peterpanstechland/RoboPlanter/docs/deployment/docs-hardware-20261029.md

# 文档与接线更新 · 2026-10-29

本次只更新文档、公开网站和接线教学，不刷写设备或修改本地凭据。事实基线为此前固件、联调记录以及用户最后确认的手机实时土壤/温湿度查询。

## 更新范围

- 手册18页/语言：新增当前硬件连接、YOYO日常交互、补齐此前遗漏的日签发布页；同步根README和固件入口说明。
- 当前外设：SEN54独立5V且信号3.3V；SERVO1继电器GPIO42空载、SERVO2超声波GPIO8、SERVO3环境光GPIO1、SERVO4打印GPIO7，返回GPIO44；RGB GPIO40；Indicator土壤GPIO27与内置蜂鸣器GPIO19。M2及GPIO43不用。
- 交互接线图更新九个接口/预留位置、供电与信号路线、模块模型；预留口只确认留空。SVG总览和离线HTML同步。
- 更新Skill 0.4.0、配对码位置、共享番茄钟、场景打印开关/冷却、已验收与待测边界。
- 白名单下载包补充bonded_access/focus_session/sen54/water_tank依赖，保留私有文件隔离。

## 检查

- public-starter测试7项通过，包含本地固件头文件及核心测试脚本的依赖完整性、逐文件哈希、确定性、隐私排除和三张新增页面的双语言导出。
- Honor Skill包测试2项通过；下载版本0.4.0，不含旧单次读取密钥。
- 三个接线JavaScript文件语法检查通过。
- Docusaurus en/zh-Hans生产构建通过。既有webpack依赖警告和缓存写入提示不影响输出。
- 浏览器查看SEN54/打印机/预留口/Indicator；预留口确认留空，土壤显示RP2040 GPIO27。390px宽度检查无横向溢出；SVG总览目视文字完整。

## 实物边界

YOYO读取已通过；手机开关灯/共享计时/自动场景小票和长中文、重启重连仍待测。蜂鸣器程序已部署但未听音验收；水箱与泵负载未完成。配对提示大字修订仅编译未刷。

公开源文件与下载来自tools/sync_docs_site.py，网站更新限于RoboPlanter目录及项目索引的受控区块。发布提交与CI结果在对应GitHub PR和Actions记录，不把本地构建等同于线上部署。
