peterpanstechland/RoboPlanter/docs/handbook/product-story.md

# 你先下班，我负责发芽。

**YOYO工位绿植搭子（RoboPlanter）**，是一盆能对话、能看见真实植物状态，也能留下一张纸质日签的桌面伙伴。

工作日里，我们经常一边赶进度，一边忘了喝水、起身，甚至忘了窗边还有一株薄荷。这个作品从一个小念头开始：如果照顾植物的那一下，也能成为照顾自己的提醒，会怎样？

我们把真实绿植、像素养成、荣耀 YOYO 和热敏打印装进一个 Creeper 风格的方块外壳。熟悉的黑色像素表情负责让人愿意靠近，真实传感器负责让每一次回答有依据，屏幕和纸张把短暂的对话变成看得见、留得下的反馈。

绿植、像素屏、荣耀 Robot Phone 与日签出口的装配展示

*CAD 装配展示，非成品实拍。打印件为 Body8 / 9 / 16；手机图像取自[荣耀官方素材](/roboplanter/assets/assembly-hero-sources.json)。*

## 从到工位，到给自己放个小假

### 早上：给今天一个轻一点的开头

“早上好，上班打卡。”

小芽可以先接一句：“已到工位。今天争取长片叶子。”场景自动打印开启时，打卡表达会触发日签：顶部是植物小电脑 Logo，下面留出三行手写待办。写什么、完成多少，由你决定。

这里的打卡是一段工位仪式，不是公司的考勤记录。自动打印可以关闭；一句普通问候、一次状态查询，也不必都变成一张纸。

### 午后：看看植物，也看看自己

“现在土壤湿度百分之多少？”

YOYO 从主控取得校准后的土壤百分比，和 Indicator 使用相同的干湿参考点。温湿度、空气颗粒物、VOC、环境光和水箱距离则帮助你了解它周围的环境。没有有效读数时，界面会说明状态，再引导你检查连接或校准。

设备和屏幕同步在线时，30 颗灯珠亮绿色；在 Indicator 开启补光后变为白色，关闭补光后回到状态显示。触摸屏始终留在桌面上，放下手机也能查看和操作。

### 开完会：把一句吐槽，变成一个能带走的片刻

“今天开了很多会。” “心累，想摸会鱼。”

小芽先简短回应，再按你的偏好生成“会议幸存签”或休息日签。小票把植物状态、待办和一句工位幽默放在一起，最后随机抽取完整 78 张塔罗中的一张，并包含正位或逆位。

塔罗提供一个有趣的反思话题。屏幕打开预览时抽牌并固定，翻看七页后再确认打印，纸上保留同一张牌；自动切纸后，就得到一个可以贴在工位、夹进手账或送给同事的小物件。

这套场景脚本和设备端打印已有实现；屏幕到纸面的完整流程已实测，手机自动触发的全部场景仍在逐项联调。具体依据见[功能状态](roadmap-evidence.md)。

## 屏幕里养一株，桌面上长一株

Indicator 的首页是一只可互动的植物精灵。从一颗种子开始，选择薄荷、九层塔、蔷薇或多肉，通过游戏照料逐渐成长。植物状态、工位信息、照片和番茄钟组成日常页面，语言、亮度、主题和联网设置也可以直接在屏幕上修改。

像素植物提供即时反馈，真实植物留下需要等待的变化：新叶、分枝、花蕾。精灵的生命条和工位心情是游戏状态；真实生长阶段需要实际观察，不能由一次浇水或一轮番茄钟直接判定。游戏浇水只改变游戏，实体水泵有单独的操作与保护条件。

## 为什么是手机、屏幕和纸

**手机负责说出来。** 荣耀 Robot Phone 上的 YOYO 接住自然表达，Skill 把需要执行的意图交给 XIAO，并解释返回结果。

**屏幕负责看得见。** SenseCAP Indicator D1 让读数、表情、预览和设置常驻桌面，也显示哪段连接出了问题；普通断线可以保留手机绑定重连。

**纸负责留得下。** 日签把一次数字交互变成一个触手可及的纪念，而三行留白把最后的表达留给使用者。Printr 的日常打印仪式给了我们启发，植物角色、传感、屏幕预览和蓝牙打印链路由本项目实现。

**XIAO 负责让这些事情对得上。** 校准、设备动作、共享计时和结果由同一个主控协调。手机经加密 BLE 连接 XIAO，Indicator 经 Wi-Fi/HTTP 连接 XIAO，XIAO 再直接通过 BLE 连接 EM5826H 打印机。土壤采样来自 Indicator 内部 RP2040，并上传至主控。

## 从作品走向复现

外壳只需打印 **Body8、Body9、Body16，各一件**；Body20 是尺寸参考体。软硬件 BOM、接线、两块板的构建、校准、YOYO Skill 和接口文档都可以从项目手册继续查到。

我们希望这个搭子陪人慢一点：看见一株植物正在生长，也允许自己在还没做完所有事的时候休息。

[制作教程](hardware-quickstart.md) · [软硬件 BOM](hardware-catalog.md) · [日签设计](daily-ticket.md) · [三端工程 API](system-api.md) · [Printr 灵感来源](https://xninety9.github.io/Printr/)
