peterpanstechland/RoboPlanter/design/models/roboplanter-all-in-one/viewer/index.html

RoboPlanter / 一体机

# 把一株绿意，放在手边。

Tripo生成 · 外观概念模型

重置视角 自动转台

正在载入外观模型

请稍候

拖动旋转 · 滚轮 / 双指缩放

仅作外观参考，非工程 CAD 或制造尺寸依据。
