peterpanstechland/RoboPlanter/docs/deployment/honor-platform-status.md

# 荣耀平台接入记录

## 2026-11-03 独立入口重建

旧技能 `RoboPlanter工位盆栽伙伴`（ID `6ea58dd2d841465fbcf6689d3814d30e`）重新私有发布后，平台显示已上架，但用户手机仍显示已下架，连普通“你好”也无法进入。此次按用户要求新建独立条目，未修改设备蓝牙绑定或已经验收的打印链路。

新条目：**RoboPlanter工位小芽 1.0.0**，slug `roboplanter-workmate`，ID `96fbbd3c7947445f836919c40d33add0`，内部 skillVersion=1。Android、智能家居/环境、原创头像、五个原有官方工具和关闭 APIKey 的配置已保存。完成安全检测流程后提交私有发布，刷新列表确认 **已上架／私有发布**，页面记录时间为 **2026-11-03 15:50:06**。没有取得单独的检测评分报告，不把发布按钮可用表述为全面安全认证。

旧条目只提供“下架”，没有删除入口；提交后刷新确认 **已下架／私有发布**，页面记录时间为 **2026-11-03 15:51:18**。新条目使用独立标识，手机须安装“RoboPlanter工位小芽”，不再通过旧会话进入。

新包 SHA256：`1e7a2d39ce6efbdd689ff1ba535b1285cc44383df5000eaf11d10d2cefa5d857`，9,642 字节、三文件。旧平台 0.4.1 三文件已备份于本机 `build/honor/replaced-skill-20261103/`，未包含到新包。新源码与上传包一致，打包与两项凭据拦截测试通过。

用户安装新入口后，于2026-11-03确认“新入口能正常回复”，普通问候已通过，旧入口的加载故障在新条目中未再出现。新入口的实时读取及打印仍待验证。已经验证的是 XIAO 直接 BLE 打印，以及 Indicator 经 HTTP 请求 XIAO 后 BLE 打印，均比例正常并自动切纸；不能据此宣称新技能全部硬件功能已恢复。新技能保留现有语音浇水限制，不把硬件泵就绪误写成语音启动已开放。

随后读取测试中，用户反馈手机要求重新配对，而 Indicator 配对码按钮不可点击。主控实际记录第二次连接在 `authenticating` 后进入 `pairing_timeout`，失败码99；同时仍保存 `paired=true`。代码核对发现旧界面在已有绑定时关闭配对按钮，主控也拒绝再次打开登记窗口，缺少显式恢复入口。因此新增 Indicator 确认页与本地 `repair_yoyo` 操作，完成安全清除后才开放新码；不能把这次蓝牙认证问题再归因于已恢复的 Skill 加载入口。

2026-11-03 16:12（北京时间），配对恢复修订固件完成真机认证，主控记录 `auth_mode=13`、`paired=true`、`connected=true`、无认证错误，手机绑定已保存。期间曾遇到两分钟窗口过期，重新开启后进入输入码与认证成功状态；蓝牙广播本身正常。新入口读取与语音打印仍需独立验证，见[配对恢复记录](yoyo-companion-v2.md#2026-11-03-配对恢复修复)。

### 1.0.1 校准后的土壤读数

用户确认手机连接恢复后，要求YOYO使用已经校准的土壤湿度。现有主控的`soil`查询已返回`S:raw:percent:valid:calibrated`；问题在于1.0.0默认的`desk`摘要只提供原始ADC。因此1.0.1使用现有`soil`查询的percent，完整工位状态再单独查询`env`，无需重刷主控或重新配对。默认不播报原始值，不在模型内重新计算校准；无效、过期、未校准与有效0%明确区分。

三个技能文件已保存到原`roboplanter-workmate`条目，刷新后逐文件回读与本地一致。平台安全检测流程结束后发布按钮可用；未取得独立检测评分报告。选择“私有化发布”，沿用用户已经同意的隐私、数据和版权声明，提交后列表显示 **审核中／私有发布**；尚未确认已上架或手机获得更新。独立版本包`roboplanter-workmate-1.0.1.zip`为10,629字节，SHA256 `2f2225c3cd5d973bbeb1ce82abe6aab0c8efe58015cae0f595456e3dbe3d4538`。打包及两项既有凭据检查通过。手机实际百分比播报仍待验收。

16:18（北京时间）旁路观察到请求`e5f6g7h8`从accepted到completed，主控经BLE发送73,832字节，用时8,691ms，无传输错误，手机加密连接保持。助手未另发打印；尚待用户确认是否为其主动语音请求，以及纸面内容、比例和切纸，故暂不标为YOYO打印物理验收通过。本机审核截图`build/diagnostics-20261103/honor-workmate-101-review.png`与诊断日志均保留在忽略目录。

## 历史记录：2026-10-28 及之前

当前草稿（2026-10-28）：**0.3.2无凭据对话与联通诊断版**。用户指出0.3.1安全检测仍报“硬编码的认证令牌与设备凭证”后，已用公开根文件替换私有正文，移除临时读取值与单次读取入口，保留自然对话及固定无效凭据诊断。平台版本、metadata和引导语已同步；逐文件回读根文件与两份参考说明，未发现16位十六进制单次读取命令。原私有值不得复用。

13:27:39再次主动撤销设备临时会话，设备返回`disabled:true`。重新发起安全检测后未再弹出此前高危结果，界面恢复“真机测试／发布”可用；未获得独立评分或完整检测报告，因此不把按钮状态描述为全面安全认证。尚未发布0.3.2或更新手机安装版。打包器新增定向阻断临时读取凭据的检查，根文件及两份参考文件注入合成凭据的回归通过；公开源码打包检查通过。

最新现场结果（2026-10-28）：现有私有0.2.2 Skill单次土壤读取再次通过，用户反馈原始值 **2105**，临时会话已撤销。温湿度与环境光现场响应通过，Indicator恢复联网及土壤上传。下列日期段落保留各次历史状态，不代表重新审核或发布。

同日对话更新：平台已保存私有 **0.3.1草稿**（公开无凭据包0.3.0），增加同会话承接、短句口语、少追问、闲聊不访问硬件、换话题不自动退出。重新加载后回读确认正文、版本及对话段落保留，唯一BLE请求与0.2.2完全一致，未重新开启临时读取窗口。未提交本版安全检测或真机测试发布；手机已验收版仍是0.2.2，新对话与实际语音延迟尚待手机验收。

2026-10-24，开发者账号 Peter。控制台入口：[YOYO 智能体平台](https://developer.honor.com/cn/manageCenter/app/E00225?~id=225)。

| 项目 | 当前结果 |
| --- | --- |
| LLM 智能体 | `RoboPlanter盆栽伙伴` 已创建并保存草稿；指令、开场白、引导示例和原创头像已配置。 |
| 智能体 ID | `661af41a3ab74a17b70b0357052e0773`，版本 1。 |
| MCP 插件 | `RoboPlanter盆栽工具` 已提交团队内部发布，平台显示“审核中”；未勾选发布到插件市场。 |
| 插件 ID | `182dbe5d082142d8b193837c47d768a2`，版本 1。 |
| 工具导入 | 专用 Bearer 鉴权成功，平台显示“调试通过”，六个工具全部导入。 |
| 平台调用 | `get_planter_state` 与 `get_action_result` 均实际调试通过，分别响应 `unavailable` 与 `unknown`，原因为 `gateway_unavailable`；均为只读。 |
| 独立 Skill | `RoboPlanter工位盆栽伙伴` 已导入并保存0.2.0草稿；Android、智能家居/环境、原创头像与两条引导语已配置。声明官方 `ble_send_command,skill_exit`，当前禁止硬件调用，只允许对话与退出。 |
| Skill ID | `6ea58dd2d841465fbcf6689d3814d30e`，slug `roboplanter-companion`，平台内部skillVersion=1。 |
| Skill检测与发布 | 已运行安全检测并刷新进度，界面已开放“真机测试/发布”按钮；未记录检测评分，不把按钮可用解释为硬件测试通过。返回“我的技能”已确认条目状态为“草稿”。未提交Skill发布或比赛作品。 |
| A2A | 未实现、未注册；独立 Skill + 官方BLE工具主线不需要A2A服务。 |
| 智能体绑定 | 草稿插件未出现在“我的插件”绑定列表；按官方流程，等待插件审核通过后绑定。智能体自身仍是草稿。 |
| 发布与真机 | 插件团队内部发布审核中，未上架市场；未通过 YOYO 手机端与真实花盆端到端验证。 |

服务地址为 `https://emqx.robomon.cn/roboplanter/mcp`。MCP 专用 token 只应通过平台鉴权配置传递，不放入插件描述、提示词、工具参数或技能包；EMQX 管理员密码、MQTT 密码与 XIAO 令牌不提交荣耀。

本轮根据官方活动页“两赛道均提交Skill服务”的要求，将独立Skill改为参赛主线：YOYO → 官方BLE工具 → XIAO；Indicator保持本地Wi-Fi HTTP。已有云服务和插件保留为辅助，不再等待插件审核来推进Skill。Skill的`hardware_ready:false`是提示词行为限制，不是已验证的平台强制权限开关；固件执行器仍默认禁用。没有向平台上传设备令牌，没有把自建MCP名称当成Skill工具。

Skill文件包含根目录`SKILL.md`和两份`references`，平台读取到两个工具、0.2.0版本及`hardware_ready:false`；Android为唯一选定运行环境。[技能配置截图](honor-skill-draft.png)。头像及两条引导语已保存；未添加其他测试账号，未触发手机硬件测试。当前欠缺设备鉴权安全注入、手机MTU/长写与NOTIFY回包、实际烧录及外设联调。

云端已通过公网鉴权、初始化与六工具发现，荣耀控制台也已完成状态工具调用。当前无真实网关，状态返回 unavailable，四个动作工具全部拒绝且 `sent=false`。平台调用成功不等同于设备已连接。

界面截图：[智能体草稿](honor-agent-draft.png)、[已导入六个工具](honor-mcp-six-tools.png)、[插件审核中](honor-plugin-in-review.png)。完整服务器与 MQTT 验证见 [基础设施记录](../../integrations/cloud/INFRA-DEPLOYMENT.md)。

本地 `.env.cloud` 一度仅 Peter 与 SYSTEM 可读。经用户明确授权，临时给 `PeterWIN\CodexSandboxOffline` 添加只读权限，用于将 MCP token 填入荣耀鉴权框；读取完成即撤销。凭据未写入本记录或截图。插件请求参数的默认 token 仍留空，调试时通过专用鉴权字段输入。

团队内部发布与发布声明分别经用户明确确认，提交前保持“允许发布到插件市场”未勾选。页面最后确认结果为“审核中”，不是“审核通过”。官方说明：[智能体配置插件](https://developer.honor.com/cn/doc/guides/101645)、[插件介绍](https://developer.honor.com/en/doc/guides/101637)。

## 2026-10-26 本地与云端联调进展

- 两板均刷入本轮联调固件，Indicator 的 RP2040 经内部 UART、ESP32 与同局域网 HTTP 将真实土壤原始值传给 XIAO。用户确认屏幕 ADC 显示与灯带开关正常；过期与恢复测试通过。
- 通过既有跳板从本项目云端专用配置恢复当前电脑的私有凭据，启动原有只读 MQTT 网关。公网 MCP 实际查询返回 ADC 2516、有效、未校准、百分比为空；没有修改 Broker ACL 或开放云写。
- 用户手机的原0.2.0 Skill 实际回复“联调中／未接入”。只读控制台核对确认 `hardware_ready:false`，APIKey 开关关闭；官方文档未说明如何把该 Key 安全注入 BLE 参数。
- 因此准备0.2.1固定诊断：仅明确请求“测试蓝牙联通”时向实际广播 RoboPlanter-A994 发送 `S|probe|soil`，预期 `E:AUTH`。电脑已用完全相同请求实测通过。该响应只证明传输与鉴权拒绝，不能当作正式读数成功。
- 控制台内部版本2随后更新为私有0.2.2单次土壤读取包，见下文；公开源码继续保留无凭据的0.2.1。手机更新与实际回包尚待验收。未向平台提交正式设备令牌。
- 现有 LLM 智能体只读查看为“审核中”，表单锁定；未撤销审核或修改其配置。该智能体与独立 Skill 是两条不同入口。

### 私有0.2.2单次读取验收

用户明确授权将一个独立的临时只读值提交现有 RoboPlanter 私有测试 Skill，以完成手机真实读取。它不是正式设备令牌，不含 Wi-Fi 或 MQTT 密码；只允许一次土壤查询，开启后最多十分钟有效，重启、撤销或首次正确请求立即使之失效，不能控制执行器。

设备端已实测普通查询／执行器／HTTP 权限隔离、单次读取、重复拒绝、到期拒绝和撤销拒绝。电脑 BLE 第一次得到 `S:2522:x:1:0`，只代表有效、未校准的 ADC 原始值；这不是手机验收结果。

平台根文件正文已经回读核对一致；平台自动把 metadata 从行内 JSON 转为等价 YAML。基本信息显示0.2.2和“读取实时土壤”引导语，APIKey 开关保持关闭。安全检测实际报告“硬编码敏感令牌”高危项，不能表述为无风险通过。该检测暴露了正式产品不能依赖提示词保存凭据的问题；本次仅在用户已明确同意临时值进入 Skill 的范围内，使用平台仍开放的“真机测试 → 发布真机测试 → 确定”流程。未点击市场发布，未新增测试账号，也未改正式鉴权机制。

发布流程已返回，列表仍显示“草稿／私有发布”；列表的这一标签不能证明手机已安装新版本。单次会话于2026-10-26 06:54:15（北京时间）开启，最迟07:04:15失效。随后用户在 Robot Phone 测试并明确反馈“读出来2529了”。据现场反馈，手机已显示真实土壤原始值2529；本次没有另行保存手机工具的原始 NOTIFY 日志，不能据此声称已验证其他查询、长写或手机执行器控制。

06:55:43，管理端主动撤销本次会话，设备返回 `disabled:true`。三设备单次读取路径为 **Indicator RP2040 ADC → 内部 UART → Indicator ESP32 → 同局域网 HTTP → XIAO → BLE → Robot Phone YOYO 私有 Skill**。只读 MQTT 云查询是另行验证的辅助路径，不能把手机的这次 BLE 成功描述为原生 MQTT 调用。2529仍是未校准的原始 ADC，不能换算为含水率或作为自动浇水依据。当前0.2.2只用于这一次验收，临时权限已结束；正式持续使用仍需完成安全凭据下发。

## 2026-10-28 传感器与手机复验

登录恢复后回读现有私有0.2.2 Skill，设备仍为RoboPlanter-A994，能力仍限一次土壤读取；没有修改平台正文或重新发布。11:41:18开启的会话因用户离开未使用，11:51:18到期，12:00:26又主动撤销确认。

用户随后明确表示准备好了并授权新会话，12:19:48开启，原定最迟12:29:48失效。用户在手机请求“读取实时土壤”后反馈 **2105**；这是用户现场反馈的手机读数，没有另行捕获原始NOTIFY。12:25:20主动撤销，设备确认`disabled:true`。未授权也未通过本次会话控制任何执行器。

土壤仍未校准；温湿度和环境光已在Indicator完成现场响应确认，但本次Skill没有获得读取这些字段的临时权限。Wi-Fi配置持久化与重连、固件哈希和传感器采样结果见[现场验收记录](../handbook/acceptance.md#同日最终现场验收)。持续使用仍需完成正式安全凭据下发，不能把单次诊断权限当作常驻授权。

## 2026-11-04 校准百分比固件修订

用户报告手机仍播报原始ADC。现场HTTP确认原标定有效；原默认desk只含raw、soil第一项含raw，仍易被旧技能或错误的位置解析使用。修订默认soil为Soil:百分比% calibrated，desk为带S/T/H单位的校准摘要；原始ADC使用soil_raw，原结构保留在soil_v2/desk_v2诊断入口。XIAO已刷入并验证，用户确认手机现有入口返回百分比且与Indicator接近。

本地Skill1.0.3与BLE契约、验收清单已更新并打包。本轮没有操作荣耀平台，没有重新发布条目，不把本地版本当成手机当前安装版本。
