peterpanstechland/RoboPlanter/docs/handbook/acceptance.md

# 安装与功能检查

按“软件检查 → 只读采集 → 单项外设 → 手机接入”的顺序检查安装结果。操作前阅读 [硬件入门](hardware-quickstart.md)，异常处理见 [故障排查](troubleshooting.md)。

## 当前台架验收摘要 · 2026-10-29

- 已通过：SEN54温湿度/PM2.5/VOC、环境光遮挡、超声波距离变化；继电器空载300ms后释放。
- 已通过：Indicator土壤上传、手机SC+MITM首次绑定、YOYO“读取工位状态”返回土壤/温度/湿度。
- 已通过：Indicator七页日签与实印一致、128行正确比例、中文和自动切纸；设备侧会议场景小票。
- 已通过：主控共享计时开始/暂停/继续/结束。待测：手机计时、开关灯、自动场景打印、重启重连、长中文、系统提醒和蜂鸣器听音。
- 用户已确认：独立12V/150mA泵、水箱、进出水与实际35/61/80mm水位标定完成。本机泵已启用，一次500ms命令完成并停泵，用户确认有出水、随后停止；水位下降保护、流量和启动电流仍待实测。土壤参考已保存并通过重启检查，实际基质条件仍需确认。

## 2026-10-29 自动灯光设置与启用水泵

- 新入口“设置 → 灯光设置”：实时ADC、自动模式开关、开/关两个阈值、加减100、采当前值和显式保存。主控每秒采样，至少三份连续数据及两秒稳定期后切换，中间区间保持原状态；数据无效/过期时自动模式关灯。
- 灯光设置独立NVS保存，修订号冲突不覆盖；泵运行时拒绝保存，保存期间不接受新浇水，停泵通道保留。Indicator或YOYO手动灯光命令暂停自动控制，保存或重启恢复已保存的自动模式。
- 主机测试通过：自动灯光状态机、数据过期、持久化损坏/失败、严格类型与运行互锁；客户端新增30项自动灯光检查，设置UI共76项；原有核心、网络、打印、字体与公开源码测试通过，两板构建通过。
- 实机：低光约107时自动开灯；主控重启后配置恢复且再次开灯；手动关灯后保持暂停，未被自动重新打开。校准与手机绑定保留，重启时泵关闭。测试结束恢复自动模式关闭、初始阈值1200/1800，用户可自行开启和调整。
- 泵功能此前由私有编译配置关闭；收到用户实物就绪确认后启用，没有改公开默认值。测试时有效水面距离37mm，位于满水35mm与停泵61mm之间；只发送一次500ms浇水，结果completed并回读on:false，不据此声称流量或实体缺水保护已验收。
- 只更新两块ESP32应用分区，保留NVS及RP2040。XIAO app SHA256：`54d18783252dc4b65cb8812deecdb4b3b4b8c82773a9be030525881d6bcfdd81`；Indicator：`60b2e2a088a52651ae3bea8b7150be8adc840b61bfd78c62ee0a2e20f8a35884`。Indicator显示、触摸与存储初始化通过；用户确认实际短出水后停止，并确认灯光设置页面、触摸和保存正常。后续只读核对时，主控自动模式仍为关闭、阈值1200/1800；未替用户改写。

## 同日较早阶段：屏幕校准工具

- 新增“设置 → 花盆连接 → 传感器校准”，支持土壤干/湿、水箱满水/缺水停泵/空箱，五份稳定新样本、显式保存和分组清除；中英文均有原生字号布局。
- 主控使用带版本/修订号/校验值的单条NVS记录；土壤换算、场景小票、BLE土壤查询、HTTP和水位保护共用运行时值。泵运行时拒绝修改，写入过程不持有泵定时锁，校准不会启用执行器。
- 软件验证：校准范围、方向、冲突、持久化失败/损坏、清除后重启、运行中互锁、采集稳定性和严格JSON解析；客户端34项校准场景检查，设置UI64项检查；原有控制、打印、联网与字体回归通过。
- 实机拒绝了相等的干湿点、倒置的水箱距离和过期修订号，参考值未被更改。已有土壤参考干2536/湿1597、修订1在主控重启后保持，手机绑定也保留。该结果验证保存链路，不替代对所用基质的确认。
- 水箱参考仍为未标定。泵 `enabled:false/on:false`，没有发送泵、灯或打印动作。只更新两块ESP32的应用分区，保留NVS，RP2040未刷写。Indicator更新时发生一次USB串口中断，完整重刷与校验后，日志确认显示/触摸初始化、80%背光、Wi-Fi自动重连与土壤HTTP上传。用户随后确认“屏幕已亮，触摸正常”。
- 该阶段提示改进版尚未刷入，后续自动灯光固件已包含它。下方检查表是复现步骤，不代表每项都已通过；末尾旧DHT20/单次土壤记录是历史。

[接线总表](../wiring.md) · [详细状态](roadmap-evidence.md)

## 1. 记录配置与结果

复制以下记录头到自己的本地报告。报告可以放在本地 `build/acceptance/`；原始日志和视频可能含个人或设备信息，不要自动纳入公开仓库。

```text
测试时间与时区：
测试人或本地代号：
仓库版本/commit：
本地修改说明：
XIAO/载板型号与硬件版本：
XIAO 固件版本与配置（不含秘密值）：
Indicator 固件版本：
手机型号 / MagicOS / YOYO 版本：
Skill 技术名 / 展示名 / 版本：
入口：离线单测 / 本地 HTTP / Indicator / Skill / BLE
device_id / 硬件型号：
外设启用状态与本地最大泵时长：
相关日志与图片：
检查结果：通过 / 失败 / 未执行 / 不适用
```

每一条再记录：**输入 → 前置状态 → 请求 ID → 实际通信结果 → 实物观察 → 结论**。分享记录前去掉密码、令牌和个人账号信息。

## 2. 软件检查

先验证本机，不接设备。基础命令见 [硬件上手](hardware-quickstart.md) 与各测试目录。新设备接入基础层使用：

```bash
python3 -m unittest discover -s tests -p test_device_kit.py -v
python3 -m unittest discover -s tests -p test_mcp_result_validation.py -v
python3 integrations/device-kit/device_kit.py validate integrations/device-kit/profiles/*.json
python3 integrations/device-kit/device_kit.py mock-check \
  --profile integrations/device-kit/profiles/xiao-roboplanter-v1.json \
  --fixture integrations/device-kit/fixtures/xiao-state.json
```

成功时最后一条仍应报告 `offline_fixture_only`、`hardware_verified=false`、`yoyo_bound=false`、`execution_enabled=false`。土壤未标定或数值未知时 `usable=false`，不是测试失败，也不是“植物缺水”。

现有 MCP 模拟测试另外需要其文档指定的 Python 和固定依赖：

```bash
python -m unittest discover -s tests -p test_mcp_bridge.py -v
```

这些测试使用 mock 或本机回环服务，不是设备联调。出现 Python 或 MCP 版本不符时，记录“环境阻塞”，不能把未能导入的测试记为通过。不要为了跑测试把服务启动到公网，也不使用真实设备凭据替换 mock。

检查 C++ 控制核心时，按 [核心测试说明](../../tests/core/README.md) 执行；其中的定时、队列、ID 去重与取消行为验证软件逻辑。它们不能验证接线、电流、实际液体流量或驱动板默认电平。

## 3. 只读采集检查

按 [硬件上手](hardware-quickstart.md) 完成型号、供电、备份、刷写和空载启动。最初所有可选传感器和执行器保持禁用，泵、打印机及原载板负载物理断开。通过后一次只加入一种外设。

| 编号 | 操作 | 应记录和通过的条件 |
| --- | --- | --- |
| B01 | 查看空载启动与只读状态 | 目标型号和固件正确；未启用的值为未知；泵没有启动 |
| B02 | 验证同一设备身份 | Indicator、本机 HTTP 与串口观察对应同一 XIAO；不能只凭设备名字相似 |
| B03 | 接入单个传感器 | 字段、单位、供电与原始范围合理；有通信检测的数字传感器拔除后应无效。模拟 ADC 断线可能仍在范围内，不能仅凭 `valid` 判定探头存在，须另做断线/饱和与现场比对 |
| B04 | 土壤未标定 | 保留原始 ADC 和未标定标志；不生成土壤百分比、不推断自动浇水 |
| B05 | 完成土壤标定 | 干/湿端实测记录、方向与范围正确；百分比仍只是此探头/介质的相对值 |
| B06 | 断开 XIAO 网络 | 显示失联或不可用；屏幕游戏仍可运行但不能伪装新传感器数据 |
| B07 | 恢复网络 | 重新读取当前状态；没有自动重放此前提出的动作 |

采样年龄和有效性分别检查。HTTP bridge 的新鲜度门限不能覆盖设备自己的失效判断；BLE 设备返回 `E:STALE` 时保留过期状态。SEN54空气湿度、VOC指数、PM浓度和环境光原始值各自保留单位，不能换算为土壤含水量、CO₂或PAR。

## 4. Skill 对话与联通检查

先按[当前Skill接入](ble-integration.md)完成0.4.0安装和系统蓝牙绑定，六位码在Indicator显示。私有单次读取和0.2诊断包不再是当前验收路径。

| 操作 | 预期结果 |
| --- | --- |
| “读取工位状态” | 返回真实土壤/温湿度；未知值保持未知，土壤原始值不当百分比（已通过） |
| “打开灯”“关灯” | 只执行所请求动作，匹配业务结果并观察实物（手机待测） |
| “开始25分钟番茄钟”“暂停”“继续”“结束” | Indicator与主控一致；手机断连不清零，主控重启清零（手机待测） |
| “今天开了很多会” | 自动打印开启时至多一张会议日签；同场景五分钟限流（手机待测） |
| “以后别自动打印”后再次说场景话术 | 开关持久关闭，只聊天；明确手动打印仍可请求 |
| 查询、解释、否定“别打印这次” | 不附送小票，不重复先前场景 |
| 浇水 | 当前水箱/水泵未就绪，明确没有执行 |
| “退出盆栽伙伴” | 调用skill_exit，不自动停止已经运行的计时 |
| 重启并重连 | 绑定仍在，无重复配对或重放旧动作（待测） |

检查工具轨迹、设备身份和业务回包。BLE绑定鉴权与HTTP令牌是不同路径；不要在Skill正文里写HTTP令牌或配对码。

## 5. 外设与异常处理检查

完成当前设备的加密绑定和只读业务回包后，再逐项进入这一阶段。真实水泵最后测试，先用电平观察或合适的测试负载；详见 [BLE 联调](ble-integration.md) 和 [排障](troubleshooting.md)。

### 只读与错误传播

| 编号 | 测试条件 | 预期行为 |
| --- | --- | --- |
| D01 | 全部执行器禁用，查询土壤/环境 | 完整请求到达正确设备；对应通知被手机收到；未知和未标定值保持原样 |
| D02 | 未绑定或未加密BLE；错误HTTP令牌 | 各自明确拒绝；没有动作；不输出秘密值 |
| D03 | 选错设备或找不到设备 | 不转而控制另一台；工具错误和设备身份清楚 |
| D04 | 数据过期或 `valid=false` | 不报告为“当前正常”；不由此自动浇水 |
| D05 | 无 NOTIFY、畸形/截断回包、ID 不匹配 | 结果未知或明确错误；不把 GATT 写确认当动作完成 |
| D06 | 断连后出现旧连接回包 | 不将旧数据或旧请求结果套到新连接/新动作 |

[官方 BLE 参数](https://developer.honor.com/cn/doc/guides/101781) 区分 `ack_type=ack` 的写确认与 `expect_response=true` 的业务响应等待；成功码说明和 Schema 的 `0/200` 差异仍需实机记录。当前v2状态短命令不含令牌；带中文的场景命令仍需实测MTU/长写和完整通知，不能由短查询成功推断长命令通过。

### 单项动作、断网和重复请求

每个新动作生成新 ID；查询保留原 ID。HTTP ID 长度与 BLE 短 ID 约束不同，按 [设备协议](../device-protocol.md) 和 [BLE 契约](../../integrations/yoyo/skill-draft/references/ble-contract.md) 分别执行。测试中有意重发只用于受控台架验证去重，不能成为正常客户端超时重试策略。

| 编号 | 测试条件 | 通过条件 |
| --- | --- | --- |
| D07 | 明确开灯，再明确关灯 | 只有灯动作；匹配请求结果；实物亮灭分别确认 |
| D07a | 逐项选择 solid/breath/chase/rainbow，再在动态效果中关灯 | HTTP effect 匹配；单灯 chase 按约定呼吸；关灯无需等完整周期，实测延迟记录 |
| D07b | 同 ID 重试默认/solid，随后换模式；关灯带 effect | 默认/solid 不重启；换模式冲突；off+effect 拒绝；复位后默认关灯 |
| D08 | 中英文小票各一次；已确认带刀的设备启用切纸 | 受理与 UART 发送完成分开记录；实物字形、单张出纸和切断人工确认；超时不补打，发送失败后恢复锁定 |
| D09 | 同 ID、同参数的重复包 | 设备只执行一次；重复响应可指向原结果 |
| D10 | 同 ID、不同参数 | 冲突明确拒绝，不执行替换后的动作 |
| D11 | POST/写操作送出后断网或响应丢失 | 客户端报告 unknown；只按原 ID 查结果，不换 ID 再发 |
| D12 | 结果查询未命中、设备刚重启 | 保留“不确定”；不把记录缺失当成“肯定没执行” |
| D13 | 缓存达到上限 | 新普通动作拒绝；已知记录保留；停止策略按本地实现验证 |
| D14 | 请求超过允许时长 | 拒绝或明确说明限制；不拆成多次脉冲绕过 |

### 水泵、停止与中途退出

| 编号 | 测试条件 | 通过条件 |
| --- | --- | --- |
| D15 | 外设禁用时请求浇水 | 不起泵，明确拒绝 |
| D16 | 允许的短脉冲 | 实际起止、电平/负载、设定时长、请求 ID 对应；停止由 XIAO 本地完成 |
| D17 | 起泵后手机断连、网络断开 | 即使没有下一条网络消息也在本地时限内停止 |
| D18 | 起泵后用户退出 Skill/关闭应用 | 不取消设备自己的截止时间；重新进入不重放动作，按原 ID 查询或现场检查 |
| D19 | 传感器无效/过期时明确要求停泵 | 停止不等待传感器分析；记录真实动作结果与实物停机 |
| D20 | 停泵命令响应丢失 | 不能口头保证已停；保留未知、使用现场停止，不反复发新 ID 赌网络 |
| D21 | 重启、掉电再上电 | 泵默认关闭，不恢复旧动作；重新读取设备状态 |
| D22 | Indicator 与手机同时操作 | 结果关联到各自 ID；没有另一入口覆盖后误报当前动作的情况 |

首次台架可按硬件教程将本地最大泵时长降至 1000 ms、用 500 ms 请求测试；Indicator 默认请求时长也必须同步降到不超过当前上限。软件 `completed` 仍不等于测得水量；没有流量标定时不报告毫升。

网络停止不是物理急停。测试者必须在现场能切断泵支路，不能为了复现网络异常取消硬件保护。某一项失败就保存日志并回到相应层排查，不用更换 ID 或重启反复尝试来掩盖未知结果。

## 6. 界面与扩展检查

### 虚拟照料和真实控制

由不熟悉项目的人分别执行“给屏幕小植物浇水”和“给真实花盆浇水”。观察对方能否在点击前说出哪一个会启动真实泵。若分不清，即使技术通信正常也应判体验失败，优先修改入口、文案和反馈。浏览器演示、本地养成奖励和真实设备动作分别标注；屏幕计时完成不证明手机能后台提醒。

### 用户自带硬件

[设备平台](device-platform.md) 的当前验收是三套 profile 可被离线验证、未知数据保持未知、登记后不能偷偷换 profile、`hardware_id` 与设备数据匹配，以及没有网络调用和执行入口。

通用 BLE 模板通过不等于任意蓝牙设备可用；灌溉 planned profile 通过不等于现场控制器可部署。新适配器要重做实际报文、身份、断线、联锁与单设备验收。多用户、多设备选择、绑定/解绑和远程调度需要单独测试，当前没有完成这些能力。

### 云端辅助查询

使用云端查询时，先检查服务、本地网关和设备连接。健康检查仅表示进程存活；真实网关缺席时状态应为 `unavailable`，结果可能为 `unknown`，四个动作工具包括停止均应拒绝且 `sent=false`。云查询与手机 BLE 分别检查。

## 7. 反馈问题

记录最小复现步骤、固件与手机版本、首条异常日志及相关请求ID，再按 [排障手册](troubleshooting.md#如何提交一份可复现的问题记录) 整理问题。设备令牌和完整 Flash 备份留在本地。

## 历史记录：2026-10-28 DHT20 与土壤上传检查

该阶段的DHT20/Air已由SEN54替代，单次凭据方案也已由0.4.0加密BLE绑定替代；不要照此恢复旧接线或旧权限。

- 用户确认温湿度模块为 Grove Temperature & Humidity Sensor v2.0，按 Seeed 官方资料及 Aosong DHT20 规格实现 I²C 0x38、CRC、状态检查、有限转换等待和 30ms 总线超时。每2秒测量；失败样本不会沿用前次温湿度。未实现异常工厂校准寄存器的恢复写入，异常会保持无效。
- XIAO 已核对芯片身份、校验上一版 app，并只更新 app 分区；NVS、Wi-Fi、设备令牌及现有灯带/打印配置保留。新 app SHA256：`94fbda9c41106dab3f94b0d9b5c391ff0dc7735229d911f10e25033eb9a08ab0`。
- 鉴权 HTTP 连续12次查询均收到有效温湿度，25.11–25.15°C、47.49–49.84% RH。它证明本机驱动已经与模块通信；尚不等于精度标定、现场刺激/拔线恢复或 YOYO 手机验收。
- Indicator 的 HTTP 周期由“请求完成后再等1秒”改为“按本轮开始时间计1秒”。原12次土壤查询有7次有效；调整后两轮各12次全部有效，第二轮数据年龄1520–2454ms。保留原3000ms失效阈值与传输年龄预算，没有通过延长有效期掩盖延迟。这是短时现场观察，不代表长期压力测试。
- Indicator app SHA256：`893bc7d46baa8eb7982249a90fe8081cc611e4ada7acead8c10fa4df16e2985b`。显示/触摸/打印布局未修改；本轮没有为了采集测试额外出纸或驱动水泵。
- 本轮验证：134项DHT20协议检查、490项控制器检查、78张塔罗双方向/双语言及预览一致性检查、既有屏幕网络/设置回归、公用源码打包5项检查通过；两板构建通过。真实断线恢复、模拟输入响应和手机操作仍须现场完成。
- Air Quality v1.3、UV v1.1 的3.3V分线尚待确认，采集保持关闭；超声波/水泵未接入。本轮荣耀控制台跳转到登录页，尚未更新或发布 Skill，也未重新激活已撤销的单次土壤权限。

### 同日后续：环境光替换与断电重连

- 用户确认温湿度随手靠近有变化，确认SERVO2/D9为空气输入、SERVO3/D0为模拟光输入。随后明确将UV换成Grove Light Sensor v1.2。旧UV读数不作为光敏模块的UV测量证据。
- 新增独立 `ambient_light.enabled/raw/valid`，保留旧 `uv` 字段但本机关闭UV；Indicator显示“环境光 / Ambient”，使用原始0–4095值，不标lux。正式鉴权BLE支持`ambient`查询，现有临时Skill仍只有一次土壤读取权限。
- XIAO环境光版已刷入并校验，SHA256：`67aa9d564ac4bcc57965ab93e90c338b3bb563c807669560f141ff019085d364`。一次20样本观察中环境光2351–2364、空气120–123、温湿度均有效；尚未完成有标签的遮挡/照亮对比，不把ADC有效标志当作模拟模块接线或精度验证。
- 这轮同时发现Indicator断连使土壤全部过期；系统没有沿用旧土壤数值。恢复联网后已观察到HTTP 200上传。NVS实测首次保存成功，下一次硬件复位读到`saved=1`，但认证失败使旧逻辑停止重试。修订为首次连接成功保存、已知网络认证失败30秒重试、手动新密码失败不重试且不覆盖旧配置。日志只记录状态类别、保存标志，不记录密码或设备令牌。
- 本轮检查：128项设置检查（含成功保存、重启读取、已知网络认证失败重试、手动错密码保留旧值）；18项环境光解析检查；50项停止/切网和162项打印回归；584张实际固件主机渲染帧含中英文环境光页；6项字体检查。截图用于布局验收，不代表真实硬件读数。
- 荣耀登录恢复后只读核对现有私有0.2.2 Skill。自动审批最初拒绝新会话，用户随后明确允许本次10分钟单次读取。设备于11:41:18开启，11:51:18到期；用户离开电脑未测试，12:00:26又主动撤销确认。未产生手机成功验收，不自动延长权限；平台正文未改、未重新发布。

### 同日最终现场验收

- Indicator最终app SHA256：`e62c6892b80c50c06c56cb9a1b3bfa7769bba9ee847d0545d21911d37d2068e7`。只更新app分区，保留NVS及RP2040固件。复位启动日志显示`saved=1 storage=1`，随后自行连接已配对网络并连续约65秒收到土壤上传HTTP 200；证明已保存配置可在重启后自动读取、连接。本轮没有另做人工拔电后的冷启动验收。
- 最终连续12次查询中土壤、空气、环境光和温湿度全部有效：土壤2100–2120、空气113–117、环境光2349–2364；最后温度约22.80°C、湿度48.63% RH。UV保持关闭。用户另行确认“显示正常，数值随明暗变化”，环境光显示与遮挡响应通过；这些ADC值不代表照度或空气质量标定。
- 用户准备好手机并明确授权后，于12:19:48开启新的最多10分钟、只读一次土壤会话。用户对YOYO“读取实时土壤”的现场反馈为 **2105**；据此确认现有私有0.2.2 Skill已返回土壤原始值。没有另行捕获手机工具原始NOTIFY日志，不据此扩大到其他查询或执行器验收。
- 12:25:20主动撤销临时会话，设备确认`disabled:true`。土壤尚未校准，不报告湿度百分比。平台正文及发布状态未修改；持续使用的安全凭据下发仍待完成。
