peterpanstechland/RoboPlanter/design/concepts/2026-10-25-all-in-one/01-product-board.png

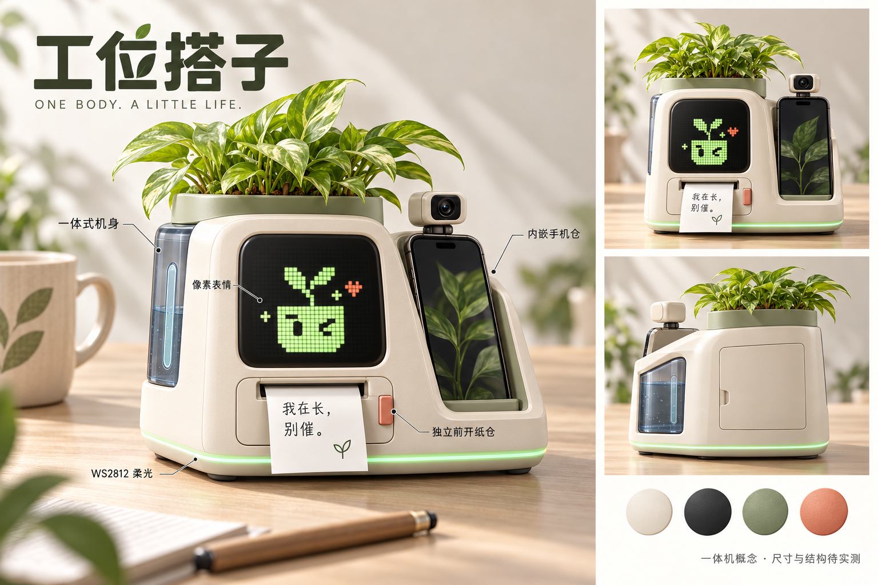
design/concepts/2026-10-25-all-in-one/01-product-board.png
