peterpanstechland/RoboPlanter/design/concepts/2026-10-25-all-in-one/02-service-layout.png

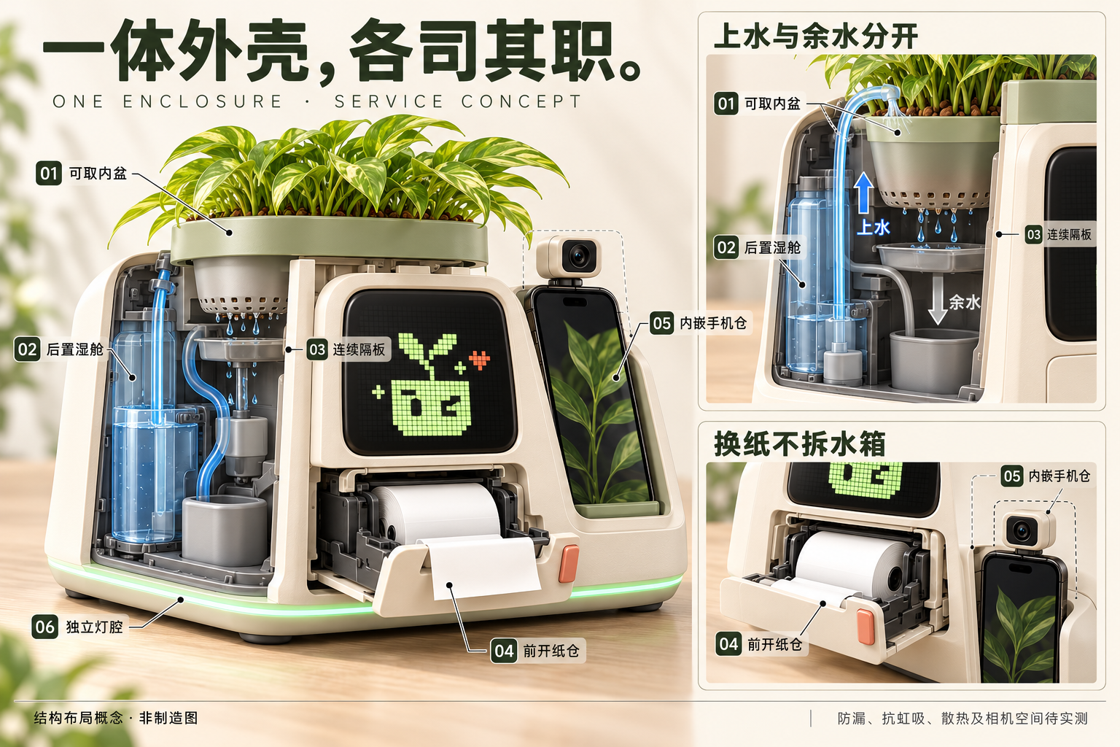
design/concepts/2026-10-25-all-in-one/02-service-layout.png
