peterpanstechland/RoboPlanter/design/concepts/2026-10-25-companion-v2/01-product-board.png

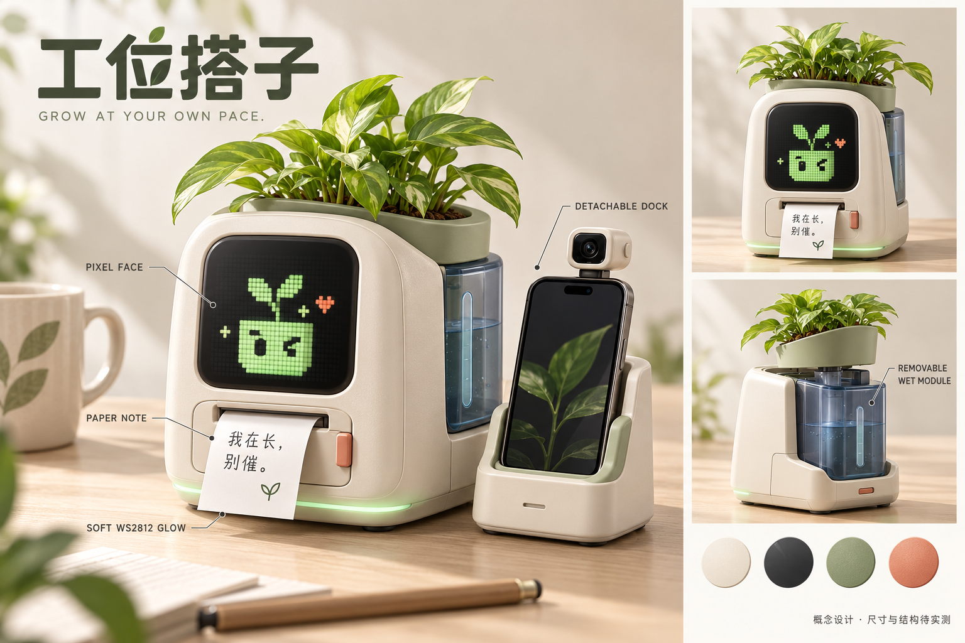
design/concepts/2026-10-25-companion-v2/01-product-board.png
