peterpanstechland/RoboPlanter/design/models/roboplanter-all-in-one/reference.png

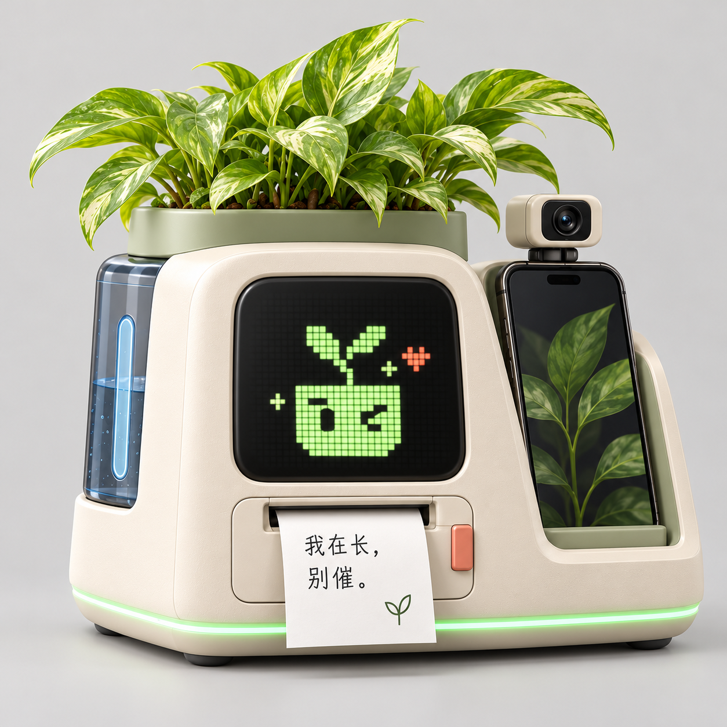
design/models/roboplanter-all-in-one/reference.png
