peterpanstechland/RoboPlanter/design/models/roboplanter-all-in-one/viewer-preview.jpg

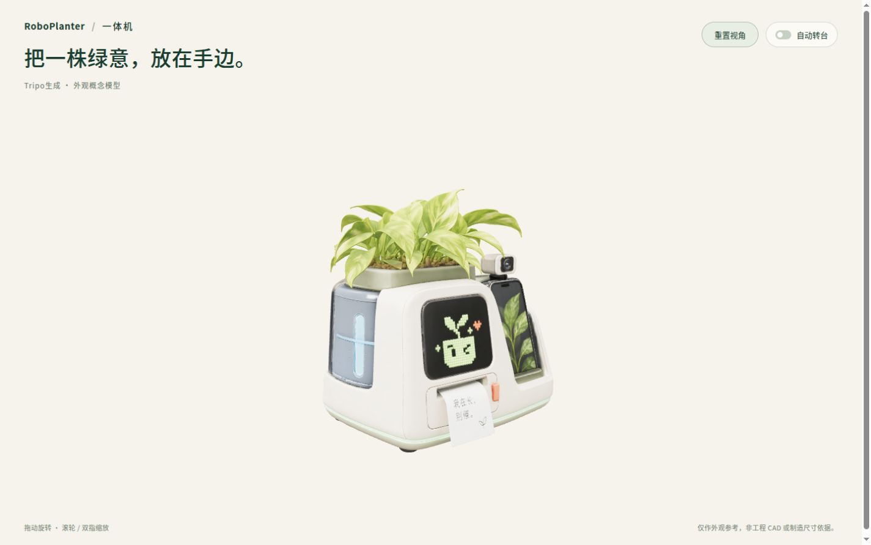
design/models/roboplanter-all-in-one/viewer-preview.jpg
