peterpanstechland/RoboPlanter/docs/deployment/honor-agent-draft.png

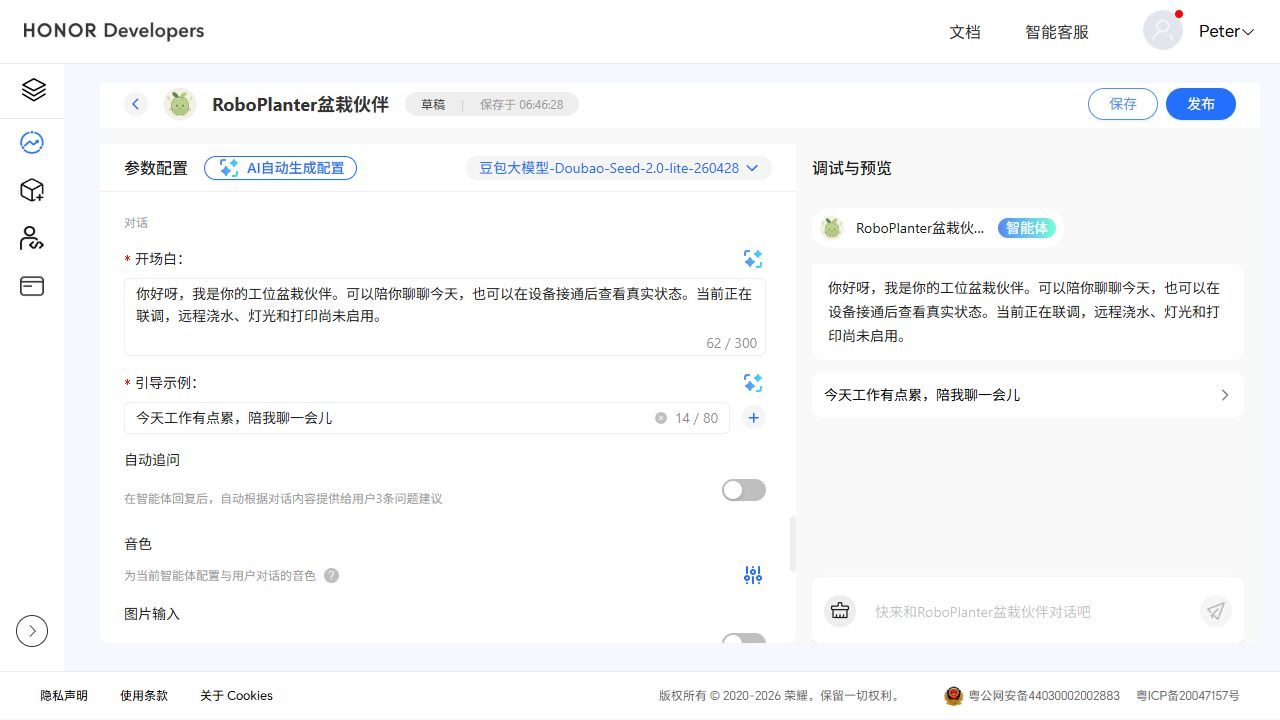
docs/deployment/honor-agent-draft.png
