peterpanstechland/RoboPlanter/docs/deployment/honor-mcp-auth-ready.png

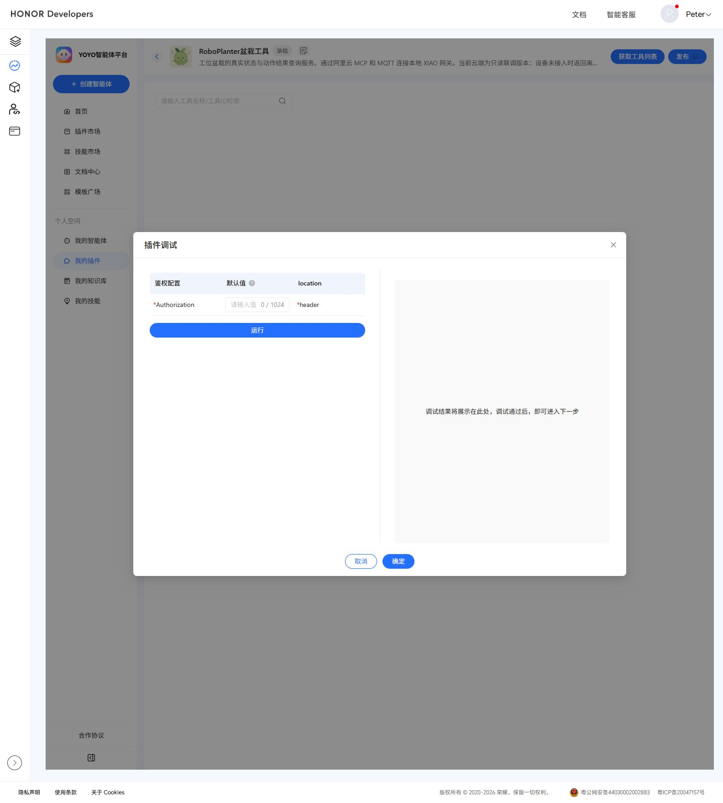
docs/deployment/honor-mcp-auth-ready.png
