peterpanstechland/RoboPlanter/docs/deployment/honor-mcp-six-tools.png

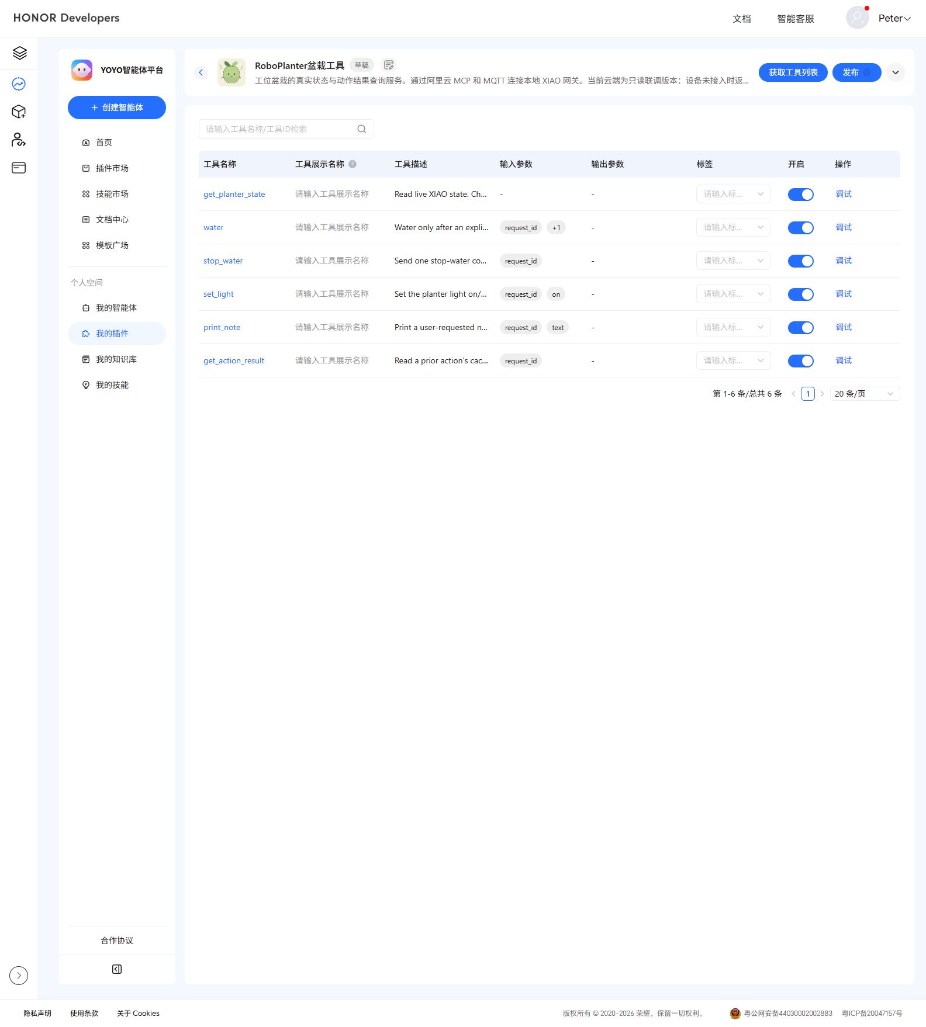
docs/deployment/honor-mcp-six-tools.png
