peterpanstechland/RoboPlanter/docs/deployment/honor-plugin-in-review.png

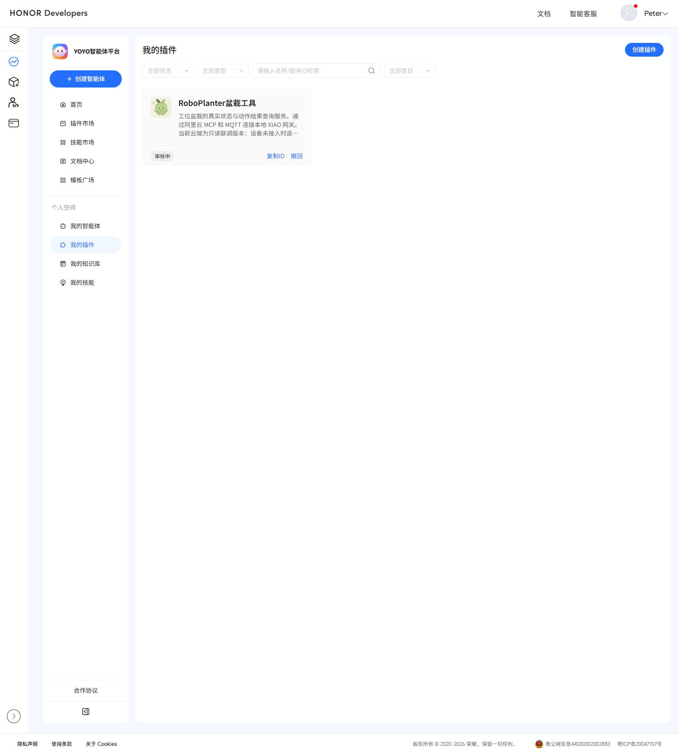
docs/deployment/honor-plugin-in-review.png
