peterpanstechland/RoboPlanter/docs/deployment/honor-private-publish-confirmation.png

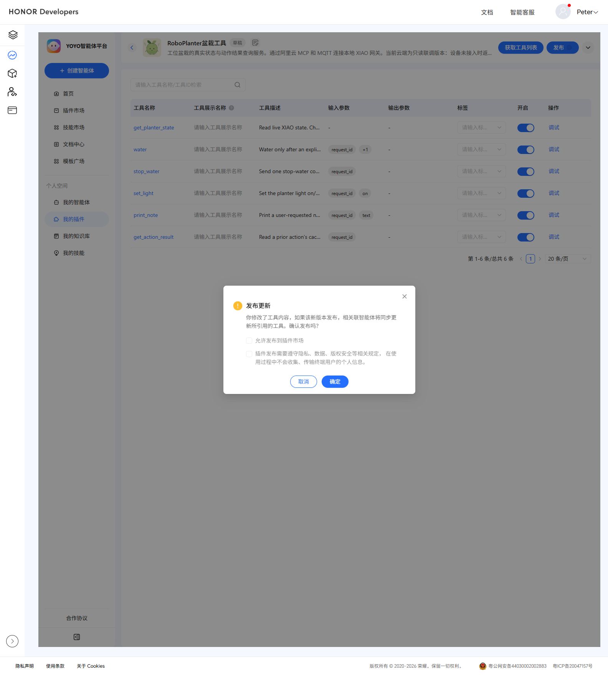
docs/deployment/honor-private-publish-confirmation.png
