peterpanstechland/RoboPlanter/docs/deployment/honor-skill-draft.png

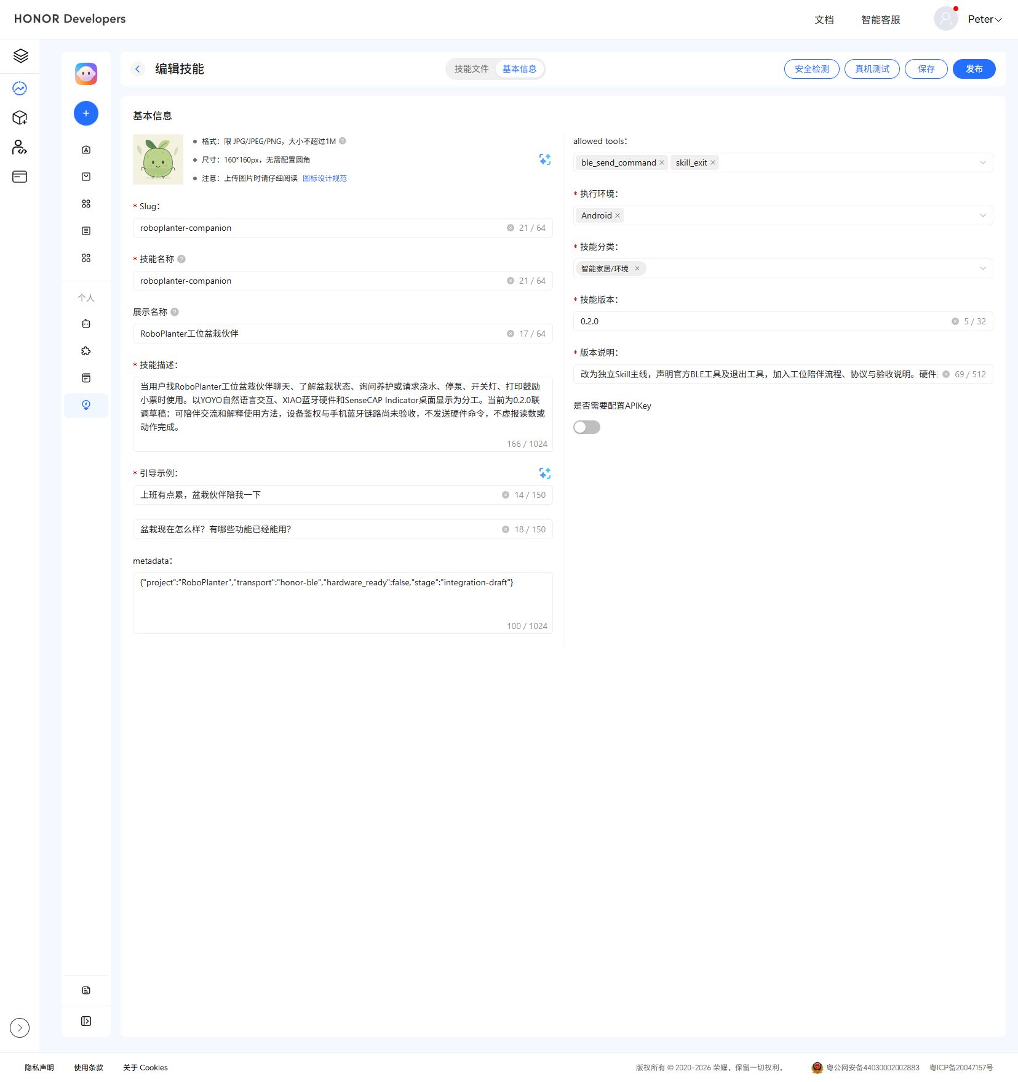
docs/deployment/honor-skill-draft.png
