peterpanstechland/RoboPlanter/docs/previews/indicator-garden-overview.png

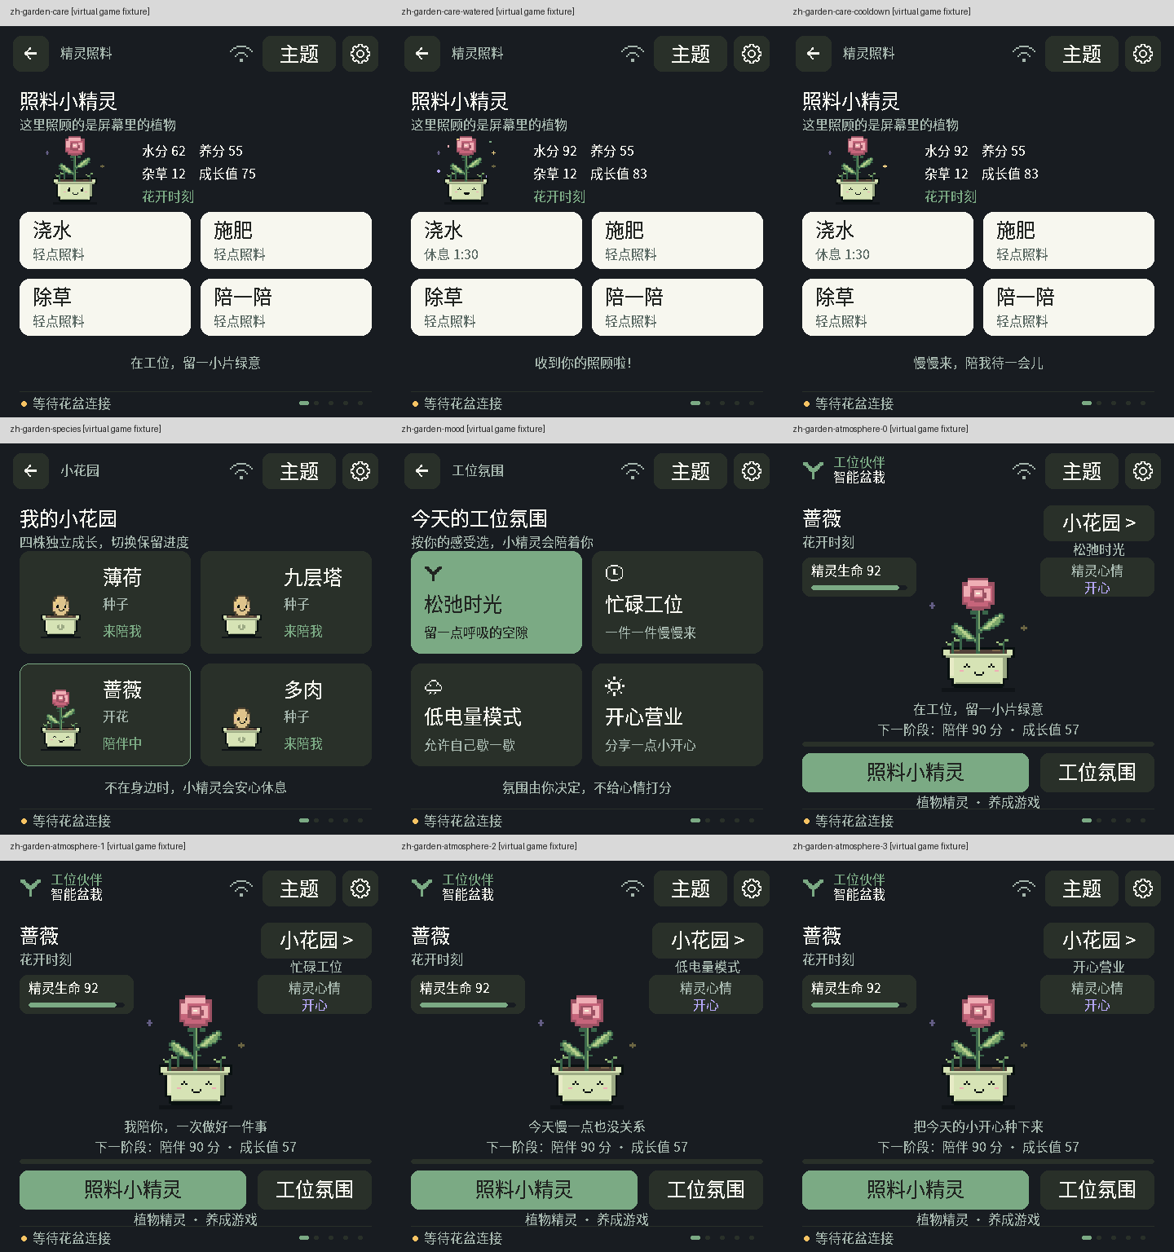
docs/previews/indicator-garden-overview.png
