peterpanstechland/RoboPlanter/docs/previews/indicator-settings-main.png

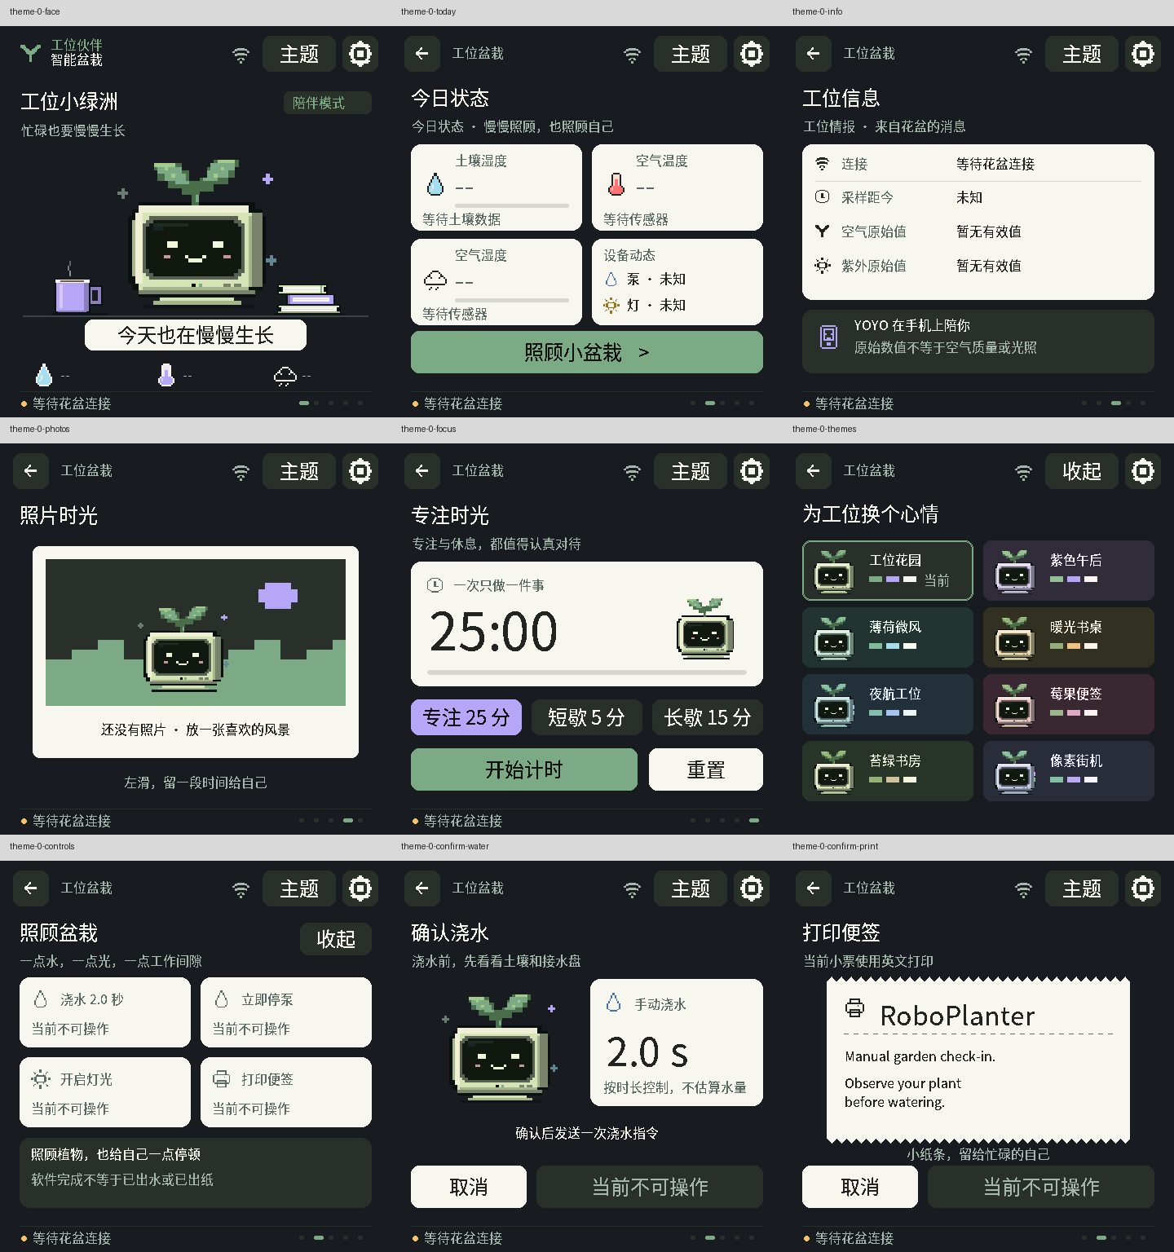
docs/previews/indicator-settings-main.png
