peterpanstechland/RoboPlanter/docs/previews/indicator-settings-menu.png

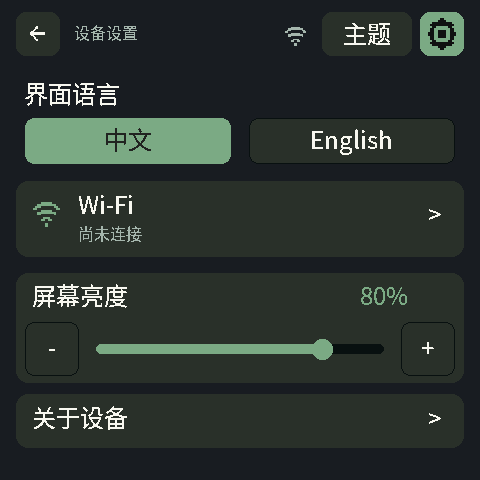
docs/previews/indicator-settings-menu.png
