peterpanstechland/RoboPlanter/docs/previews/indicator-settings.gif

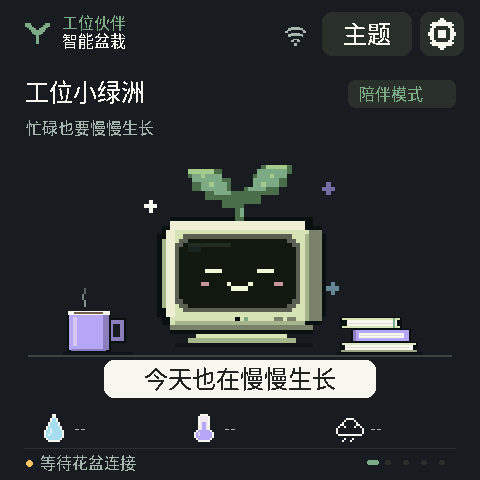
docs/previews/indicator-settings.gif
