peterpanstechland/RoboPlanter/docs/previews/indicator-worker-overview.png

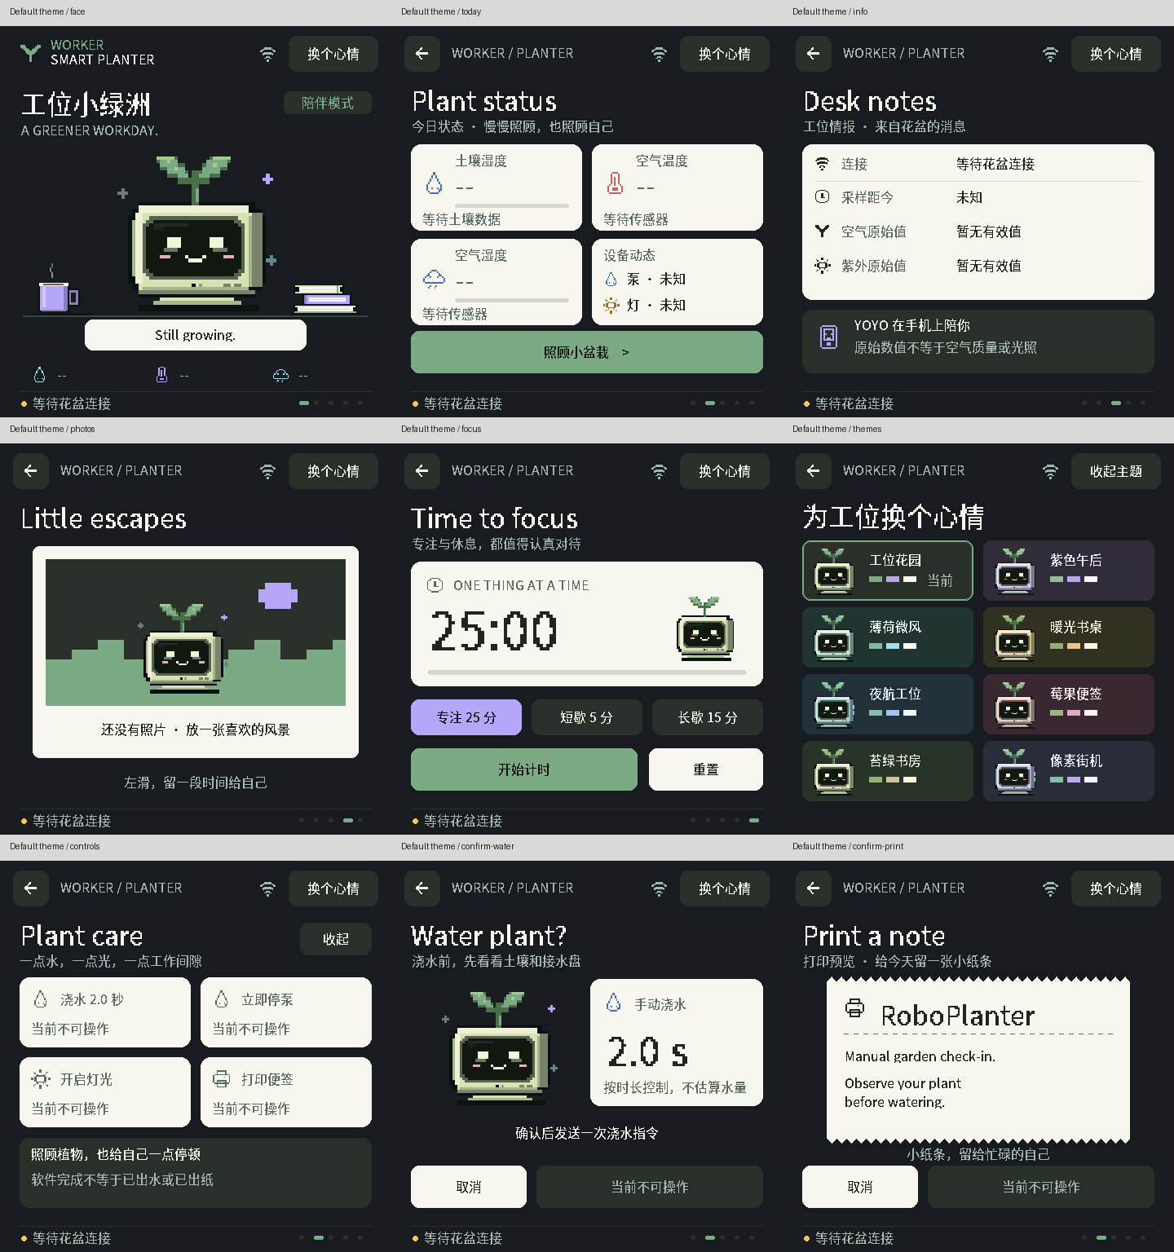
docs/previews/indicator-worker-overview.png
