peterpanstechland/RoboPlanter/docs/previews/indicator-worker.gif

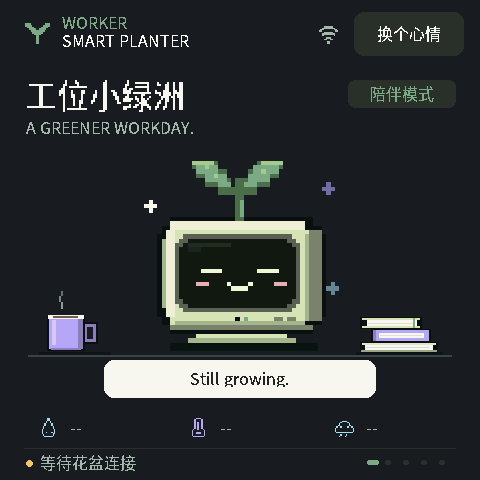
docs/previews/indicator-worker.gif
