peterpanstechland/RoboPlanter/integrations/yoyo/assets/roboplanter-160.png

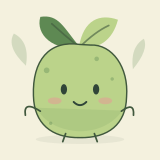
integrations/yoyo/assets/roboplanter-160.png
