peterpanstechland/RoboPlanter/design/print/Body16.3mf

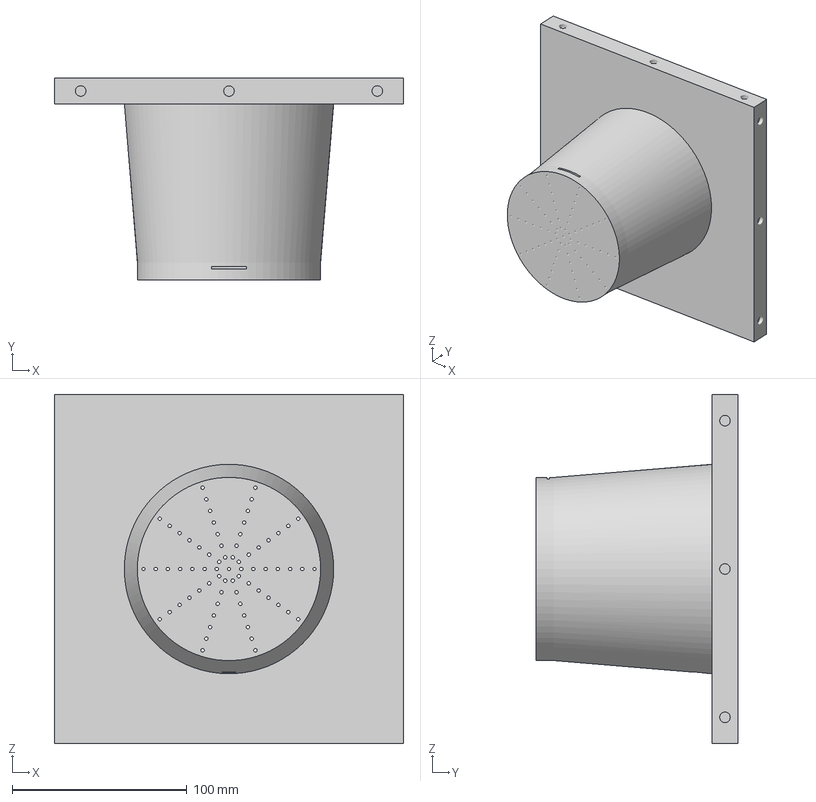
[picture p27: CAD file, 2026-11-13]
design/print/Body16.3mf
200.0 x 115.8 x 200.0 mm
