peterpanstechland/RoboPlanter/design/print/Body9.3mf

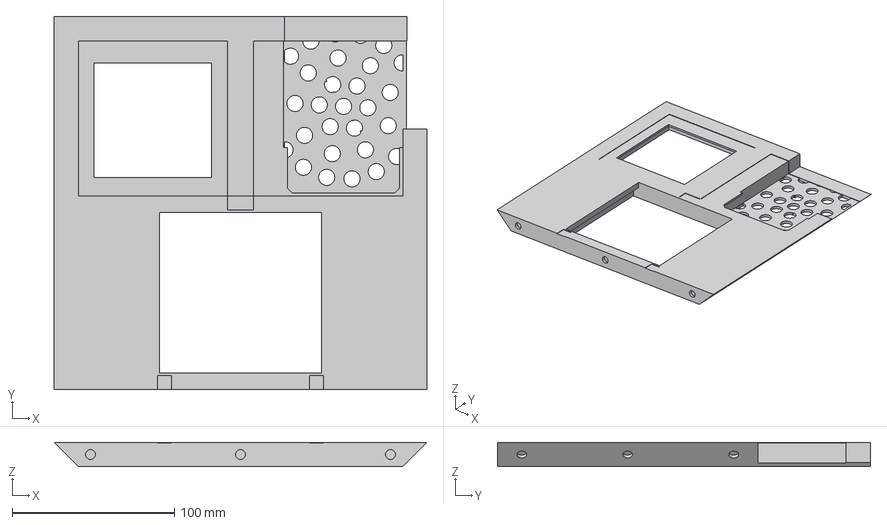
[picture p28: CAD file, 2026-11-13]
design/print/Body9.3mf
230.0 x 230.0 x 15.0 mm
