peterpanstechland/RoboPlanter/design/print/Body8.3mf

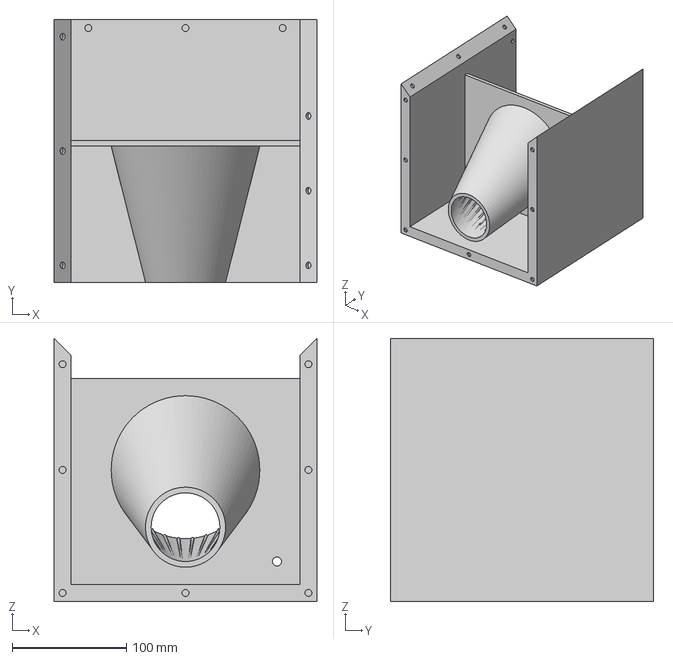
[picture p29: CAD file, 2026-11-13]
design/print/Body8.3mf
230.0 x 230.0 x 230.0 mm
