peterpanstechland/RoboPlanter/docs/deployment/printer-raster-20261028.md

# 2026-10-28 中文小票与切刀联调

实现提交：`378b037`。协议依据用户提供的 [escpos-sample](https://github.com/peterpanstechland/escpos-sample/tree/60f85d4e8cbcce8956528c7a2d1d0344aa2adf55)。使用说明见 [UART 打印教程](../handbook/uart-printer.md)。本记录不包含设备令牌或 Wi-Fi 凭据。

## 软件检查

- XIAO 默认禁用外设、现场私有配置（D8 UART、115200 波特、切刀开启、10 颗灯带）均构建成功。现场版本 RAM 80,828 bytes，Flash 使用 1,966,917 bytes。
- 核心控制/光栅编码测试 493 项；字体覆盖、像素一致性和可复现生成测试 3 项通过。7,540 字符字库，384 点宽，32 行分带，最多 160 UTF-8 字节、8 行正文。
- 本地 MCP 27 项测试及 6 项灯效保护回归通过；配对工具 6 项、公开源码包 5 项测试通过。
- Indicator 设置 118 项、启动失败 84 项、STOP 隔离 50 项、打印/网络 144 项、设置界面 43 项检查通过。主程序离线渲染、帧交接和字体检查通过，中英小票和连接诊断页已检查无溢出。
- UART 写入或排空失败锁定后续打印；`completed`、`bytes_sent` 仅表示软件发送完成。缺纸、过热、机械完成状态尚未实现，不能从软件回包推断切纸成功。

## XIAO 实机

- 核对 ESP32-S3 Plus 身份和 16MB 分区后，完整备份 16MB。备份 SHA-256：`343cfccf8e512f70f3898edbb60ca9e05362871b11384c712575229e63f53650`。
- 确认 app0 已使用、app1 为空，仅向 `0x10000` 写入应用，不写 bootloader、分区表、NVS 或其他分区。写入后 esptool 哈希校验成功。
- 应用文件 1,967,280 bytes，SHA-256：`28bcbdd106827aa1683a0e3fd5c71666bd737c74868abaa4e3efb22fb3f68517`。私有固件和备份保留在 Git 忽略的 `build/device-backups/xiao-20261028-printer/`。
- 启动后原 Wi-Fi、设备令牌正常；鉴权状态返回 `text_format:utf8-raster`、`paper_width_dots:384`、`autocut:true`、`feedback:unavailable`。灯带能力仍启用，水泵仍禁用，Indicator 土壤中继配置保留。
- 请求 `cn-cut-7a8235d56f144529` 发送中文测试小票，记录到 `accepted → completed`。用户随后发现接线有误，明确要求接好后再试；第一轮不计为物理打印通过。
- 用户授权的第二轮使用新请求 `cn-cut-4fddca30708d4fa9`，同样记录到 `accepted → completed`。没有自动重发；用户明确确认“中文清晰，已自动切断”，本轮中文出纸和切刀通过。

## Indicator 实机

本轮核对为 ESP32-S3、8MB Flash。高速完整备份遇串口包噪声后停止，改为低速分块读取。前 2MB 已保存，包含 bootloader、分区表、NVS 和完整原应用；本轮没有得到完整 8MB 备份。2026-10-24 的完整备份仍保留。

原应用已核对：土壤中继启用、双帧缓冲、未编入照片。NVS 包含中文、80% 亮度、已配对 Wi-Fi、主题和植物存档。私有连接配置通过一次鉴权设备身份查询生成，保留 `PLANTER_ENABLE_LOCAL_SOIL=1`；私有构建成功（RAM 48,056、Flash 1,350,601 bytes）。

- 备份中原 app 的内部 checksum 和 validation hash 均有效，设备 `0x10000..0x1FFFFF` 与备份通过 `verify_flash` 校验。新应用擦写范围 `0x10000..0x159FFF` 完全在本次备份范围内。
- 115200 波特率仅写入新应用，1,350,960 bytes，esptool 哈希校验成功。应用 SHA-256：`404b9fed5bc269699e1ab41af25272179c7722b9501d4424e66b21305aae7ec1`。
- 启动后 `display/touch/client_task/preferences=ready`，双帧缓冲 VSYNC 正常启用。中文、80% 亮度、原植物存档 `species=0 / stage=2` 保留，RP2040 未写入。
- 实际固件及各目标文件均核对包含新的配对字段；私有值未输出。随后串口出现 `Indicator soil relay: HTTP 200`，XIAO 实际返回新的 `indicator_rp2040_grove_adc` 原始读数，证明两板鉴权链路工作。读数尚未标定，不解释为湿度百分比。
- 屏幕产生的 `screen-` 命令已出现在 XIAO 的完成记录中。用户随后确认从 Indicator 发起打印后正常出纸、切纸，端到端链路通过；同时反馈文字看起来被压缩，排版效果待进一步核对，不能把链路通过等同于视觉验收通过。

## 纸面字号反馈后的修订

用户提供照片并确认问题在纸面：“纸上的字比屏幕预览小、挤”。修订采用 32 点阵字（原 24）、44 点行高（原 32）、左右各 16 点留白、居中首行与分隔线。中文便签保持四行，调整句子以避免标点单独换行。新布局标识为 `receipt32-v1`；Indicator 直接复用同一渲染器，按等比例显示整张点阵，避免单独绘制的大标题/小正文误导纸面效果。

- 仍为 384 点、32 行分带、1,536 字节临时缓冲。八行最大高度 396 点，最大报文 19,120 字节；9600 波特率预算 24,917ms，屏幕结果等待窗口 35 秒。
- 核心检查 506 项通过，覆盖跨分带字形、独立像素位置校验、1:1 预览与打印像素一致，以及缩小预览边界。字体检查 3 项、网络打印 145 项、公开源码包 5 项检查通过；屏幕实际渲染检查通过。
- XIAO 新应用仅写 app0，2,327,600 bytes，SHA-256 `840813bb677d8a3c19da927ecb3ef7d8c8f3d88c777b0079d0a9c8cce81118c9`。刷写前与上一版回退文件比对当前应用，之后写入校验成功，鉴权状态已返回新布局标识。
- 对比小票请求 `cn-cut-74c558f7965149c3` 已单次发送，结果 `accepted → completed`；大字版纸面效果待用户反馈。
- Indicator 新应用 2,302,496 bytes，SHA-256 `ad60be7ec175360f0aec9ef430c8d30236d0f8d0e57490f02f325bcac34c238d`，低速 app-only 写入及校验成功。写入前已校验设备上旧应用与保留的回退文件一致。启动后显示、触摸、存储与网络任务正常，中文/80% 亮度和原植物存档保留，双帧缓冲初始化正常，土壤中继再次收到 HTTP 200。应用仍在原 app0 分区内，未写 NVS、RP2040 或分区表。

## 根因对照与完整日签（同日后续）

用户反馈 32px 大字版仍压缩。随后发送 `daily-6b9a01fab4a84882`：同一张纸分别用 A / 32 行、B / 128 行 GS v 0 命令打印相同 128-dot 方框和圆。用户照片及明确回复均显示 **A 被压扁，B 正常**。因此不是靠扩大字体解决，生产编码器改为每条命令固定 128 行；末块补白，内部仍只用 32 行 / 1,536 bytes 缓冲分四次生成。诊断 action 刻意保留 A 模式用于复现。布局能力升级为 `receipt32-v2` 和 `garden-daily-v2`。

新增原创嫩芽小电脑 Logo、真实植物快照、三行手写待办、完整 78 张牌名与随机正逆位、工位自省提示。大阿尔卡那有各自提示，小阿尔卡那使用花色主题与点数提示组合；原创几何卡面不是传统牌画复制。每次新预览随机抽取一次，翻页、语言变化、传感器刷新、RTOS 队列均不改已批准内容。

- 修正后完整日签请求 `daily-f67137e4487745a3` 记录 `accepted → completed`；本次随机抽中第 75 号牌（星币骑士）、正位。因 Indicator 正在刷写，快照没有新鲜读数，纸面使用未知标记而非虚构数值。
- 用户明确确认 **“比例正常、内容完整、正常切纸”**。这是修正后完整日签的实际纸面和刀具验收；并非只依据串口回包。
- XIAO 最终应用 2,346,640 bytes，SHA-256 `7156a6d2e54c0771422c864b92ce1ec28eed3be243ebad501e81dc94e55c528e`。
- Indicator 最终应用 2,325,136 bytes，SHA-256 `679e36600c8c977a7e150cc2037d1fb7caa4a147caa786d3b0dbf1a8190a0e29`。预览为 384 × 256 原始点阵窗口，七个带重叠的窗口避免边界处文字漏看；首窗完整显示 Logo、标题和副标题。
- 每次升级前核对芯片 MAC 与已保存的当前应用，保存回退镜像，仅写 app0。最终备份分别位于忽略目录 `xiao-20261028-daily128`、`indicator-20261028-daily-final`；此前 32 行版本的中间备份亦保留。没有写入 NVS、分区表或 RP2040。
- 核心检查 490 项通过（命令分块减少使逐块检查计数减少）；日签另覆盖 78 张牌 × 两种语言 × 两种朝向、拒绝采样边界、字段范围、完整预览像素一致、幂等和中断后锁定。网络打印 162 项、原 STOP 50 项与启动失败检查通过。
- 最终离线渲染 582 帧，48 项实际 UI 路由/交互、84 项动画锚点、6 项帧提交故障检查通过；包含日签翻页、边界停留、取消不打印、翻页不重抽。显示字体 6 项和公开源码包 5 项检查通过。

最终 Indicator 启动日志确认 display/touch/client_task/preferences 就绪，VSYNC 双帧缓冲启用，中文、80% 亮度、species=0 / stage=3 存档保留。RP2040 土壤中继返回 HTTP 200，XIAO 返回 fresh raw=2105、未标定，未将其解释为湿度百分比。

用户随后在最终 Indicator 固件上完成七页预览、确认打印与纸面比对，明确回复“预览翻页正常，打印内容一致并切纸”。至此，最终版从屏幕预览到同一张塔罗日签出纸、自动切纸的端到端实机验收通过。

机械状态读取仍未实现，缺纸或刀具是否动作不能从软件 `completed` 推断；以上验收依据用户实际观察。云端打印权限未修改。
