peterpanstechland/RoboPlanter/docs/deployment/landing-wiring-lab.md

# Landing page 三维接线小工坊

日期：2026-10-25。入口：`/roboplanter/#wiring-lab`。

## 实现

- 独立的轻量 Three.js 程序化教学模型，沿用页面已经使用的本地 r180 运行时；不加载 45MB Tripo 外观模型，不调用 Tripo 或其他付费生成服务。
- 依据附件 V1.0 板卡照片和原理图保留 XIAO 的 4 个 Grove / 4 个 Servo 识别关系；Indicator 的两个口归属 RP2040。布局、装饰走线及模块造型为教学简化，不是工程 CAD 或实际电路走线图。
- 九条教学路线：水位、SHT31 候选、WS2812、打印机、土壤、外置水泵驱动、空气模拟采集，以及 Indicator ADC / I²C 扩展候选。每条包含供电、信号、验证三步和实现状态。
- 自由查看支持拖动、俯视与拆层；练习模式支持拖动插头、点选接口或按钮代操作。接错时解释目标接口；接对后吸附、文字反馈、纸种子动效与进度记录，支持重试及逐件继续。
- 练习进度只存在当前页面内存，不是设备接入状态。供电和信号光点为教学路径，不是实时电流。未发现、配对、连接或控制真实硬件，没有设备请求。
- 奶油色工作台、柔和阴影、PCB 走线/丝印、金属屏蔽罩、插座卡扣、外设托盘与小表情。新增四个文本资产合计约 68KB，不包含照片、原始附件、凭据或私有设备配置。

## 验证

- 浏览器逐项验证七条 XIAO 路线和两条 Indicator 路线、步骤边界、俯视与拆层状态。
- 实际拖拽完成 IIC2 教学连接；错误 UART 目标提示正确，成功后进入验证步骤。
- 完整完成九条练习，计数从 1/9 递增至 9/9；重复练习保持 9/9。
- 390px 手机视口无横向溢出；调整取景后七个 XIAO 标签均可见。桌面及手机布局均查看；不是实体手机性能认证。
- 浏览器弱动效偏好生效后，教学按钮及完成反馈仍可操作；测试后已恢复媒体设置。
- 模拟 WebGL context 丢失，三维视图回退到 SVG，拖拽插头隐藏，文字教程、路线切换与按钮练习继续可用。测试后已恢复正常预览。
- Node 模块语法、`git diff --check`、5 项公开复现包隐私/完整性测试通过。Docusaurus 两个 locale 完整构建通过；存在既有依赖动态 require 警告。

## 边界

水位模块需按实际水箱选型，水位驱动/低水位停泵尚未实现；Indicator Grove 的 RP2040 采集和内部转发尚未实现。模拟练习完成不表示真实接线或实机验收完成。执行器电源、逻辑电平、驱动及传感器型号仍以实物核对为准。

## 发布状态

- 私有源码：`18441a6`，已推送至原分支 `codex/initial-sync`。
- 公开站点更新：[PR 55](https://github.com/peterpanstechland/peterpanstechland.github.io/pull/55)，已合并。发布分支提交 `b06c0dca`，主分支合并提交 `6b199e712ad865e757eb3545f3059514bcedd7b3`。
- Pages [40206341239](https://github.com/peterpanstechland/peterpanstechland.github.io/actions/runs/40206341239) 构建、上传与部署成功。
- 正式页：[三维接线小工坊](https://peterpanstechland.github.io/roboplanter/#wiring-lab)。线上实际三维渲染正常；练习按钮完成水位路线并显示 1/9 与正确反馈，未出现控制台错误。
- 线上实页截图：`build/review/landing-wiring-live.jpg`，未加入公开资产。
- 公开固件源码复现包仍为 141 个白名单文件、636289 字节；SHA-256 `768a76b492e16b09bf0469e40fdd039c3b365f1702c95071fe1993e032ead4b0`。Device Kit 未变。
- 除本轮源码外，既有未跟踪 `design/` 原件继续保留，没有加入公开站点或私有提交。
