peterpanstechland/RoboPlanter/web/experience/assets/assembly-hero.png

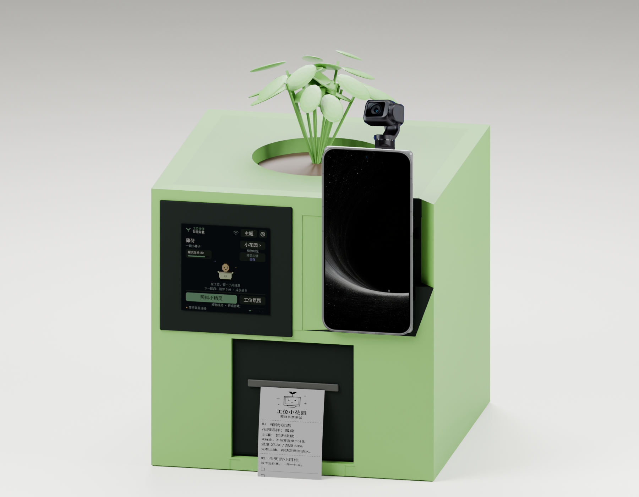
web/experience/assets/assembly-hero.png
