peterpanstechland/RoboPlanter/web/experience/assets/current-wiring-en.png

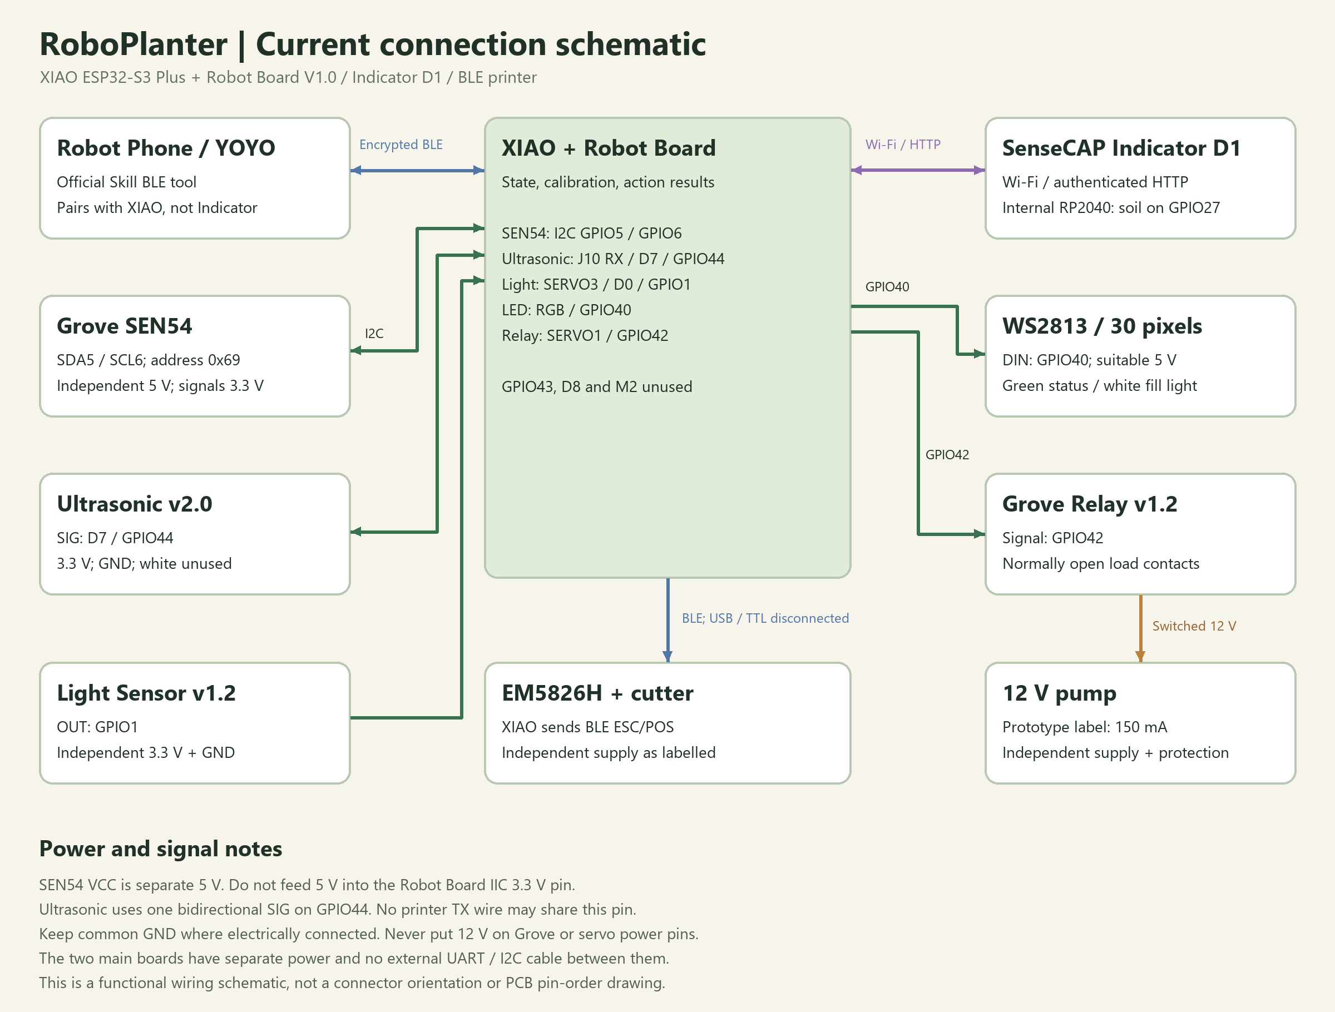
web/experience/assets/current-wiring-en.png
