peterpanstechland/RoboPlanter/web/experience/assets/printer-aspect-bench.jpg

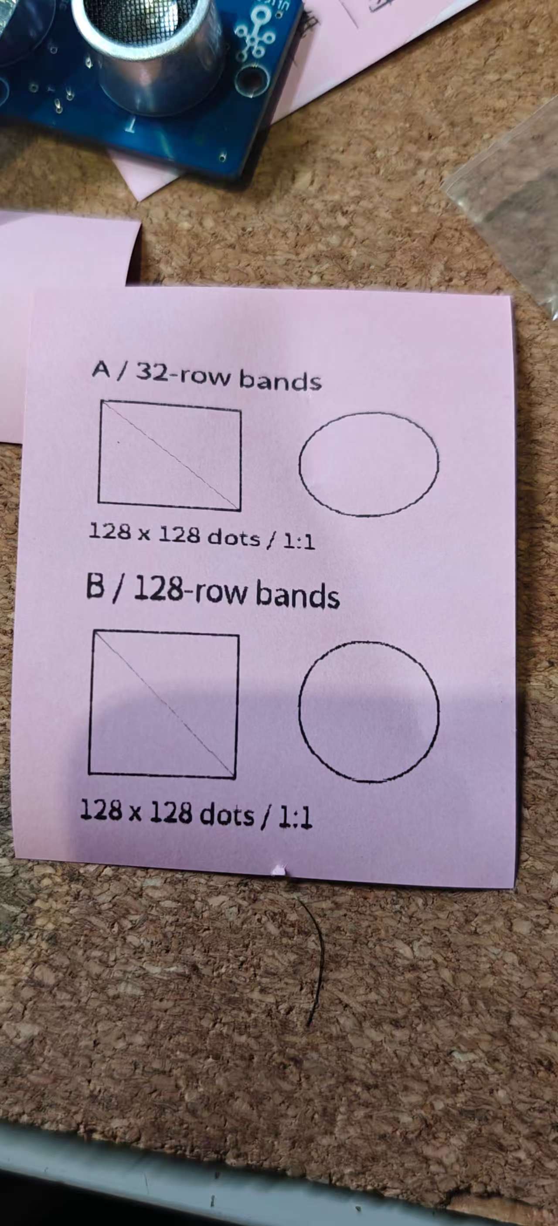
web/experience/assets/printer-aspect-bench.jpg
