peterpanstechland/RoboPlanter/firmware/xiao/src/main.cpp

#include <Arduino.h>
#include <ArduinoJson.h>
#include <Adafruit_NeoPixel.h>
#include <BLE2902.h>
#include <BLEDevice.h>
#include <BLEServer.h>
#include <BLESecurity.h>
#include <Preferences.h>
#include "bonded_access.h"
#include <WiFi.h>
#include <WebServer.h>
#include <Wire.h>
#include <driver/uart.h>
#include <cmath>
#include <cstring>
#include <string>
#include <vector>

#include "controller.h"
#include "calibration_json.h"
#include "auto_light_json.h"
#include "printer_receipt.h"
#include "daily_receipt.h"
#include "daily_json.h"
#include "printer_calibration.h"
#include "printer_transport.h"
#include "ble_session.h"
#include "ble_sensor_reply.h"
#include "robo_config.h"
#include "wifi_setup.h"
#include "ble_printer.h"
#include "remote_soil.h"
#include "diagnostic_read_session.h"
#include "dht20.h"
#include "sen54.h"
#include "ultrasonic_capture.h"
#if ROBO_WS2813_RMT
#include "ws2813_rmt.h"
#endif

namespace {
constexpr char ServiceUuid[] = "a2f39c10-7e4b-4d21-8a61-0f3bc9d15001";
constexpr char CharacteristicUuid[] = "a2f39c11-7e4b-4d21-8a61-0f3bc9d15001";
constexpr size_t MaxBleBytes = 240;
constexpr size_t MaxHttpBytes = 512;
constexpr char DefaultToken[] = "change-me-before-use";

bool credentialsConfigured() {
  const std::string token(ROBO_DEVICE_TOKEN);
  if (token == DefaultToken || token.size() < 16 || token.size() > 64) return false;
  for (unsigned char c : token) if (c <= 32 || c > 126 || c == '|') return false;
  return true;
}

const bool ActionsReady = ROBO_ENABLE_ACTIONS && credentialsConfigured();

robo::Config controlConfig() {
  robo::Config c;
  c.actionsEnabled = ROBO_ENABLE_ACTIONS;
  c.credentialsConfigured = credentialsConfigured();
  c.pumpEnabled = ROBO_ENABLE_PUMP && ActionsReady;
  c.lightEnabled = ROBO_ENABLE_LIGHT && ActionsReady;
  c.printerEnabled = ROBO_ENABLE_PRINTER && ActionsReady;
  c.maxWaterMs = ROBO_MAX_WATER_MS;
  c.tankRequired = true;
  c.tankCalibration.fullMm = ROBO_TANK_FULL_MM;
  c.tankCalibration.emptyMm = ROBO_TANK_EMPTY_MM;
  c.tankCalibration.stopMm = ROBO_TANK_STOP_MM;
  return c;
}

robo::Controller controller(controlConfig());
SemaphoreHandle_t coreMutex;
SemaphoreHandle_t sensorMutex;
SemaphoreHandle_t lightMutex;
SemaphoreHandle_t bleMutex;
QueueHandle_t printQueue;
QueueHandle_t bleQueue;
WebServer http(80);
HardwareSerial printerSerial(1);
#if ROBO_WS2813_RMT
Ws2813Rmt<ROBO_LED_COUNT> pixels;
#else
Adafruit_NeoPixel pixels(ROBO_LED_COUNT, pins::Rgb, NEO_GRB + NEO_KHZ800);
#endif
robo::RemoteSoil remoteSoil;
robo::DiagnosticReadSession diagnosticRead;
robo::LightOutput lightOutput;
BLECharacteristic* bleCharacteristic;
BLE2902* bleNotifications;
esp_gatt_if_t bleGattsIf = ESP_GATT_IF_NONE;
robo::BleSession bleSession;
robo::BondedAccess bondAccess;
BLESecurity bondSecurity;
Preferences companionPrefs;
Preferences calibrationPrefs;
robo::SensorCalibration sensorCalibration;
bool calibrationStorage = false;
const char* calibrationStorageError = "";
Preferences autoLightPrefs;
bool autoLightStorage=false;
const char* autoLightStorageError="";
bool companionStorage=false;
uint32_t pairPin=0;
uint32_t pairConnections=0,pairRequests=0,pairNotifications=0;
int pairAuthMode=-1,pairFailure=-1;
bool pairStackSuccess=false;
const char* pairStage="idle";
int pairDisconnectReason=-1,pairEncryptionError=0;
uint32_t pairStarted=0;
uint8_t currentPeer[6]={};
uint8_t pairRepairPeer[6]={};
robo::Result pairRepairResult;
uint32_t pairRepairStarted=0;
robo::Result pairReconnectResult;
bool pairReconnecting=false, pairToolSeen=false;
uint32_t pairReconnectStarted=0, pairToolCount=0, pairToolAt=0;
const char* pairLastQuery="";
robo::BlePreparedWrite<MaxBleBytes> blePreparedWrite;
String deviceId;
bool sen54Detected = false;
char sen54Product[33] = {};

struct Sample {
  int soil = -1;
  int air = -1;
  int uv = -1;
  int ambient = -1;
  bool soilValid = false;
  bool airValid = false;
  bool uvValid = false;
  bool ambientValid = false;
  bool environmentValid = false;
  float temperature = NAN;
  float humidity = NAN;
  robo::Sen54Sample sen54;
  bool sen54Valid = false;
  int tankMm = -1;
  uint32_t tankEchoUs = 0;
  bool tankSignalHigh = false;
  bool tankSampled = false;
  uint8_t tankEdgeCount = 0;
  bool tankCaptureOverflow = false;
  bool tankTriggerLowOk = false;
  bool tankTriggerHighOk = false;
  uint32_t tankIrqEdges = 0;
  uint32_t timestamp = 0;
};
Sample sample;
struct PrintJob { char id[33]; char text[robo::MaxPrintBytes + 1]; bool isDaily; bool calibration; robo::DailyTicket daily; };
struct BleJob { robo::BleTicket ticket; char text[MaxBleBytes + 1]; };

class Lock {
 public:
  explicit Lock(SemaphoreHandle_t handle) : handle_(handle) {
    xSemaphoreTake(handle_, portMAX_DELAY);
  }
  ~Lock() { xSemaphoreGive(handle_); }
 private:
  SemaphoreHandle_t handle_;
};

bool tokenMatches(const std::string& supplied) {
  const std::string expected(ROBO_DEVICE_TOKEN);
  if (supplied.size() != expected.size()) return false;
  unsigned char difference = 0;
  for (size_t i = 0; i < expected.size(); ++i)
    difference |= static_cast<unsigned char>(supplied[i] ^ expected[i]);
  return difference == 0;
}

void writePump() {
  // Only the independent task and command path call this, under coreMutex.
  if (ROBO_ENABLE_PUMP) digitalWrite(pins::Pump, controller.pumpOn() ? HIGH : LOW);
}

void pumpTask(void*) {
  TickType_t wake = xTaskGetTickCount();
  for (;;) {
    {
      Lock guard(coreMutex);
      controller.tick(millis());
      writePump();
    }
    vTaskDelayUntil(&wake, pdMS_TO_TICKS(10));
  }
}

uint8_t crc8(const uint8_t* bytes) {
  uint8_t crc = 0xff;
  for (int i = 0; i < 2; ++i) {
    crc ^= bytes[i];
    for (int bit = 0; bit < 8; ++bit)
      crc = (crc & 0x80) ? static_cast<uint8_t>((crc << 1) ^ 0x31) : crc << 1;
  }
  return crc;
}

bool readSht31(float& temperature, float& humidity) {
  Wire.beginTransmission(ROBO_SHT31_ADDRESS);
  Wire.write(0x24);
  Wire.write(0x00);  // High repeatability single shot, clock stretching disabled.
  if (Wire.endTransmission() != 0) return false;
  vTaskDelay(pdMS_TO_TICKS(20));
  if (Wire.requestFrom(static_cast<uint8_t>(ROBO_SHT31_ADDRESS), static_cast<uint8_t>(6)) != 6)
    return false;
  uint8_t bytes[6];
  for (uint8_t& byte : bytes) byte = Wire.read();
  if (crc8(bytes) != bytes[2] || crc8(bytes + 3) != bytes[5]) return false;
  temperature = -45.0f + 175.0f * ((bytes[0] << 8) | bytes[1]) / 65535.0f;
  humidity = 100.0f * ((bytes[3] << 8) | bytes[4]) / 65535.0f;
  return std::isfinite(temperature) && std::isfinite(humidity) &&
         temperature >= -45 && temperature <= 130 && humidity >= 0 && humidity <= 100;
}

struct Dht20Bus {
  bool read(uint8_t* bytes, size_t count) {
    if (Wire.requestFrom(uint8_t(0x38), static_cast<uint8_t>(count)) != count)
      return false;
    for (size_t i = 0; i < count; ++i) bytes[i] = Wire.read();
    return true;
  }
  bool write(const uint8_t* bytes, size_t count) {
    Wire.beginTransmission(0x38);
    Wire.write(bytes, count);
    return Wire.endTransmission() == 0;
  }
  void wait(unsigned ms) { vTaskDelay(pdMS_TO_TICKS(ms)); }
};

int readAnalog(int pin) {
  uint32_t total = 0;
  for (int i = 0; i < 8; ++i) total += analogRead(pin);
  return total / 8;
}

struct Sen54Bus {
  bool command(uint16_t command, unsigned waitMs) {
    Wire.beginTransmission(0x69);
    Wire.write(uint8_t(command >> 8)); Wire.write(uint8_t(command));
    if (Wire.endTransmission() != 0) return false;
    vTaskDelay(pdMS_TO_TICKS(waitMs));
    return true;
  }
  bool read(uint8_t* bytes, size_t count) {
    if (Wire.requestFrom(uint8_t(0x69), uint8_t(count)) != count) return false;
    for (size_t i = 0; i < count; ++i) bytes[i] = Wire.read();
    return true;
  }
};

void probeKnownI2cSensors() {
  // Identification only: no fan, actuator or measurement start commands.
  for (uint8_t address : {uint8_t(0x38), uint8_t(0x44), uint8_t(0x69), uint8_t(0x6a)}) {
    Wire.beginTransmission(address);
    const bool present = Wire.endTransmission() == 0;
    Serial.printf("Sensor I2C 0x%02x: %s\n", address, present ? "ACK" : "no response");
    if (address != 0x69 || !present) continue;
    sen54Detected = true;
    Sen54Bus bus; uint8_t data[48]; char name[33] = {};
    bool valid = bus.command(0xd014, 20) && bus.read(data, sizeof(data));
    for (unsigned i = 0; valid && i < 16; ++i) {
      valid = robo::sen54Crc(data + i * 3) == data[i * 3 + 2];
      for (unsigned j = 0; j < 2; ++j) {
        const char c = char(data[i * 3 + j]);
        name[i * 2 + j] = c >= 32 && c <= 126 ? c : '\0';
      }
    }
    Serial.printf("Sensor 0x69 product: %s\n", valid ? name : "unavailable / CRC error");
    if (valid) memcpy(sen54Product, name, sizeof(name));
  }
}

portMUX_TYPE tankCaptureMux = portMUX_INITIALIZER_UNLOCKED;
volatile bool tankCaptureArmed = false;
volatile bool tankCaptureOverflow = false;
volatile uint32_t tankCaptureStarted = 0;
volatile uint8_t tankCaptureCount = 0;
volatile uint32_t tankIrqEdges = 0;
volatile robo::UltrasonicEdge tankEdges[robo::UltrasonicMaxEdges];

void ARDUINO_ISR_ATTR onTankEdge() {
  const uint32_t now = micros();
  const bool high = digitalRead(pins::Ultrasonic) == HIGH;
  portENTER_CRITICAL_ISR(&tankCaptureMux);
  ++tankIrqEdges;
  if (tankCaptureArmed) {
    const uint32_t elapsed = now - tankCaptureStarted;
    if (elapsed <= robo::UltrasonicTimeoutUs) {
      if (tankCaptureCount < robo::UltrasonicMaxEdges) {
        tankEdges[tankCaptureCount].elapsedUs = elapsed;
        tankEdges[tankCaptureCount].high = high;
        ++tankCaptureCount;
      } else tankCaptureOverflow = true;
    }
  }
  portEXIT_CRITICAL_ISR(&tankCaptureMux);
}

int readTankDistance(uint32_t& echoUs, bool& signalHigh, uint8_t& edgeCount, bool& overflow,
                     bool& lowOk, bool& highOk, uint32_t& irqEdges) {
  // Grove Ranger v2.0 uses a single bidirectional SIG, powered at 3.3V.
  portENTER_CRITICAL(&tankCaptureMux);
  tankIrqEdges = 0;
  portEXIT_CRITICAL(&tankCaptureMux);
  // Keep input readback while driving the existing trigger, so diagnostics
  // can separate a clamped/output-faulted line from a missing sensor response.
  pinMode(pins::Ultrasonic, INPUT | OUTPUT);
  digitalWrite(pins::Ultrasonic, LOW); delayMicroseconds(2);
  lowOk = digitalRead(pins::Ultrasonic) == LOW;
  digitalWrite(pins::Ultrasonic, HIGH); delayMicroseconds(12);
  highOk = digitalRead(pins::Ultrasonic) == HIGH;
  digitalWrite(pins::Ultrasonic, LOW);
  portENTER_CRITICAL(&tankCaptureMux);
  tankCaptureCount = 0;
  tankCaptureOverflow = false;
  tankCaptureStarted = micros();
  tankCaptureArmed = true;
  const uint32_t started = tankCaptureStarted;
  portEXIT_CRITICAL(&tankCaptureMux);
  // pinMode preserves the CHANGE interrupt; release output only after arming.
  // Trigger edges arrive while disarmed; an initial queued LOW is ignored.
  pinMode(pins::Ultrasonic, INPUT);
  robo::UltrasonicPulse pulse;
  for (;;) {
    robo::UltrasonicEdge edges[robo::UltrasonicMaxEdges];
    portENTER_CRITICAL(&tankCaptureMux);
    edgeCount = tankCaptureCount;
    overflow = tankCaptureOverflow;
    for (uint8_t i=0; i<edgeCount; ++i) {
      edges[i].elapsedUs = tankEdges[i].elapsedUs;
      edges[i].high = tankEdges[i].high;
    }
    portEXIT_CRITICAL(&tankCaptureMux);
    pulse = robo::decodeUltrasonicEdges(edges,edgeCount,overflow);
    if (pulse.complete || overflow || uint32_t(micros()-started) >= robo::UltrasonicTimeoutUs) break;
    vTaskDelay(1);
  }
  portENTER_CRITICAL(&tankCaptureMux);
  tankCaptureArmed = false;
  irqEdges = tankIrqEdges;
  portEXIT_CRITICAL(&tankCaptureMux);
  echoUs = pulse.complete ? pulse.widthUs : 0;
  signalHigh = digitalRead(pins::Ultrasonic) == HIGH;
  return lowOk && highOk ? robo::ultrasonicDistanceMm(echoUs) : -1;
}

void sensorTask(void*) {
  Sen54Bus senBus;
  bool senStarted = false;
  uint32_t senStartAttempt = 0;
  if (ROBO_ENABLE_SEN54) vTaskDelay(pdMS_TO_TICKS(100));
  if (ROBO_ENABLE_DHT20) vTaskDelay(pdMS_TO_TICKS(100));
  TickType_t wake = xTaskGetTickCount();
  for (;;) {
    Sample next;
    if (ROBO_ENABLE_SOIL) {
      next.soil = readAnalog(pins::Soil);
      next.soilValid = next.soil >= 0 && next.soil <= 4095;
    }
    if (ROBO_ENABLE_AIR) {
      next.air = readAnalog(pins::Air);
      next.airValid = next.air >= 0 && next.air <= 4095;
    }
    if (ROBO_ENABLE_UV) {
      next.uv = readAnalog(pins::Uv);
      next.uvValid = next.uv >= 0 && next.uv <= 4095;
    }
    if (ROBO_ENABLE_AMBIENT_LIGHT) {
      next.ambient = readAnalog(pins::AmbientLight);
      next.ambientValid = next.ambient >= 0 && next.ambient <= 4095;
    }
    if (ROBO_ENABLE_SHT31)
      next.environmentValid = readSht31(next.temperature, next.humidity);
    if (ROBO_ENABLE_DHT20) {
      Dht20Bus bus;
      next.environmentValid = robo::readDht20(bus, next.temperature, next.humidity) ==
                              robo::Dht20Result::Ok;
    }
    if (ROBO_ENABLE_SEN54) {
      if (!senStarted) {
        senStartAttempt = millis();
        senStarted = senBus.command(0x0021, 50);
      } else {
        const auto result = robo::readSen54(senBus, next.sen54);
        next.sen54Valid = result == robo::Sen54Result::Ok;
        if (result == robo::Sen54Result::Transport || result == robo::Sen54Result::Crc ||
            (result == robo::Sen54Result::NotReady && millis() - senStartAttempt > 10000))
          senStarted = false;
        if (next.sen54Valid) {
          senStartAttempt = millis();
          next.temperature = next.sen54.temperature;
          next.humidity = next.sen54.humidity;
          next.environmentValid = std::isfinite(next.temperature) && std::isfinite(next.humidity);
        }
      }
    }
    if (ROBO_ENABLE_ULTRASONIC) {
      next.tankMm = readTankDistance(next.tankEchoUs, next.tankSignalHigh, next.tankEdgeCount,
        next.tankCaptureOverflow, next.tankTriggerLowOk, next.tankTriggerHighOk, next.tankIrqEdges);
      next.tankSampled = true;
      Lock guard(coreMutex);
      controller.updateTank(next.tankMm, millis());
      writePump();
    }
    next.timestamp = millis();
    { Lock guard(coreMutex); controller.updateAmbient(next.ambient, next.ambientValid, next.timestamp); }
    {
      Lock guard(sensorMutex);
      sample = next;
    }
    vTaskDelayUntil(&wake, pdMS_TO_TICKS(ROBO_ENABLE_DHT20 ? 2000 : 1000));
  }
}

Sample copySample() {
  Lock guard(sensorMutex);
  Sample current = sample;
  if (ROBO_ENABLE_REMOTE_SOIL) {
    current.soil = remoteSoil.raw();
    current.soilValid = remoteSoil.valid(millis());
  }
  if (static_cast<uint32_t>(millis() - current.timestamp) > 3000) {
    current.soilValid = current.airValid = current.uvValid = false;
    current.ambientValid = false;
    current.environmentValid = false;
    current.sen54Valid = false;
    current.tankMm = -1;
  }
  return current;
}

robo::LightStatus connectionLightStatus() {
  bool indicatorOnline;
  {
    Lock guard(sensorMutex);
    // Connectivity tolerates short upload delays; sensor validity remains 3s.
    // Read the clock under the same lock: a just-arrived sample must not look
    // stale because its receive timestamp is later than a caller's timestamp.
    indicatorOnline = ROBO_ENABLE_REMOTE_SOIL && remoteSoil.raw() >= 0 && remoteSoil.age(millis()) <= 10000;
  }
  const bool networkOnline = ROBO_WIFI_STA ? WiFi.status() == WL_CONNECTED : WiFi.softAPgetStationNum() > 0;
  return robo::connectionLightStatus(ROBO_ENABLE_LIGHT && ROBO_ENABLE_STATUS_LIGHT && ActionsReady, networkOnline, indicatorOnline);
}

void applyLight(bool force = false) {
  if (!ROBO_ENABLE_LIGHT) return;
  Lock outputGuard(lightMutex);
  bool on;
  robo::LightEffect effect = robo::LightEffect::Solid;
  {
    Lock coreGuard(coreMutex);
    on = controller.lightOn();
    robo::parseLightEffect(controller.lightEffect(), effect);
  }
  const uint32_t now = millis();
  const bool changed = lightOutput.configure(on, effect, connectionLightStatus(), now);
  if (!force && !changed && !lightOutput.animated()) return;
  // Pixel transmission is outside coreMutex, so it cannot hold the pump deadline
  // behind a strip update. lightMutex also serializes immediate OFF with frames.
  for (size_t i = 0; i < ROBO_LED_COUNT; ++i) {
    const robo::LightRgb color = lightOutput.pixel(now, i, ROBO_LED_COUNT);
    pixels.setPixelColor(i, color.red, color.green, color.blue);
  }
  pixels.show();
}

void lightTask(void*) {
  TickType_t wake = xTaskGetTickCount();
  for (;;) {
    applyLight();
    vTaskDelayUntil(&wake, pdMS_TO_TICKS(40));
  }
}

void printerTask(void*) {
  PrintJob job;
  for (;;) {
    if (xQueueReceive(printQueue, &job, portMAX_DELAY) != pdTRUE) continue;
#if ROBO_PRINTER_BLE
    bool success = ROBO_ENABLE_PRINTER && printer_ble::startJob();
    if (success) success = job.calibration ? robo::writePrinterCalibration(printer_ble::writeByte, ROBO_PRINTER_CUTTER_CONFIRMED) :
      job.isDaily ? robo::writeDailyReceipt(job.daily, printer_ble::writeByte, ROBO_PRINTER_CUTTER_CONFIRMED) :
      robo::writeReceipt(job.text, printer_ble::writeByte, ROBO_PRINTER_CUTTER_CONFIRMED);
    if (success) success = printer_ble::finishJob();
    if (!success) printer_ble::abortJob();
    const auto transport = printer_ble::snapshot();
    Serial.printf("Printer BLE job=%s ok=%d bytes=%lu elapsed_ms=%lu error=%s\n", job.id, success,
      static_cast<unsigned long>(transport.bytes), static_cast<unsigned long>(transport.elapsedMs), transport.error);
    {
      Lock guard(coreMutex);
      controller.finishPrint(job.id, success, transport.bytes > 0,
        *transport.error ? transport.error : "printer_ble_write_failed");
    }
#else
    const uint32_t started = millis();
    const uint32_t budget = robo::printerTransmitBudgetMs(
        job.calibration ? robo::CalibrationWireBytes : job.isDaily ? robo::DailyReceiptBytes+6 : robo::plannedReceiptBytes(job.text, ROBO_PRINTER_CUTTER_CONFIRMED), ROBO_PRINTER_BAUD);
    // Transmission is bounded and occurs in this low priority task. It never
    // holds the controller mutex or delays the independent pump deadline task.
    const auto writeByte = [&](uint8_t byte) {
      // Arduino Print::write always reports one byte even on driver errors.
      // The UART is configured without a TX ring buffer; use nonblocking FIFO
      // writes so every attempt remains under this job's deadline.
      while (millis() - started < budget) {
        const int written = uart_tx_chars(UART_NUM_1, reinterpret_cast<const char*>(&byte), 1);
        if (written == 1) return true;
        if (written < 0) return false;
        vTaskDelay(pdMS_TO_TICKS(1));
      }
      return false;
    };
    bool success = ROBO_ENABLE_PRINTER && budget &&
                   (job.calibration ? robo::writePrinterCalibration(writeByte, ROBO_PRINTER_CUTTER_CONFIRMED) : job.isDaily ? robo::writeDailyReceipt(job.daily, writeByte, ROBO_PRINTER_CUTTER_CONFIRMED) :
                    robo::writeReceipt(job.text, writeByte, ROBO_PRINTER_CUTTER_CONFIRMED));
    if (success) {
      const uint32_t elapsed = millis() - started;
      success = elapsed < budget &&
                uart_wait_tx_done(UART_NUM_1, pdMS_TO_TICKS(budget-elapsed)) == ESP_OK;
    }
    {
      Lock guard(coreMutex);
      controller.finishPrint(job.id, success);
    }
#endif
  }
}

robo::Result processCommand(const robo::Command& command) {
  robo::Result result;
  {
    Lock guard(coreMutex);
    const bool oldAutoPrint=controller.autoPrint();
    result = controller.submit(command, millis());
    writePump();
    if(result.ok && !result.duplicate && command.action=="auto_print") {
      if(!companionStorage || companionPrefs.putBool("auto-print",command.on)!=1) {
        controller.failPreference(command.requestId,oldAutoPrint);
        controller.lookup(command.requestId,result);
      }
    }
  }
  if (result.ok && !result.duplicate && command.action == "light") applyLight(true);
  if (result.ok && !result.duplicate && (command.action == "print" || command.action == "print_scene" || command.action == "print_daily" || command.action == "print_calibration")) {
    PrintJob job{};
    memcpy(job.id, command.requestId.data(), command.requestId.size());
    memcpy(job.text, command.text.data(), command.text.size());
    job.calibration=command.action=="print_calibration";job.isDaily=command.action=="print_daily"; job.daily=command.daily;
    if(command.action=="print_scene") {
      job.isDaily=true;job.daily.scene=robo::sceneNumber(command.effect);
      memcpy(job.daily.note,command.text.data(),command.text.size());
      robo::drawDailyCard(job.daily,[]{return esp_random();});
      const auto state=copySample();
      if(state.soilValid) {
        job.daily.raw=state.soil;
        Lock guard(coreMutex);
        if(sensorCalibration.soilValid())job.daily.soil=lround(robo::soilPercent(state.soil,sensorCalibration.dry,sensorCalibration.wet));
      }
      if(state.environmentValid){job.daily.temperature=lround(state.temperature*10);job.daily.humidity=lround(state.humidity);}
    }
    if (xQueueSend(printQueue, &job, 0) != pdTRUE) {
      Lock guard(coreMutex);
      controller.finishPrint(command.requestId, false);
      controller.lookup(command.requestId, result);
    }
  }
  return result;
}

void resultJson(JsonDocument& document, const robo::Result& result) {
  document["ok"] = result.ok;
  document["request_id"] = result.requestId;
  document["status"] = result.status;
  document["error"] = result.error;
}

void stateJson(JsonDocument& document) {
  const Sample current = copySample();
  robo::SensorCalibration saved;
  bool writable;
  const char* storageError;
  { Lock guard(coreMutex); saved = sensorCalibration; writable = calibrationStorage; storageError = calibrationStorageError; }
  const uint32_t now = millis();
  document["schema_version"] = 1;
  document["device_id"] = deviceId;
  document["uptime_ms"] = now;
  document["sample_age_ms"] = static_cast<uint32_t>(now - current.timestamp);
  JsonObject soil = document.createNestedObject("soil");
  if (current.soil >= 0) soil["raw"] = current.soil; else soil["raw"] = nullptr;
  const bool calibrated = saved.soilValid();
  soil["valid"] = current.soilValid;
  soil["calibrated"] = calibrated;
  if(ROBO_ENABLE_REMOTE_SOIL) {
    soil["source"]="indicator_rp2040_grove_adc";
    Lock guard(sensorMutex);
    if(remoteSoil.raw()>=0)soil["sample_age_ms"]=remoteSoil.age(now);
    else soil["sample_age_ms"]=nullptr;
  }
  if (current.soilValid && calibrated)
    soil["percent"] = robo::soilPercent(current.soil, saved.dry, saved.wet);
  else soil["percent"] = nullptr;
  JsonObject air = document.createNestedObject("air");
  if (current.air >= 0) air["raw"] = current.air; else air["raw"] = nullptr;
  air["valid"] = current.airValid;
  JsonObject sen = document.createNestedObject("sen54");
  sen["enabled"] = bool(ROBO_ENABLE_SEN54);
  sen["detected"] = sen54Detected;
  sen["product"] = sen54Product;
  sen["valid"] = current.sen54Valid;
  const char* keys[] = {"pm1_ug_m3", "pm25_ug_m3", "pm4_ug_m3", "pm10_ug_m3", "voc_index"};
  const float values[] = {current.sen54.pm1, current.sen54.pm25, current.sen54.pm4, current.sen54.pm10, current.sen54.voc};
  for (unsigned i = 0; i < 5; ++i) {
    if (current.sen54Valid && std::isfinite(values[i])) sen[keys[i]] = values[i];
    else sen[keys[i]] = nullptr;
  }
  JsonObject settings = document.createNestedObject("calibration");
  settings["schema"] = 1; settings["revision"] = saved.revision;
  settings["writable"] = writable; settings["error"] = storageError;
  settings["dry"] = saved.dry; settings["wet"] = saved.wet;
  settings["full_mm"] = saved.tank.fullMm; settings["empty_mm"] = saved.tank.emptyMm; settings["stop_mm"] = saved.tank.stopMm;
  const auto calibration = saved.tank;
  JsonObject tank = document.createNestedObject("water_tank");
  tank["enabled"] = bool(ROBO_ENABLE_ULTRASONIC);
  tank["signal_gpio"] = pins::Ultrasonic;
  tank["capture"] = "gpio_edges";
  tank["edge_count"] = current.tankEdgeCount;
  tank["capture_overflow"] = current.tankCaptureOverflow;
  tank["trigger_low_ok"] = current.tankTriggerLowOk;
  tank["trigger_high_ok"] = current.tankTriggerHighOk;
  tank["irq_edges"] = current.tankIrqEdges;
  tank["valid"] = current.tankMm >= 20;
  tank["calibrated"] = calibration.valid();
  tank["error"] = robo::ultrasonicSampleError(ROBO_ENABLE_ULTRASONIC, current.tankSampled,
    static_cast<uint32_t>(now-current.timestamp), current.tankEchoUs, current.tankSignalHigh);
  if (ROBO_ENABLE_ULTRASONIC && current.tankSampled && uint32_t(now-current.timestamp)<=3000 &&
      (!current.tankTriggerLowOk || !current.tankTriggerHighOk)) tank["error"]="trigger_level_mismatch";
  if (current.tankSampled) {
    tank["echo_us"] = current.tankEchoUs;
    tank["signal_high"] = current.tankSignalHigh;
    tank["sample_age_ms"] = static_cast<uint32_t>(now-current.timestamp);
  } else {
    tank["echo_us"] = nullptr;
    tank["signal_high"] = nullptr;
    tank["sample_age_ms"] = nullptr;
  }
  if (current.tankMm >= 20) tank["distance_mm"] = current.tankMm;
  else tank["distance_mm"] = nullptr;
  const float level = robo::tankLevelPercent(current.tankMm, calibration);
  if (level >= 0) tank["level_pct"] = level; else tank["level_pct"] = nullptr;
  JsonObject uv = document.createNestedObject("uv");
  if (current.uv >= 0) uv["raw"] = current.uv; else uv["raw"] = nullptr;
  uv["valid"] = current.uvValid;
  JsonObject ambient = document.createNestedObject("ambient_light");
  ambient["enabled"] = bool(ROBO_ENABLE_AMBIENT_LIGHT);
  if (current.ambient >= 0) ambient["raw"] = current.ambient; else ambient["raw"] = nullptr;
  ambient["valid"] = current.ambientValid;
  JsonObject environment = document.createNestedObject("environment");
  environment["valid"] = current.environmentValid;
  environment["source"] = ROBO_ENABLE_SEN54 ? "sen54" : ROBO_ENABLE_DHT20 ? "dht20" : "sht31";
  if (current.environmentValid) {
    environment["temperature_c"] = current.temperature;
    environment["humidity_pct"] = current.humidity;
  } else {
    environment["temperature_c"] = nullptr;
    environment["humidity_pct"] = nullptr;
  }
  {
    Lock guard(bleMutex);
    auto yoyo=document.createNestedObject("yoyo");
    yoyo["enabled"]=bool(ROBO_ENABLE_BONDED_YOYO && companionStorage);
    yoyo["repair_supported"]=true;
    yoyo["reconnect_supported"]=true;
    yoyo["reconnecting"]=pairReconnecting;
    yoyo["notifications"]=bleSession.notificationsEnabled();
    yoyo["tool_seen"]=pairToolSeen;
    yoyo["tool_count"]=pairToolCount;
    yoyo["last_query"]=pairLastQuery;
    if(pairToolSeen)yoyo["last_tool_age_ms"]=uint32_t(now-pairToolAt);
    yoyo["repairing"]=bondAccess.repairing();
    yoyo["connect_count"]=pairConnections;
    yoyo["security_requests"]=pairRequests;
    yoyo["pin_notifications"]=pairNotifications;
    yoyo["auth_mode"]=pairAuthMode;
    yoyo["failure_reason"]=pairFailure;
    yoyo["stack_success"]=pairStackSuccess;
    yoyo["stage"]=pairStage;
    yoyo["link_connected"]=bondAccess.connected();
    yoyo["window_remaining_ms"]=bondAccess.remaining(now);
    yoyo["disconnect_reason"]=pairDisconnectReason;
    yoyo["encryption_error"]=pairEncryptionError;
    yoyo["paired"]=bondAccess.paired();
    yoyo["connected"]=bondAccess.authorized();
    yoyo["pairing"]=bondAccess.enrolling(now);
    if(bondAccess.enrolling(now))yoyo["pin"]=pairPin;
  }
  const auto ledStatus = connectionLightStatus();
  Lock guard(coreMutex);
  document["auto_print"]=controller.autoPrint();
  JsonObject pump = document.createNestedObject("pump");
  JsonObject focus = document.createNestedObject("focus");
  focus["enabled"] = ActionsReady;
  focus["phase"] = static_cast<int>(controller.focus().phase());
  focus["revision"] = controller.focus().revision();
  focus["duration_ms"] = controller.focus().duration();
  focus["remaining_ms"] = controller.focus().remaining(now);
  pump["enabled"] = ROBO_ENABLE_PUMP && ActionsReady;
  pump["on"] = controller.pumpOn();
  pump["remaining_ms"] = controller.remainingMs(millis());
  pump["water_block_reason"] = controller.waterBlockReason(millis());
  pump["water_allowed"] = bool(ROBO_ENABLE_PUMP && ActionsReady && !*controller.waterBlockReason(millis()));
  JsonObject light = document.createNestedObject("light");
  light["enabled"] = ROBO_ENABLE_LIGHT && ActionsReady;
  light["on"] = controller.lightOn();
  light["effect"] = controller.lightEffect();
  robo::LightEffect ledEffect = robo::LightEffect::Solid;
  robo::parseLightEffect(controller.lightEffect(),ledEffect);
  light["display_mode"] = robo::lightDisplayMode(controller.lightOn(),ledEffect,ledStatus);
  light["pixel_count"] = ROBO_LED_COUNT;
  light["brightness_limit"] = ROBO_LED_BRIGHTNESS;
  light["status_enabled"] = bool(ROBO_ENABLE_LIGHT && ROBO_ENABLE_STATUS_LIGHT && ActionsReady);
  JsonObject automatic = document.createNestedObject("auto_light");
  const auto &autoSettings=controller.autoLight().settings();
  automatic["schema"]=1;
  automatic["available"]=bool(ROBO_ENABLE_LIGHT && ROBO_ENABLE_AMBIENT_LIGHT && ActionsReady);
  automatic["writable"]=autoLightStorage;
  automatic["error"]=autoLightStorageError;
  automatic["revision"]=autoSettings.revision;
  automatic["enabled"]=autoSettings.enabled;
  automatic["on_below"]=autoSettings.onBelow;
  automatic["off_above"]=autoSettings.offAbove;
  automatic["paused"]=controller.autoLight().paused();
  automatic["sensor_stale"]=controller.autoLight().stale(now);
  JsonObject printer = document.createNestedObject("printer");
  printer["enabled"] = ROBO_ENABLE_PRINTER && ActionsReady;
  printer["status"] = std::string(controller.printerStatus());
  printer["text_format"] = "utf8-raster";
  printer["layout"] = robo::PrinterLayoutVersion;
  printer["daily_layout"] = robo::DailyLayoutVersion;
  printer["paper_width_dots"] = 384;
  printer["autocut"] = static_cast<bool>(ROBO_PRINTER_CUTTER_CONFIRMED);
#if ROBO_PRINTER_BLE
  const auto printerLink = printer_ble::snapshot();
  printer["transport"] = "ble";
  printer["link_connected"] = printerLink.connected;
  printer["link_ready"] = printerLink.ready;
  printer["link_phase"] = printerLink.phase;
  printer["link_error"] = printerLink.error;
  printer["mtu"] = printerLink.mtu;
  printer["bytes_sent"] = printerLink.bytes;
  printer["send_elapsed_ms"] = printerLink.elapsedMs;
#else
  printer["transport"] = "uart";
#endif
  // The sample documents transport/cutter commands, not a status response.
  // Do not report paper, blade or physical completion from a UART write.
  printer["feedback"] = "unavailable";
  JsonObject last = document.createNestedObject("last_command");
  const robo::Result& result = controller.last();
  last["request_id"] = result.requestId;
  last["status"] = result.status;
  last["error"] = result.error;
}

void sendJson(int code, JsonDocument& document) {
  String body;
  serializeJson(document, body);
  http.sendHeader("Cache-Control", "no-store");
  http.send(code, "application/json", body);
}

void sendError(int status, const char* error, const char* requestId = "") {
  StaticJsonDocument<256> document;
  robo::Result result;
  result.requestId = requestId;
  result.error = error;
  resultJson(document, result);
  sendJson(status, document);
}

bool httpAuthorized() {
  if (!tokenMatches(http.header("X-Device-Token").c_str())) {
    sendError(401, "unauthorized");
    return false;
  }
  return true;
}

bool jsonString(JsonVariantConst value, std::string& destination) {
  if (!value.is<const char*>()) return false;
  JsonString text = value.as<JsonString>();
  destination.assign(text.c_str(), text.size());
  return destination.find('\0') == std::string::npos;
}

void loadSensorCalibration() {
  calibrationStorage = calibrationPrefs.begin("rp-calibration", false);
  if (!calibrationStorage) calibrationStorageError = "storage_unavailable";
  else if (calibrationPrefs.isKey("values")) {
    robo::CalibrationRecord record;
    if (calibrationPrefs.getBytesLength("values") != sizeof(record) ||
        calibrationPrefs.getBytes("values", &record, sizeof(record)) != sizeof(record) ||
        !robo::decodeCalibration(record, sensorCalibration)) calibrationStorageError = "calibration_corrupt";
  } else {
    // Migrate valid build-time endpoints only on the first boot. A saved reset
    // is a real all-unset record and must not resurrect build-time values.
    sensorCalibration.dry = ROBO_SOIL_DRY_RAW; sensorCalibration.wet = ROBO_SOIL_WET_RAW;
    sensorCalibration.tank = controlConfig().tankCalibration;
    if (!sensorCalibration.soilValid()) sensorCalibration.dry = sensorCalibration.wet = -1;
    if (!sensorCalibration.tankValid()) sensorCalibration.tank = robo::TankCalibration();
  }
  controller.finishCalibration(sensorCalibration.tank);
}

void httpCalibration() {
  if (!httpAuthorized()) return;
  if (http.header("Content-Type").indexOf("application/json") != 0) { sendError(415, "content_type_required"); return; }
  const String body = http.arg("plain");
  if (!body.length() || body.length() > MaxHttpBytes) { sendError(413, "body_size_invalid"); return; }
  StaticJsonDocument<512> input;
  robo::CalibrationEdit edit;
  if (deserializeJson(input, body) || !robo::parseCalibrationEdit(input.as<JsonVariantConst>(), edit)) {
    sendError(400, "invalid_calibration_payload"); return;
  }
  robo::SensorCalibration next;
  const char* error = "";
  {
    Lock guard(coreMutex);
    if (!calibrationStorage) error = "storage_unavailable";
    else error = robo::applyCalibration(sensorCalibration, edit, next);
    if (!*error && !controller.beginCalibration()) error = "pump_busy";
  }
  if (*error) { sendError(409, error); return; }
  // Flash writes run outside the control lock. Water requests are blocked
  // during this transaction; the independent deadline task stays responsive.
  const bool saved = robo::saveCalibration(calibrationPrefs, next);
  {
    Lock guard(coreMutex);
    if (saved) { sensorCalibration = next; calibrationStorageError = ""; }
    else {
      // An unverifiable NVS write must not leave water protection using values
      // that disagree with the next boot. Fail closed until storage recovers.
      sensorCalibration = robo::SensorCalibration();
      calibrationStorage = false; calibrationStorageError = "calibration_save_failed";
    }
    controller.finishCalibration(sensorCalibration.tank);
  }
  if (!saved) { sendError(503, "calibration_save_failed"); return; }
  StaticJsonDocument<128> output;
  output["ok"] = true; output["revision"] = next.revision;
  sendJson(200, output);
}

void loadAutoLight() {
  autoLightStorage=autoLightPrefs.begin("rp-light",false);
  robo::AutoLightSettings settings;
  if(!autoLightStorage)autoLightStorageError="storage_unavailable";
  else if(autoLightPrefs.isKey("values")) {
    robo::AutoLightRecord record;
    if(autoLightPrefs.getBytesLength("values")!=sizeof(record) || autoLightPrefs.getBytes("values",&record,sizeof(record))!=sizeof(record) ||
       !robo::decodeAutoLight(record,settings))autoLightStorageError="auto_light_corrupt";
  }
  controller.finishLightSettings(settings);
}
void httpAutoLight() {
  if(!httpAuthorized())return;
  if(!(ROBO_ENABLE_LIGHT && ROBO_ENABLE_AMBIENT_LIGHT && ActionsReady)) { sendError(409,"auto_light_unavailable"); return; }
  if(http.header("Content-Type").indexOf("application/json")!=0) { sendError(415,"content_type_required"); return; }
  const String body=http.arg("plain");
  if(!body.length() || body.length()>MaxHttpBytes) { sendError(413,"body_size_invalid"); return; }
  StaticJsonDocument<384> input; robo::AutoLightSettings settings;
  if(deserializeJson(input,body) || !robo::parseAutoLight(input.as<JsonVariantConst>(),settings)) { sendError(400,"invalid_auto_light"); return; }
  const char* error="";
  {
    Lock guard(coreMutex);
    if(!autoLightStorage)error="storage_unavailable";
    else if(settings.revision!=controller.autoLight().settings().revision)error="settings_conflict";
    else if(settings.revision==UINT32_MAX)error="revision_exhausted";
    else if(!controller.beginLightSettings())error="settings_busy";
  }
  if(*error) { sendError(409,error); return; }
  ++settings.revision;
  const bool saved=robo::saveAutoLight(autoLightPrefs,settings);
  {
    Lock guard(coreMutex);
    if(saved) { controller.finishLightSettings(settings); autoLightStorageError=""; }
    else { autoLightStorage=false;autoLightStorageError="auto_light_save_failed";controller.finishLightSettings(robo::AutoLightSettings(),true); }
  }
  if(!saved) { sendError(503,"auto_light_save_failed"); return; }
  StaticJsonDocument<128> output; output["ok"]=true;output["revision"]=settings.revision;sendJson(200,output);
}

void httpSoil() {
  if (!httpAuthorized()) return;
  if (!ROBO_ENABLE_REMOTE_SOIL) { sendError(409, "remote_soil_disabled"); return; }
  if (http.header("Content-Type").indexOf("application/json") != 0) {
    sendError(415, "content_type_required"); return;
  }
  const String body = http.arg("plain");
  if (!body.length() || body.length() > MaxHttpBytes) {sendError(413,"body_size_invalid");return;}
  StaticJsonDocument<512> input;
  if (deserializeJson(input, body) || !input.is<JsonObject>() || input.size()!=5 ||
      !input["source_boot"].is<const char*>() ||
      input["seq"].is<bool>() || !input["seq"].is<uint32_t>() ||
      input["raw"].is<bool>() || !input["raw"].is<int>() ||
      input["age_ms"].is<bool>() || !input["age_ms"].is<uint32_t>() ||
      !input["v"].is<int>() || input["v"].as<int>()!=1) {
    sendError(400,"invalid_soil_sample");return;
  }
  bool accepted;
  {Lock guard(sensorMutex); accepted=remoteSoil.accept(input["source_boot"],input["seq"],input["raw"],input["age_ms"],millis());}
  StaticJsonDocument<128> output; output["accepted"]=accepted;
  sendJson(accepted?200:409,output);
}

void httpDiagnosticSession() {
  if(!httpAuthorized())return;
  if(!ROBO_ENABLE_DIAGNOSTIC_READ){sendError(409,"diagnostic_read_disabled");return;}
  if(http.header("Content-Type").indexOf("application/json")!=0){sendError(415,"content_type_required");return;}
  const String body=http.arg("plain");
  if(!body.length() || body.length()>MaxHttpBytes){sendError(413,"body_size_invalid");return;}
  StaticJsonDocument<256> input;
  if(deserializeJson(input,body) || !input.is<JsonObject>()){sendError(400,"invalid_json");return;}
  if(input.size()==1 && input["disable"].is<bool>() && input["disable"].as<bool>()) {
    {Lock guard(bleMutex);diagnosticRead.clear();}
    StaticJsonDocument<128> out;out["disabled"]=true;sendJson(200,out);return;
  }
  if(input.size()!=2 || !input["token"].is<const char*>() || input["ttl_ms"].is<bool>() || !input["ttl_ms"].is<uint32_t>()) {
    sendError(400,"invalid_diagnostic_session");return;
  }
  std::string readToken;
  if(!jsonString(input["token"],readToken)){sendError(400,"invalid_diagnostic_session");return;}
  bool ok;
  {Lock guard(bleMutex);ok=diagnosticRead.start(readToken.c_str(),input["ttl_ms"],millis());}
  StaticJsonDocument<128> out;out["created"]=ok;out["scope"]="one_soil_read";
  sendJson(ok?200:400,out);
}

// Arduino setStaticPIN() silently changes authentication to SC_ONLY.
// Restore MITM + persistent bonding afterwards for both enrollment paths.
void preparePairPin() {
  pairPin=100000+esp_random()%900000;
  bondSecurity.setStaticPIN(pairPin);
  bondSecurity.setCapability(ESP_IO_CAP_OUT);
  bondSecurity.setAuthenticationMode(ESP_LE_AUTH_REQ_SC_MITM_BOND);
}

// Called under bleMutex after the stack confirms deletion (or no key exists).
void finishPairRepair(bool removed) {
  if(!bondAccess.repairing())return;
  const bool stored=removed && (!companionPrefs.isKey("phone") || companionPrefs.remove("phone"));
  if(bondAccess.finishRepair(stored,millis())) {
    preparePairPin();
    pairStage="ready";pairAuthMode=pairFailure=-1;pairStackSuccess=false;
    pairRepairResult.ok=true;pairRepairResult.status="completed";pairRepairResult.error="";
  } else {
    pairStage="repair_failed";
    pairRepairResult.ok=false;pairRepairResult.status="failed";
    pairRepairResult.error=removed?"pair_storage_failed":"pair_key_remove_failed";
  }
}

void pairGapEvent(esp_gap_ble_cb_event_t event,esp_ble_gap_cb_param_t* param) {
  if(event!=ESP_GAP_BLE_REMOVE_BOND_DEV_COMPLETE_EVT)return;
  Lock guard(bleMutex);
  if(bondAccess.repairing() && !memcmp(pairRepairPeer,param->remove_bond_dev_cmpl.bd_addr,6))
    finishPairRepair(param->remove_bond_dev_cmpl.status==ESP_BT_STATUS_SUCCESS);
}

void httpCommand() {
  if (!httpAuthorized()) return;
  if (http.header("Content-Type").indexOf("application/json") != 0) {
    sendError(415, "content_type_required"); return;
  }
  const String body = http.arg("plain");
  if (body.length() == 0 || body.length() > MaxHttpBytes) {
    sendError(413, "body_size_invalid"); return;
  }
  StaticJsonDocument<1024> input;
  if (deserializeJson(input, body) || !input.is<JsonObject>()) {
    sendError(400, "invalid_json"); return;
  }
  JsonObjectConst object = input.as<JsonObjectConst>();
  for (JsonPairConst pair : object) {
    const char* key = pair.key().c_str();
    if (strcmp(key, "request_id") && strcmp(key, "action") &&
        strcmp(key, "duration_ms") && strcmp(key, "on") && strcmp(key, "text") &&
        strcmp(key, "effect") && strcmp(key, "daily")) {
      sendError(400, "unexpected_fields"); return;
    }
  }
  robo::Command command;
  if (!jsonString(object["request_id"], command.requestId) ||
      !jsonString(object["action"], command.action)) {
    sendError(400, "invalid_command_fields"); return;
  }
  if (!robo::validId(command.requestId)) {
    sendError(400, "invalid_request_id"); return;
  }
  command.hasDuration = object.containsKey("duration_ms");
  command.hasOn = object.containsKey("on");
  command.hasText = object.containsKey("text");
  command.hasEffect = object.containsKey("effect");
  command.hasDaily = object.containsKey("daily");
  if(command.hasDaily && !robo::readDaily(object["daily"],command.daily)){sendError(400,"invalid_daily_ticket");return;}
  if (command.hasDuration) {
    if (object["duration_ms"].is<bool>() || !object["duration_ms"].is<int64_t>()) {
      sendError(400, "invalid_duration"); return;
    }
    command.durationMs = object["duration_ms"].as<int64_t>();
  }
  if (command.hasOn) {
    if (!object["on"].is<bool>()) { sendError(400, "invalid_light_fields"); return; }
    command.on = object["on"].as<bool>();
  }
  if (command.hasText && !jsonString(object["text"], command.text)) {
    sendError(400, "invalid_print_text"); return;
  }
  if (command.hasEffect && !jsonString(object["effect"], command.effect)) {
    sendError(400, "invalid_light_fields"); return;
  }
  if(command.action=="reconnect_yoyo") {
    if(object.size()!=2){sendError(400,"unexpected_fields",command.requestId.c_str());return;}
    bool disconnect=false, advertise=false;
    uint8_t peer[6]={};
    robo::Result result;result.requestId=command.requestId;result.status="rejected";result.error="reconnect_unavailable";
    {
      Lock guard(bleMutex);
      if(pairReconnectResult.requestId==command.requestId)result=pairReconnectResult;
      else if(ROBO_ENABLE_BONDED_YOYO && companionStorage && bondAccess.paired() &&
              !bondAccess.repairing() && !pairReconnecting) {
        disconnect=bondAccess.connected();advertise=!disconnect;
        memcpy(peer,currentPeer,6);
        pairReconnecting=disconnect;pairReconnectStarted=millis();
        pairStage=disconnect?"reconnecting":"reconnect_ready";
        result.ok=true;result.status=disconnect?"accepted":"completed";result.error="";
        pairReconnectResult=result;
      }
    }
    // Disconnect only the admitted phone. Preserve bond, printer BLE client,
    // accepted actuator jobs and their request IDs. Never reset the BLE stack.
    if(disconnect && esp_ble_gap_disconnect(peer)!=ESP_OK) {
      Lock guard(bleMutex);
      pairReconnecting=false;pairStage="reconnect_failed";
      pairReconnectResult.ok=false;pairReconnectResult.status="failed";
      pairReconnectResult.error="phone_disconnect_failed";
    }
    if(advertise)BLEDevice::startAdvertising();
    {Lock guard(bleMutex);if(pairReconnectResult.requestId==command.requestId)result=pairReconnectResult;}
    StaticJsonDocument<384> output;resultJson(output,result);
    sendJson(result.ok?(result.status=="accepted"?202:200):409,output);return;
  }
  if(command.action=="repair_yoyo") {
    if(object.size()!=2){sendError(400,"unexpected_fields",command.requestId.c_str());return;}
    bool start=false;
    robo::Result result;result.requestId=command.requestId;result.status="rejected";result.error="pairing_unavailable";
    {
      Lock guard(bleMutex);
      if(pairRepairResult.requestId==command.requestId)result=pairRepairResult;
      else if(ROBO_ENABLE_BONDED_YOYO && companionStorage && !pairReconnecting && bondAccess.beginRepair()) {
        memcpy(pairRepairPeer,bondAccess.owner(),6);
        pairRepairStarted=millis();pairStage="repairing";
        result.ok=true;result.status="accepted";result.error="";pairRepairResult=result;start=true;
      } else if(bondAccess.connected()) result.error="phone_link_active";
    }
    if(start) {
      int count=esp_ble_get_bond_device_num();
      bool found=false,valid=count>=0;
      if(count>0) {
        std::vector<esp_ble_bond_dev_t> devices(static_cast<size_t>(count));
        valid=esp_ble_get_bond_device_list(&count,devices.data())==ESP_OK;
        if(valid)for(int i=0;i<count;++i)if(!memcmp(pairRepairPeer,devices[i].bd_addr,6))found=true;
      }
      if(!valid || !found) {Lock guard(bleMutex);finishPairRepair(valid);}
      else if(esp_ble_remove_bond_device(pairRepairPeer)!=ESP_OK) {Lock guard(bleMutex);finishPairRepair(false);}
      {Lock guard(bleMutex);result=pairRepairResult;}
    }
    StaticJsonDocument<384> output;resultJson(output,result);
    sendJson(result.ok?(result.status=="accepted"?202:200):409,output);return;
  }
  if(command.action=="pair_yoyo") {
    if(object.size()!=2){sendError(400,"unexpected_fields",command.requestId.c_str());return;}
    bool opened=false;
    {
      Lock guard(bleMutex);
      if(ROBO_ENABLE_BONDED_YOYO && companionStorage && bondAccess.enrolling(millis())) {
        // A repeated request must not rotate the PIN during phone input.
        opened=true;
      } else if(ROBO_ENABLE_BONDED_YOYO && companionStorage && bondAccess.open(millis())) {
        preparePairPin();
        pairStage="ready";
        pairAuthMode=pairFailure=-1;pairStackSuccess=false;
        opened=true;
      }
    }
    robo::Result result;result.requestId=command.requestId;result.ok=opened;
    result.status=opened?"completed":"rejected";result.error=opened?"":"pairing_unavailable";
    StaticJsonDocument<384> output;resultJson(output,result);sendJson(opened?200:409,output);return;
  }
  const robo::Result result = processCommand(command);
  StaticJsonDocument<384> output;
  resultJson(output, result);
  sendJson(result.ok ? (result.status == "accepted" ? 202 : 200) : 409, output);
}

void httpResult() {
  if (!httpAuthorized()) return;
  const std::string requestId = http.arg("request_id").c_str();
  if (!robo::validId(requestId)) {
    sendError(400, "invalid_request_id"); return;
  }
  {
    Lock guard(bleMutex);
    if(pairReconnectResult.requestId==requestId) {
      StaticJsonDocument<384> output;resultJson(output,pairReconnectResult);sendJson(200,output);return;
    }
    if(pairRepairResult.requestId==requestId) {
      StaticJsonDocument<384> output;resultJson(output,pairRepairResult);sendJson(200,output);return;
    }
  }
  robo::Result result;
  bool found;
  {
    Lock guard(coreMutex);
    found = controller.lookup(requestId, result);
  }
  if (!found) {
    sendError(404, "request_not_found", requestId.c_str()); return;
  }
  StaticJsonDocument<384> output;
  resultJson(output, result);
  sendJson(200, output);
}

std::vector<std::string> split(const std::string& line) {
  std::vector<std::string> fields;
  size_t begin = 0;
  do {
    const size_t end = line.find('|', begin);
    if (end == std::string::npos) { fields.push_back(line.substr(begin)); break; }
    fields.push_back(line.substr(begin, end - begin));
    begin = end + 1;
  } while (fields.size() < 8);
  return fields;
}

const char* shortError(const std::string& error) {
  if (error.compare(0, 5, "tank_") == 0) return "TANK";
  if (error == "auto_print_disabled")return "MUTE";
  if (error == "scene_cooldown")return "COOL";
  if (error == "focus_invalid_state")return "STATE";
  if (error == "actions_disabled") return "LOCK";
  if (error == "pump_disabled" || error == "light_disabled" || error == "printer_disabled") return "OFF";
  if (error == "pump_busy" || error == "printer_busy") return "BUSY";
  if (error == "request_id_conflict") return "ID";
  if (error == "idempotency_cache_full") return "FULL";
  if (error == "invalid_duration") return "TIME";
  if (error == "printer_write_failed" || error == "printer_recovery_required" || error.find("printer_ble_") == 0) return "IO";
  if (error == "unknown_action") return "ACT";
  return "ARG";
}

std::string bleResult(const robo::Result& result) {
  if (!result.ok) return "E:" + result.requestId + ":" + shortError(result.error);
  return (result.status == "accepted" ? "A:" : "D:") + result.requestId;
}

std::string bleQuery(const std::string& field) {
  const Sample current = copySample();
  for(const char* known:{"soil","desk","env","soil_raw","soil_v2","desk_v2"})
    if(field==known){pairLastQuery=known;break;}
  char buffer[32];
  if ((field == "soil" || field == "air" || field == "uv" || field == "env" || field == "ambient") &&
      static_cast<uint32_t>(millis() - current.timestamp) > 3000) return "E:STALE";
  if(field=="soil" || field=="desk") {
    robo::SensorCalibration saved;{Lock guard(coreMutex);saved=sensorCalibration;}
    return field=="soil"?robo::soilBleReply(current.soil,current.soilValid,saved):
      robo::deskBleReply(current.soil,current.soilValid,saved,current.temperature,current.humidity,current.environmentValid);
  }
  if(field=="soil_raw")return "ADC:"+(current.soilValid?std::to_string(current.soil):"x")+":"+(current.soilValid?"1":"0");
  if(field=="desk_v2") {
    const std::string raw=current.soilValid?std::to_string(current.soil):"x";
    const std::string temp=current.environmentValid?std::to_string(int(lround(current.temperature*10))):"x";
    const std::string hum=current.environmentValid?std::to_string(int(lround(current.humidity))):"x";
    return "K:"+raw+":"+temp+":"+hum;
  }
  if (field == "soil_v2") {
    robo::SensorCalibration saved;
    { Lock guard(coreMutex); saved = sensorCalibration; }
    const bool calibrated = saved.soilValid();
    const std::string raw = current.soil >= 0 ? std::to_string(current.soil) : "x";
    const std::string percent = current.soilValid && calibrated ?
      std::to_string(static_cast<int>(lround(robo::soilPercent(current.soil, saved.dry, saved.wet)))) : "x";
    return "S:" + raw + ":" + percent + ":" + (current.soilValid ? "1" : "0") + ":" + (calibrated ? "1" : "0");
  }
  if (field == "air" || field == "uv" || field == "ambient") {
    const int raw = field == "air" ? current.air : field == "uv" ? current.uv : current.ambient;
    const bool valid = field == "air" ? current.airValid : field == "uv" ? current.uvValid : current.ambientValid;
    return std::string(field == "air" ? "A:" : field == "uv" ? "U:" : "B:") + (raw >= 0 ? std::to_string(raw) : "x") + ":" + (valid ? "1" : "0");
  }
  if (field == "env") {
    if (!current.environmentValid) return "E:x:x:0";
    snprintf(buffer, sizeof(buffer), "E:%.1f:%.1f:1", current.temperature, current.humidity);
    return buffer;
  }
  if(field=="pm25" || field=="voc") {
    float value=field=="pm25"?current.sen54.pm25:current.sen54.voc;
    if(!current.sen54Valid || !std::isfinite(value))return field=="pm25"?"M:x:0":"V:x:0";
    snprintf(buffer,sizeof(buffer),"%s:%.1f:1",field=="pm25"?"M":"V",value);return buffer;
  }
  if(field=="tank") {snprintf(buffer,sizeof(buffer),"W:%d:%d",current.tankMm,current.tankMm>=20);return buffer;}
  Lock guard(coreMutex);
  if(field=="focus") {
    snprintf(buffer,sizeof(buffer),"F:%d:%lu:%lu",int(controller.focus().phase()),
      static_cast<unsigned long>(controller.focus().remaining(millis())/1000),
      static_cast<unsigned long>(controller.focus().duration()/1000));return buffer;
  }
  if(field=="auto")return controller.autoPrint()?"AUTO:1":"AUTO:0";
  if (field == "pump") {
    snprintf(buffer, sizeof(buffer), "P:%d:%d:%lu", ROBO_ENABLE_PUMP && ActionsReady ? 1 : 0,
             controller.pumpOn() ? 1 : 0, static_cast<unsigned long>(controller.remainingMs(millis())));
    return buffer;
  }
  if (field == "light") {
    snprintf(buffer, sizeof(buffer), "L:%d:%d", ROBO_ENABLE_LIGHT && ActionsReady ? 1 : 0, controller.lightOn() ? 1 : 0);
    return buffer;
  }
  if (field == "printer") {
    const std::string status = controller.printerStatus();
    const char* label = status == "disabled" ? "off" : status == "bytes_sent" ? "sent" :
                        (status == "write_failed" || status == "recovery_required") ? "fail" : status.c_str();
    snprintf(buffer, sizeof(buffer), "T:%d:%s", ROBO_ENABLE_PRINTER && ActionsReady ? 1 : 0, label);
    return buffer;
  }
  return "E:FIELD";
}

std::string handleBle(const std::string& text) {
  auto fields = split(text);
  if(!fields.empty() && fields[0]=="V") {
    if(!ROBO_ENABLE_BONDED_YOYO || !bondAccess.authorized())return "E:PAIR";
    if(fields.size()<2 || (fields[1]!="S" && fields[1]!="C" && fields[1]!="R"))return "E:FORMAT";
    // The bearer exists only inside firmware. Nothing secret enters the Skill.
    fields[0]=fields[1];fields[1]=ROBO_DEVICE_TOKEN;
  } else if(ROBO_ENABLE_BONDED_YOYO) return "E:PAIR";
  if(fields.size()==2 && fields[0]=="Q") {
    if(!ROBO_ENABLE_DIAGNOSTIC_READ || !diagnosticRead.take(fields[1].c_str(),millis()))return "E:AUTH";
    return bleQuery("soil");
  }
  if (fields.size() < 2 || !tokenMatches(fields[1])) return "E:AUTH";
  if (fields[0] == "S") {
    if (fields.size() == 2) return "Q:soil,pump,air,uv";
    return fields.size() == 3 ? bleQuery(fields[2]) : "E:FORMAT";
  }
  if (fields[0] == "R") {
    if (fields.size() != 3 || fields[2].size() > 8 || !robo::validId(fields[2])) return "E:FORMAT";
    robo::Result result;
    Lock guard(coreMutex);
    return controller.lookup(fields[2], result) ? bleResult(result) : "E:" + fields[2] + ":MISS";
  }
  if (fields[0] != "C" || fields.size() < 4 || fields[2].size() > 8 || !robo::validId(fields[2]))
    return "E:FORMAT";
  robo::Command command;
  command.requestId = fields[2];
  command.action = fields[3];
  if ((command.action == "water" || command.action == "focus_start") && fields.size() == 5) {
    uint32_t duration;
    if (!robo::parseUnsigned(fields[4], duration)) return "E:" + command.requestId + ":TIME";
    command.hasDuration = true;
    command.durationMs = duration;
  } else if (command.action == "light" && (fields.size() == 5 || fields.size() == 6) &&
             (fields[4] == "0" || fields[4] == "1")) {
    command.hasOn = true;
    command.on = fields[4] == "1";
    command.hasEffect = fields.size() == 6;
    if (command.hasEffect) command.effect = fields[5];
  } else if (command.action == "print" && fields.size() == 5) {
    command.hasText = true;
    command.text = fields[4];
  } else if(command.action=="auto_print" && fields.size()==5 && (fields[4]=="0" || fields[4]=="1")) {
    command.hasOn=true;command.on=fields[4]=="1";
  } else if(command.action=="print_scene" && fields.size()==7 && (fields[5]=="0" || fields[5]=="1")) {
    command.hasOn=true;command.on=fields[5]=="1";
    command.hasEffect=command.hasText=true;command.effect=fields[4];command.text=fields[6];
  } else if ((command.action != "stop_water" && command.action != "focus_pause" && command.action != "focus_resume" && command.action != "focus_reset") || fields.size() != 4) {
    return "E:" + command.requestId + ":ARG";
  }
  return bleResult(processCommand(command));
}

// All BLE helpers below run under bleMutex. Send only to the original conn_id:
// Arduino's notify() broadcasts to every peer, including one being rejected.
void bleReply(const robo::BleTicket& ticket, const std::string& response) {
  if (!bleSession.mayReply(ticket) || bleGattsIf == ESP_GATT_IF_NONE) return;
  // No multipart notifications. Every response fits the default ATT MTU 23.
  const std::string value = response.size() <= 20 ? response : "E:SIZE";
  esp_ble_gatts_send_indicate(bleGattsIf, ticket.connectionId, bleCharacteristic->getHandle(),
      value.size(), reinterpret_cast<uint8_t*>(const_cast<char*>(value.data())), false);
}

void queueBle(const robo::BleTicket& ticket, const uint8_t* data, size_t size) {
  if (!bleSession.matches(ticket)) return;
  if (!data || size == 0 || size > MaxBleBytes || std::memchr(data, '\0', size)) {
    bleReply(ticket, "E:SIZE"); return;
  }
  BleJob job{};
  job.ticket = ticket;
  memcpy(job.text, data, size);
  if (xQueueSend(bleQueue, &job, 0) != pdTRUE) bleReply(ticket, "E:BUSY");
}

// Public Arduino BLE hook, called after the library handles each GATTS event.
// Read the actual peer/bytes from the event instead of the shared getValue().
void bleGattEvent(esp_gatts_cb_event_t event, esp_gatt_if_t gattsIf, esp_ble_gatts_cb_param_t* param) {
  Lock guard(bleMutex);
  if (event == ESP_GATTS_REG_EVT && param->reg.status == ESP_GATT_OK) {
    bleGattsIf = gattsIf;
    return;
  }
  if (!bleCharacteristic) return;
  if (event == ESP_GATTS_WRITE_EVT) {
    const auto& write = param->write;
    const robo::BleTicket ticket = bleSession.ticketFor(write.conn_id);
    if (!ticket.valid()) return;
    if (write.handle == bleNotifications->getHandle() && !write.is_prep && write.offset == 0 && write.len == 2) {
      bleSession.setNotifications(write.conn_id, (write.value[0] & 1) != 0);
    } else if (write.handle == bleCharacteristic->getHandle()) {
      if (write.is_prep) {
        if (!blePreparedWrite.append(ticket, write.offset, write.value, write.len))
          bleReply(ticket, "E:FORMAT");
      } else {
        blePreparedWrite.reset();
        if (write.offset != 0) bleReply(ticket, "E:FORMAT");
        else queueBle(ticket, write.value, write.len);
      }
    }
  } else if (event == ESP_GATTS_EXEC_WRITE_EVT) {
    const robo::BleTicket ticket = bleSession.ticketFor(param->exec_write.conn_id);
    if (!ticket.valid()) return;
    if (param->exec_write.exec_write_flag == ESP_GATT_PREP_WRITE_CANCEL) {
      blePreparedWrite.reset();
    } else if (param->exec_write.exec_write_flag == ESP_GATT_PREP_WRITE_EXEC) {
      char text[MaxBleBytes + 1]{};
      if (blePreparedWrite.finish(ticket, text))
        queueBle(ticket, reinterpret_cast<const uint8_t*>(text), strlen(text));
      else bleReply(ticket, "E:FORMAT");
    }
  }
}

class PairCallbacks : public BLESecurityCallbacks {
  uint32_t onPassKeyRequest() override {return 0;} // Display-only; no Just Works.
  void onPassKeyNotify(uint32_t pin) override {
    Lock guard(bleMutex);++pairNotifications;
    if(bondAccess.enrolling(millis())) {pairPin=pin;pairStage="waiting_for_pin";}
    Serial.printf("YOYO passkey requested; window=%d\n",bondAccess.enrolling(millis()));
  }
  bool onConfirmPIN(uint32_t) override {return false;}
  bool onSecurityRequest() override {Lock guard(bleMutex);++pairRequests;return companionStorage && bondAccess.mayPair(millis());}
  void onAuthenticationComplete(esp_ble_auth_cmpl_t result) override {
#if ROBO_PRINTER_BLE
    // Printer transport does not enroll as a phone or overwrite its bond.
    if (printer_ble::isPeer(result.bd_addr)) return;
#endif
    bool accepted=false;
    {
      Lock guard(bleMutex);
      pairAuthMode=result.auth_mode;pairFailure=result.fail_reason;pairStackSuccess=result.success;
      const bool strong=result.success && (result.auth_mode & ESP_LE_AUTH_REQ_SC_MITM_BOND)==ESP_LE_AUTH_REQ_SC_MITM_BOND;
      const bool wasPaired=bondAccess.paired();
      accepted=companionStorage && bondAccess.authenticate(result.bd_addr,strong,millis());
      if(accepted && !wasPaired && companionPrefs.putBytes("phone",bondAccess.owner(),6)!=6) {
        bondAccess=robo::BondedAccess{};accepted=false;
      }
      // ESP-IDF 4.4.7: HCI_ERR_MAX_ERR(0x43)+10+SMP_RSP_TIMEOUT(0x16).
      pairStage=accepted?"authenticated":!result.success?(result.fail_reason==0x63?"pairing_timeout":"authentication_failed"):
        !strong?"security_mode_rejected":"enrollment_rejected";
      Serial.printf("YOYO auth success=%d mode=%u reason=%u accepted=%d elapsed_ms=%lu\n",
        result.success,result.auth_mode,result.fail_reason,accepted,static_cast<unsigned long>(millis()-pairStarted));
    }
    Serial.printf("YOYO encrypted connection: %s\n",accepted?"authenticated":"rejected");
    if(!accepted)esp_ble_gap_disconnect(result.bd_addr);
  }
};

class ServerCallbacks : public BLEServerCallbacks {
  void onConnect(BLEServer* server, esp_ble_gatts_cb_param_t* param) override {
#if ROBO_PRINTER_BLE
    if (printer_ble::isPeer(param->connect.remote_bda)) return;
#endif
    bool accepted;
    {
      Lock guard(bleMutex);
      ++pairConnections;
      const bool allowed=!ROBO_ENABLE_BONDED_YOYO || (companionStorage && bondAccess.allowsConnection(millis()));
      accepted = allowed && bleSession.connect(param->connect.conn_id);
      if (accepted) {
        pairStage="authenticating";pairStarted=millis();
        pairAuthMode=pairFailure=-1;pairStackSuccess=false;pairEncryptionError=0;
        pairToolSeen=false;pairToolCount=0;
        pairLastQuery="";
        memcpy(currentPeer,param->connect.remote_bda,6);
        bondAccess.connect(currentPeer);
        xQueueReset(bleQueue);
        blePreparedWrite.reset();
      } else if(!bondAccess.connected()) {
        pairStage=!companionStorage?"storage_unavailable":"window_closed";
      }
    }
    if (accepted) {
      BLEDevice::stopAdvertising();
      if(ROBO_ENABLE_BONDED_YOYO) {
        const auto error=esp_ble_set_encryption(param->connect.remote_bda,ESP_BLE_SEC_ENCRYPT_MITM);
        {Lock guard(bleMutex);pairEncryptionError=error;if(error!=ESP_OK)pairStage="encryption_start_failed";}
        if(error!=ESP_OK)server->disconnect(param->connect.conn_id);
      }
    }
    else {
      Serial.println("YOYO connection not admitted; enrollment closed, storage unavailable or link occupied");
      server->disconnect(param->connect.conn_id);
    }
  }
  void onDisconnect(BLEServer*, esp_ble_gatts_cb_param_t* param) override {
#if ROBO_PRINTER_BLE
    if (printer_ble::isPeer(param->disconnect.remote_bda)) return;
#endif
    bool ownerLeft;
    {
      Lock guard(bleMutex);
      ownerLeft = bleSession.disconnect(param->disconnect.conn_id);
      if (ownerLeft) {
        pairDisconnectReason=param->disconnect.reason;
        if(bondAccess.authorized())pairStage="paired_idle";
        else if(!strcmp(pairStage,"authenticating") || !strcmp(pairStage,"waiting_for_pin"))pairStage="link_lost";
        bondAccess.disconnect();
        if(pairReconnecting) {
          pairReconnecting=false;pairStage="reconnect_ready";
          pairReconnectResult.ok=true;pairReconnectResult.status="completed";pairReconnectResult.error="";
        }
        blePreparedWrite.reset();
        bleCharacteristic->setValue("RoboPlanter/1");
        xQueueReset(bleQueue);
      }
    }
    // A refused (unadmitted) connection also stops connectable advertising.
    // Restart after its disconnect, unless an admitted phone still owns it.
    bool advertise;
    {Lock guard(bleMutex);advertise=!bondAccess.connected();}
    if (advertise) BLEDevice::startAdvertising();
  }
};

void bleTask(void*) {
  BleJob job;
  for (;;) {
    if (xQueueReceive(bleQueue, &job, portMAX_DELAY) == pdTRUE) {
      Lock guard(bleMutex);
      if (!bleSession.matches(job.ticket)) continue;
      if(pairReconnecting){bleReply(job.ticket,"E:BUSY");continue;}
      if(ROBO_ENABLE_BONDED_YOYO && !bondAccess.authorized()){bleReply(job.ticket,"E:PAIR");continue;}
      // Serialize the short command commit with disconnect. Already accepted
      // pump/print work retains its local deadline/result; it is not replayed.
      const std::string response = handleBle(job.text);
      pairToolSeen=true;pairToolAt=millis();++pairToolCount;
      bleReply(job.ticket, response);
    }
  }
}

void failClosed(const char* reason) {
  if (ROBO_RELAY_WIRING_CONFIRMED) digitalWrite(pins::Pump, LOW);
  Serial.println(reason);
  for (;;) delay(1000);
}
}  // namespace

void setup() {
  // Disable both documented revisions' motor/heater nets. This firmware never
  // runs the robot drive controller. External pump driver MUST have a pulldown
  // so it remains off during reset, before these GPIOs become outputs.
  const int safePins[] = {2, 3, 39, 11, 12};
  for (int pin : safePins) { digitalWrite(pin, LOW); pinMode(pin, OUTPUT); }
  if (ROBO_RELAY_WIRING_CONFIRMED) {
    digitalWrite(pins::Pump, LOW);
    pinMode(pins::Pump, OUTPUT);
  }
  if (ROBO_ENABLE_PRINTER && !ROBO_PRINTER_BLE) {
    digitalWrite(pins::PrinterTx, HIGH);
    pinMode(pins::PrinterTx, OUTPUT);
  }
  Serial.begin(115200);
  coreMutex = xSemaphoreCreateMutex();
  sensorMutex = xSemaphoreCreateMutex();
  lightMutex = xSemaphoreCreateMutex();
  bleMutex = xSemaphoreCreateMutex();
  printQueue = xQueueCreate(1, sizeof(PrintJob));
  bleQueue = xQueueCreate(4, sizeof(BleJob));
  if (!coreMutex || !sensorMutex || !lightMutex || !bleMutex || !printQueue || !bleQueue)
    failClosed("Startup failed: task resources unavailable");
  loadSensorCalibration();
  loadAutoLight();
  if (xTaskCreate(pumpTask, "pump-deadline", 3072, nullptr, 10, nullptr) != pdPASS)
    failClosed("Startup failed: pump deadline task unavailable");

  analogReadResolution(12);
  if (ROBO_ENABLE_SOIL) { pinMode(pins::Soil, INPUT); analogSetPinAttenuation(pins::Soil, ADC_11db); }
  if (ROBO_ENABLE_AIR) { pinMode(pins::Air, INPUT); analogSetPinAttenuation(pins::Air, ADC_11db); }
  if (ROBO_ENABLE_UV) { pinMode(pins::Uv, INPUT); analogSetPinAttenuation(pins::Uv, ADC_11db); }
  if (ROBO_ENABLE_AMBIENT_LIGHT) { pinMode(pins::AmbientLight, INPUT); analogSetPinAttenuation(pins::AmbientLight, ADC_11db); }
  if (ROBO_ENABLE_SHT31 || ROBO_ENABLE_DHT20 || ROBO_ENABLE_SEN54) {
    Wire.begin(pins::Sda, pins::Scl);
    Wire.setClock(100000);
    Wire.setTimeOut(30);
    probeKnownI2cSensors();
  }
  if (ROBO_ENABLE_LIGHT) {
#if ROBO_WS2813_RMT
    if (!pixels.begin()) failClosed("Startup failed: WS2813 RMT unavailable");
#else
    pixels.begin();
#endif
    pixels.setBrightness(ROBO_LED_BRIGHTNESS);
    pixels.clear();
    pixels.show();
  }
  if (ROBO_ENABLE_PRINTER && !ROBO_PRINTER_BLE) {
    printerSerial.begin(ROBO_PRINTER_BAUD, SERIAL_8N1, pins::PrinterRx, pins::PrinterTx);
    if (!printerSerial) failClosed("Startup failed: printer UART unavailable");
  }
  if (ROBO_ENABLE_ULTRASONIC) {
    pinMode(pins::Ultrasonic, INPUT);
    attachInterrupt(pins::Ultrasonic, onTankEdge, CHANGE);
  }
  if (xTaskCreate(sensorTask, "sensors", 4096, nullptr, 1, nullptr) != pdPASS ||
      xTaskCreate(printerTask, "printer", 6144, nullptr, 1, nullptr) != pdPASS ||
      (ROBO_ENABLE_LIGHT && xTaskCreate(lightTask, "light-frames", 3072, nullptr, 1, nullptr) != pdPASS) ||
      xTaskCreate(bleTask, "ble-commands", 6144, nullptr, 2, nullptr) != pdPASS)
    failClosed("Startup failed: worker task unavailable");

  char suffix[5];
  snprintf(suffix, sizeof(suffix), "%04X", static_cast<unsigned>(ESP.getEfuseMac() & 0xffff));
  deviceId = String("RoboPlanter-") + suffix;
  if (ROBO_WIFI_STA) {
    wifi_setup::begin(deviceId);
  } else {
    WiFi.mode(WIFI_AP);
    if (!WiFi.softAP(deviceId.c_str(), ROBO_AP_PASSWORD, 1, false, 2))
      failClosed("Startup failed: Wi-Fi AP unavailable");
  }
  const char* headers[] = {"X-Device-Token", "Content-Type"};
  http.collectHeaders(headers, 2);
  http.on("/api/v1/state", HTTP_GET, []() {
    if (!httpAuthorized()) return;
    StaticJsonDocument<4096> output;
    stateJson(output);
    sendJson(200, output);
  });
  http.on("/api/v1/command", HTTP_POST, httpCommand);
  http.on("/api/v1/wifi",HTTP_GET,[](){
    if(!httpAuthorized())return;
    StaticJsonDocument<768> out;out["device_id"]=deviceId;
    wifi_setup::state(out.createNestedObject("network"));sendJson(200,out);
  });
  http.on("/api/v1/wifi",HTTP_POST,[](){
    if(!httpAuthorized())return;
    if(!ROBO_WIFI_STA){sendError(409,"station_mode_required");return;}
    if(http.header("Content-Type").indexOf("application/json")!=0){sendError(415,"content_type_required");return;}
    String body=http.arg("plain");if(body.length()>384){sendError(413,"body_size_invalid");return;}
    StaticJsonDocument<512> in;
    if(deserializeJson(in,body)||!in.is<JsonObject>()){sendError(400,"invalid_wifi_request");return;}
    std::string id,ssid,password;
    if(in.size()!=3 || !jsonString(in["request_id"],id) || !robo::validId(id) ||
       !jsonString(in["ssid"],ssid) || !jsonString(in["password"],password)) {sendError(400,"invalid_wifi_request");return;}
    if(id==wifi_setup::requestId) {
      StaticJsonDocument<768> out;out["device_id"]=deviceId;wifi_setup::state(out.createNestedObject("network"));sendJson(200,out);return;
    }
    {Lock guard(coreMutex);if(controller.pumpOn() || controller.printerBusy()){sendError(409,"actuator_busy");return;}}
    if(!wifi_setup::submit(id.c_str(),ssid.c_str(),password.c_str())){sendError(409,"wifi_setup_unavailable");return;}
    StaticJsonDocument<768> out;out["device_id"]=deviceId;wifi_setup::state(out.createNestedObject("network"));sendJson(202,out);
  });
  http.on("/api/v1/wifi/setup",HTTP_POST,[](){
    if(!httpAuthorized())return;
    if(!ROBO_WIFI_STA || !wifi_setup::openWindow()){sendError(409,"setup_unavailable");return;}
    StaticJsonDocument<768> out;out["device_id"]=deviceId;wifi_setup::state(out.createNestedObject("network"));sendJson(200,out);
  });
  http.on("/api/v1/calibration", HTTP_POST, httpCalibration);
  http.on("/api/v1/auto-light", HTTP_POST, httpAutoLight);
  http.on("/api/v1/sensors/soil", HTTP_POST, httpSoil);
  http.on("/api/v1/diagnostic-session", HTTP_POST, httpDiagnosticSession);
  http.on("/api/v1/result", HTTP_GET, httpResult);
  http.onNotFound([]() { sendError(404, "not_found"); });
  http.begin();

  companionStorage=companionPrefs.begin("rp-companion",false);
  if(companionStorage) {
    uint8_t owner[6];
    if(companionPrefs.getBytesLength("phone")==6 && companionPrefs.getBytes("phone",owner,6)==6)bondAccess.restore(owner);
    {Lock guard(coreMutex);controller.restoreAutoPrint(companionPrefs.getBool("auto-print",true));}
  }
  BLEDevice::init(deviceId.c_str());
  BLEDevice::setCustomGapHandler(pairGapEvent);
  if(ROBO_ENABLE_BONDED_YOYO) {
    BLEDevice::setSecurityCallbacks(new PairCallbacks());
    bondSecurity.setCapability(ESP_IO_CAP_OUT);
    bondSecurity.setAuthenticationMode(ESP_LE_AUTH_REQ_SC_MITM_BOND);
    bondSecurity.setInitEncryptionKey(ESP_BLE_ENC_KEY_MASK | ESP_BLE_ID_KEY_MASK);
    bondSecurity.setRespEncryptionKey(ESP_BLE_ENC_KEY_MASK | ESP_BLE_ID_KEY_MASK);
    bondSecurity.setKeySize(16);
  }
  BLEDevice::setMTU(247);
#if ROBO_PRINTER_BLE
  if (!printer_ble::begin()) failClosed("Startup failed: BLE printer configuration");
#endif
  BLEDevice::setCustomGattsHandler(bleGattEvent);
  BLEServer* server = BLEDevice::createServer();
  server->setCallbacks(new ServerCallbacks());
  BLEService* service = server->createService(ServiceUuid);
  bleCharacteristic = service->createCharacteristic(CharacteristicUuid,
      BLECharacteristic::PROPERTY_WRITE | BLECharacteristic::PROPERTY_NOTIFY);
  // Declaration properties alone are not ATT permissions. Never expose the
  // library's last written value, which contains the caller's device token.
  bleCharacteristic->setAccessPermissions(ROBO_ENABLE_BONDED_YOYO ? ESP_GATT_PERM_WRITE_ENC_MITM : ESP_GATT_PERM_WRITE);
  bleNotifications = new BLE2902();
  bleCharacteristic->addDescriptor(bleNotifications);
  bleCharacteristic->setValue("RoboPlanter/1");
  service->start();
  BLEAdvertising* advertising = BLEDevice::getAdvertising();
  advertising->addServiceUUID(ServiceUuid);
  advertising->setScanResponse(true);
  advertising->start();
  Serial.printf("%s ready; network=%s; actions %s\n", deviceId.c_str(),ROBO_WIFI_STA?"station":"access-point",
                ROBO_ENABLE_ACTIONS && credentialsConfigured() ? "configured" : "disabled");
}

void loop() {
  if(ROBO_WIFI_STA)wifi_setup::service();
  {
    Lock guard(bleMutex);
    if(pairReconnecting && uint32_t(millis()-pairReconnectStarted)>5000) {
      pairReconnecting=false;pairStage="reconnect_failed";
      pairReconnectResult.ok=false;pairReconnectResult.status="failed";
      pairReconnectResult.error="phone_disconnect_timeout";
    }
    if(bondAccess.repairing() && pairRepairResult.status=="accepted" && uint32_t(millis()-pairRepairStarted)>10000) {
      // A late remove callback may still complete recovery. Do not admit any
      // phone while key deletion has an unknown outcome.
      pairStage="repair_restart_required";pairRepairResult.ok=false;
      pairRepairResult.status="failed";pairRepairResult.error="pair_repair_timeout";
    }
  }
  static uint32_t lastNetworkLog=0;
  if (millis()-lastNetworkLog>=5000) {
    lastNetworkLog=millis();
    Serial.printf("RoboPlanter network connected=%d ip=%s\n",WiFi.status()==WL_CONNECTED,
                  (ROBO_WIFI_STA?WiFi.localIP():WiFi.softAPIP()).toString().c_str());
  }
  http.handleClient();
  delay(2);
}
