peterpanstechland/RoboPlanter/firmware/indicator/src/main.cpp

#include <Arduino.h>
#include "local_soil.h"
#include <Preferences.h>
#include <math.h>
#include "config.h"
#include "device_settings.h"
#include "settings_ui.h"
#include "garden_store.h"
#include "garden_ui.h"
#include "garden_art.h"
#include "indicator_board.h"
#include "lcd_diagnostics.h"
#include "planter_client.h"
#include "planter_presentation.h"
#include "receipt_preview.h"
#include "ui_model.h"
#include "ui_photos.h"
#include "ui_text.h"
#include "ui_theme.h"

namespace {
using planter::State;
using ui_theme::Icon;
bool displayReady=false, clientReady=false, controlsOpen=false, prefsReady=false;
bool confirmOpen=false;
bool focusSound=false;
planter::Action confirmAction=planter::Action::Water;
planter::PrintReceipt confirmReceipt;
uint8_t dailyPreviewPage=0;
ui::Model model;
ui::TouchGate touch;
Preferences preferences;
size_t photoIndex=0;
constexpr uint16_t kWarning=0xF60C, kDanger=0xEAE9, kAqua=0xA6FD;
struct Rect { int16_t x,y,w,h; };
constexpr Rect kBack{16,12,44,44}, kTheme{322,12,90,44}, kSettings{420,12,44,44};
constexpr Rect kConnection{274,12,44,44};
constexpr Rect kControls{24,374,432,52}, kDismiss{368,76,88,40};
constexpr Rect kHardware[]={{24,143,210,86},{246,143,210,86},{24,241,210,86},{246,241,210,86}};
constexpr planter::Action kActions[]={planter::Action::Water,planter::Action::StopWater,planter::Action::Light,planter::Action::Print};
constexpr Rect kConfirmCancel{24,374,142,52}, kConfirmGo{178,374,278,52};
constexpr Rect kTimerPresets[]={{24,314,136,44},{172,314,136,44},{320,314,136,44}};
constexpr Rect kTimerToggle{24,374,278,52}, kTimerReset{316,374,140,52};
constexpr Rect kFocusSound{328,78,128,30};
constexpr Rect kPhotoPrevious{24,391,64,44}, kPhotoNext{392,391,64,44};
const char *tr(const char *zh,const char *en) { return device_settings::getLanguage()==device_settings::Language::English?en:zh; }
const ui_theme::Theme &theme() { return ui_theme::get(model.theme()); }
uint16_t contrastInk(uint16_t color) {
  auto linear=[](float c){return c<=0.04045f?c/12.92f:powf((c+0.055f)/1.055f,2.4f);};
  const float l=0.2126f*linear(((color>>11)&31)/31.0f)+0.7152f*linear(((color>>5)&63)/63.0f)+0.0722f*linear((color&31)/31.0f);
  return l>0.179f?0x1082:0xFFFF;
}
bool inside(const Rect &r,int32_t x,int32_t y) {return x>=r.x && x<r.x+r.w && y>=r.y && y<r.y+r.h;}
bool tapped(const Rect &r) {return inside(r,touch.startX(),touch.startY()) && inside(r,touch.lastX(),touch.lastY());}
void label(int16_t x,int16_t y,const char *s,uint16_t color,uint8_t scale=1) {ui_text::draw(indicator::display(),x,y,s,color,scale);}
void centered(int16_t y,const char *s,uint16_t color,uint8_t scale=1) {label((480-ui_text::width(s,scale))/2,y,s,color,scale);}
void clipped(int16_t x,int16_t y,const char *s,int16_t maxWidth,uint16_t color) {
  char out[96]={};size_t n=0,i=0;
  while(s[i] && n<sizeof(out)-5) {
    const uint8_t lead=static_cast<uint8_t>(s[i]);
    size_t bytes=lead<0x80?1:(lead>=0xC2 && lead<=0xDF)?2:(lead>=0xE0 && lead<=0xEF)?3:(lead>=0xF0 && lead<=0xF4)?4:0;
    bool valid=bytes!=0;
    for(size_t j=1;valid && j<bytes;++j) {const uint8_t c=static_cast<uint8_t>(s[i+j]);if(c==0 || (c&0xC0)!=0x80)valid=false;}
    if(!valid){bytes=1;out[n]='?';}else memcpy(out+n,s+i,bytes);
    out[n+bytes]=0;
    if(ui_text::width(out)>maxWidth-14) {out[n]=0;strcat(out,"..");break;}
    n+=bytes;i+=bytes;
  }
  label(x,y,out,color);
}
void icon(Icon i,int x,int y,int size,uint16_t color) {ui_theme::icon(indicator::display(),i,x,y,size,color);}
void pill(const Rect &r,const char *s,uint16_t fill,uint16_t ink,bool outline=false) {
  auto &g=indicator::display();
  g.fillRoundRect(r.x,r.y+3,r.w,r.h,10,theme().background);
  g.fillRoundRect(r.x,r.y,r.w,r.h,10,fill);
  if(outline)g.drawRoundRect(r.x,r.y,r.w,r.h,10,theme().muted);
  const uint8_t size=ui_text::widthSized(s,24)<=r.w-24?24:16;
  ui_text::drawSized(g,r.x+(r.w-ui_text::widthSized(s,size))/2,r.y+(r.h-size)/2,s,ink,size);
}
const char *connection(const State &s,uint32_t now) {
  if(!clientReady)return tr("连接未就绪","Connection unavailable");
  if(!s.received)return s.wifi?tr("等待花盆回应","Waiting for planter"):tr("等待花盆连接","Planter offline");
  if(!s.wifi)return tr("离线 · 上次读数","Offline / old readings");
  if(!planter::fresh(s,now))return tr("读数已过期","Readings expired");
  return tr("花盆已连接","Planter connected");
}
void statusStrip(const State &s,uint32_t now) {
  auto &g=indicator::display();
  g.drawFastHLine(24,448,432,theme().surface);
  g.fillCircle(29,463,3,planter::fresh(s,now)?theme().accent:kWarning);
  label(40,455,indicator::touchReady()?connection(s,now):tr("触摸未就绪","Touch unavailable"),theme().muted);
  const uint8_t page=static_cast<uint8_t>(model.page());
  for(uint8_t i=0;i<5;++i)g.fillRoundRect(367+i*18,460,i==page?12:6,5,2,i==page?theme().accent:theme().surface);
}
void header(const State &s) {
  auto &g=indicator::display();
  if(model.page()!=ui::Page::Face || controlsOpen || model.themesOpen() || settings_ui::isOpen() || garden_ui::isOpen()) {
    g.fillRoundRect(kBack.x,kBack.y,kBack.w,kBack.h,10,theme().surface);
    icon(Icon::Back,28,24,20,theme().ink);
    clipped(74,25,settings_ui::isOpen()?settings_ui::title():garden_ui::isOpen()?garden_ui::title():tr("工位盆栽","WORKER"),200,theme().muted);
  } else {
    icon(Icon::Leaf,24,20,28,theme().accent);
    label(62,15,tr("工位伙伴","WORKER"),theme().accent);
    label(62,33,tr("智能盆栽","SMART PLANTER"),theme().ink);
  }
  // Both header glyphs use a crisp 2x pixel grid, centred on the button row.
  icon(Icon::Wifi,280,18,32,device_settings::wifiState().phase==device_settings::WifiPhase::Connected?theme().ink:theme().muted);
  pill(kTheme,model.themesOpen()?tr("收起","Close"):tr("主题","Theme"),theme().surface,theme().ink);
  g.fillRoundRect(kSettings.x,kSettings.y,kSettings.w,kSettings.h,10,settings_ui::isOpen()?theme().accent:theme().surface);
  icon(Icon::Settings,426,18,32,settings_ui::isOpen()?contrastInk(theme().accent):theme().ink);
}
void title(const char *s,const char *subtitle) {
  ui_text::drawSized(indicator::display(),24,76,s,theme().ink,24);
  if(subtitle)label(25,115,subtitle,theme().muted);
}
planter::Reading soilReading(const State &s) {
  auto reading=s.soilPercent;
  if(!s.soilCalibrationKnown || !s.soilCalibrated)reading.valid=false;
  return reading;
}
void miniReading(int x,Icon kind,const planter::Reading &r,const char *unit,bool fresh) {
  ui_theme::accentIcon(indicator::display(),kind,x,412,32,theme().ink,kind==Icon::Temp?theme().second:kAqua);
  char value[24];if(r.valid)snprintf(value,sizeof(value),"%.0f%s%s",r.value,unit,fresh?"":"*");else strlcpy(value,"--",sizeof(value));
  label(x+36,420,value,r.valid&&fresh?theme().ink:theme().muted);
}
void facePage(const State &s,uint32_t now) {
  garden_ui::drawHome(now,model.theme());
  statusStrip(s,now);
}
void readingCard(const Rect &r,Icon kind,const char *name,const planter::Reading &reading,const char *unit,bool fresh,const char *invalid=nullptr,bool percent=false,const char *validHint=nullptr) {
  auto &g=indicator::display();
  g.fillRoundRect(r.x,r.y,r.w,r.h,12,theme().card);
  ui_theme::accentIcon(g,kind,r.x+14,r.y+33,32,theme().cardInk,kind==Icon::Temp?0xFBAE:kAqua);
  label(r.x+54,r.y+12,name,theme().cardMuted);
  char value[28];if(reading.valid)snprintf(value,sizeof(value),!strcmp(unit," ADC")?"%.0f%s":"%.1f%s",reading.value,unit);else strlcpy(value,"--",sizeof(value));
  label(r.x+54,r.y+35,value,reading.valid&&fresh?theme().cardInk:theme().cardMuted,2);
  if(percent) {
    g.fillRoundRect(r.x+54,r.y+73,r.w-70,5,2,0xD6B9);
    if(reading.valid) {
      const float v=fminf(100.0f,fmaxf(0.0f,reading.value));
      const int amount=static_cast<int>((r.w-70)*v/100.0f);
      if(amount>0)g.fillRoundRect(r.x+54,r.y+73,amount,5,2,fresh?theme().accent:theme().cardMuted);
    }
  }
  const char *hint=!reading.valid?(invalid?invalid:tr("等待传感器","No sensor data")):!fresh?tr("上次读数 · 已过期","Old / expired"):(validHint?validHint:tr("有效读数","Current reading"));
  label(r.x+14,r.y+r.h-22,hint,theme().cardMuted);
}
void todayPage(const State &s,uint32_t now) {
  title(tr("今日状态","Plant status"),tr("今日状态 · 慢慢照顾，也照顾自己","A little care, at your pace."));
  const bool fresh=planter::fresh(s,now);
  const bool soilRaw=s.soilCalibrationKnown && !s.soilCalibrated && s.soilRaw.valid;
  readingCard({24,145,210,106},Icon::Water,tr("土壤湿度","Soil moisture"),soilRaw?s.soilRaw:soilReading(s),soilRaw?" ADC":"%",fresh,!s.soilCalibrationKnown?tr("等待土壤数据","No soil data"):!s.soilCalibrated?tr("传感器待校准","Calibrate sensor"):tr("传感器暂不可用","Sensor unavailable"),!soilRaw,soilRaw?tr("传感器待校准","Calibrate sensor"):nullptr);
  readingCard({246,145,210,106},Icon::Temp,tr("空气温度","Temperature"),s.temperature,"C",fresh);
  readingCard({24,261,210,106},Icon::Humidity,tr("空气湿度","Humidity"),s.humidity,"%",fresh,nullptr,true);
  auto &g=indicator::display();g.fillRoundRect(246,261,210,106,12,theme().card);
  label(260,273,tr("设备动态","Devices"),theme().cardMuted);
  icon(Icon::Water,260,301,20,0x4B94);
  label(289,302,!s.pumpKnown?tr("泵 · 未知","Pump / unknown"):!s.pumpEnabled?tr("泵 · 未启用","Pump / disabled"):s.pumpOn?tr("泵 · 运行中","Pump / running"):tr("泵 · 已停止","Pump / stopped"),theme().cardInk);
  icon(Icon::Light,260,333,20,0x9B83);
  label(289,334,!s.lightKnown?tr("补光 · 未知","Fill / unknown"):!s.lightEnabled?tr("补光 · 未启用","Fill / disabled"):s.lightOn?tr("补光 · 已开启","Fill / on"):tr("补光 · 已关闭","Fill / off"),theme().cardInk);
  if(s.received&&!fresh)label(374,273,tr("旧状态","Old state"),theme().cardMuted);
  pill(kControls,tr("照顾小盆栽    >","Plant care    >"),theme().accent,contrastInk(theme().accent));
  statusStrip(s,now);
}
void infoRow(int y,Icon symbol,const char *name,const char *value) {
  icon(symbol,39,y-2,20,theme().cardInk);
  label(72,y,name,theme().cardMuted);clipped(213,y,value,222,theme().cardInk);
}
void infoPage(const State &s,uint32_t now) {
  title(tr("工位信息","Desk notes"),tr("工位情报 · 来自花盆的消息","A note from your planter."));
  auto &g=indicator::display();g.fillRoundRect(24,145,432,255,12,theme().card);
  const bool fresh=planter::fresh(s,now);char buffer[80];
  infoRow(161,Icon::Wifi,tr("连接","Connection"),connection(s,now));
  g.drawFastHLine(40,190,400,0xD6B9);
  if(s.received&&s.ageKnown)snprintf(buffer,sizeof(buffer),"%lus",static_cast<unsigned long>((static_cast<uint64_t>(now-s.receivedMs)+s.sampleAgeMs)/1000));else strlcpy(buffer,tr("未知","Unknown"),sizeof(buffer));
  infoRow(202,Icon::Clock,tr("采样距今","Sample age"),buffer);
  if(s.sen54Enabled) {
    if(s.pm25.valid)snprintf(buffer,sizeof(buffer),"%.1f ug/m3%s",s.pm25.value,fresh?"":tr(" / 旧值"," / old"));else strlcpy(buffer,tr("等待传感器","No sensor data"),sizeof(buffer));
  } else if(s.airRaw.valid)snprintf(buffer,sizeof(buffer),tr("%.0f 原始值%s","%.0f raw%s"),s.airRaw.value,fresh?"":tr(" / 旧值"," / old"));else strlcpy(buffer,tr("暂无有效值","No reading"),sizeof(buffer));
  infoRow(240,Icon::Leaf,s.sen54Enabled?"PM2.5":tr("空气原始值","Air raw"),buffer);
  const auto &lightReading=s.ambientLightEnabled?s.ambientLightRaw:s.uvRaw;
  if(lightReading.valid)snprintf(buffer,sizeof(buffer),tr("%.0f 原始值%s","%.0f raw%s"),lightReading.value,fresh?"":tr(" / 旧值"," / old"));else strlcpy(buffer,tr("暂无有效值","No reading"),sizeof(buffer));
  infoRow(278,Icon::Light,s.ambientLightEnabled?tr("环境光","Ambient"):tr("紫外原始值","UV raw"),buffer);
  if(s.vocIndex.valid)snprintf(buffer,sizeof(buffer),"%.0f%s",s.vocIndex.value,fresh?"":tr(" / 旧值"," / old"));else strlcpy(buffer,tr("暂无有效值","No reading"),sizeof(buffer));
  infoRow(316,Icon::Leaf,tr("VOC 指数","VOC index"),buffer);
  if(s.tankDistance.valid) {
    if(s.tankLevel.valid)snprintf(buffer,sizeof(buffer),"%.0f%% / %.0f mm%s",s.tankLevel.value,s.tankDistance.value,fresh?"":tr(" / 旧值"," / old"));
    else snprintf(buffer,sizeof(buffer),tr("%.0f mm / 待校准","%.0f mm / calibrate"),s.tankDistance.value);
  } else strlcpy(buffer,tr("暂无有效值","No reading"),sizeof(buffer));
  if(!s.tankDistance.valid && fresh && s.tankEnabled) {
    const char* reason=!strcmp(s.tankError,"trigger_level_mismatch")?tr("信号脚电平异常","Signal pin fault"):
      !strcmp(s.tankError,"signal_high_after_timeout")?tr("信号持续高电平","Signal stuck high"):tr("未收到有效回波","No valid echo");
    snprintf(buffer,sizeof(buffer),"GPIO%u / %s",s.tankGpio,reason);
  }
  infoRow(354,Icon::Water,tr("水箱液位","Tank level"),buffer);
  label(40,412,tr("YOYO 在手机上陪你","Use YOYO on your phone"),theme().muted);
  statusStrip(s,now);
}
void photosPage(const State &s,uint32_t now) {
  ui_text::drawSized(indicator::display(),24,76,tr("照片时光","Little escapes"),theme().ink,24);
  const size_t count=ui_photos::count();auto &g=indicator::display();
  if(count) {
    photoIndex%=count;
    if(!ui_photos::draw(g,photoIndex,40,110)) {g.fillRoundRect(40,110,400,280,12,theme().surface);centered(225,tr("这张照片暂时无法显示","Photo unavailable"),theme().muted);}
    pill(kPhotoPrevious,"<",theme().card,theme().cardInk);pill(kPhotoNext,">",theme().card,theme().cardInk);
    const char *caption=ui_photos::caption(photoIndex);clipped(104,397,caption&&caption[0]?caption:tr("喜欢的瞬间","A moment you love"),270,theme().ink);
    char countLabel[20];snprintf(countLabel,sizeof(countLabel),"%u / %u",unsigned(photoIndex+1),unsigned(count));centered(420,countLabel,theme().muted);
  } else {
    g.fillRoundRect(40,126,400,260,8,theme().card);
    g.fillRect(56,142,368,180,theme().surface);
    g.fillRect(56,286,368,36,theme().accent);
    for(int i=0;i<12;++i)g.fillRect(56+i*32,265-(i%3)*12,i==11?16:32,57+(i%3)*12,theme().accent);
    g.fillRect(325,171,32,32,theme().second);g.fillRect(317,179,48,16,theme().second);
    ui_theme::face(g,model.theme(),224,250,60,false,now);
    centered(343,tr("还没有照片 · 放一张喜欢的风景","No photos yet. Add a favorite view."),theme().cardInk);
    centered(408,tr("左滑，留一段时间给自己","Swipe left for a little time to yourself."),theme().muted);
  }
  statusStrip(s,now);
}
void focusPage(const State &s,uint32_t now) {
  // Sound is opt-in and persists locally; the phone remains the speech output.
  auto &timer=model.timer();auto &g=indicator::display();
  title(tr("专注时光","Time to focus"),timer.done()?tr("这一段结束啦，伸个懒腰吧","All done. Time for a stretch."):timer.running()?tr("正在专注 · 换时长请先重置","Focusing / reset to change duration"):timer.phase()==ui::TimerPhase::Paused?tr("暂停一下 · 换时长请先重置","Paused / reset to change duration"):tr("专注与休息，都值得认真对待","Make room for both focus and rest."));
  pill(kFocusSound,focusSound?tr("提示音 开","Sound on"):tr("提示音 关","Sound off"),theme().surface,theme().ink);
  g.fillRoundRect(24,145,432,153,12,theme().card);
  icon(Icon::Clock,43,164,22,theme().cardMuted);
  label(76,166,timer.running()?tr("正在专注","FOCUS IN PROGRESS"):timer.done()?tr("做得很好","WELL DONE"):timer.phase()==ui::TimerPhase::Paused?tr("慢慢来","TAKE YOUR TIME"):tr("一次只做一件事","ONE THING AT A TIME"),theme().cardMuted);
  const uint32_t seconds=(timer.remainingMs(now)+999)/1000;char clock[12];
  snprintf(clock,sizeof(clock),"%02lu:%02lu",static_cast<unsigned long>(seconds/60),static_cast<unsigned long>(seconds%60));
  label(46,198,clock,theme().cardInk,4);
  const auto &pet=garden_store::model().current();
  garden_art::draw(g,model.theme(),static_cast<uint8_t>(garden_store::model().selected()),
    static_cast<uint8_t>(garden_store::model().stage()),385,226,43,pet.health,pet.mood,pet.weeds,now);
  const int progress=timer.durationMs()?static_cast<uint64_t>(timer.durationMs()-timer.remainingMs(now))*392/timer.durationMs():0;
  g.fillRoundRect(44,278,392,6,3,0xD6B9);if(progress>0)g.fillRoundRect(44,278,progress,6,3,theme().accent);
  const char *presets[]={tr("专注 25 分","Focus 25m"),tr("短歇 5 分","Break 5m"),tr("长歇 15 分","Rest 15m")};
  const bool canChange=timer.phase()==ui::TimerPhase::Ready || timer.done();
  for(uint8_t i=0;i<3;++i) {
    const uint32_t durations[]={1500000U,300000U,900000U};
    const bool selected=timer.durationMs()==durations[i];
    pill(kTimerPresets[i],presets[i],selected?theme().second:theme().surface,selected?contrastInk(theme().second):canChange?theme().ink:theme().muted);
  }
  pill(kTimerToggle,timer.running()?tr("暂停一下","Pause"):timer.phase()==ui::TimerPhase::Paused?tr("继续计时","Resume"):timer.done()?tr("再来一段","Start again"):tr("开始计时","Start focus"),theme().accent,contrastInk(theme().accent));
  pill(kTimerReset,tr("重置","Reset"),theme().card,theme().cardInk);
  statusStrip(s,now);
}
bool enabled(planter::Action action,const State &s,uint32_t now) {
  const bool available=planter::fresh(s,now) && !s.commandBlocked && clientReady;
  switch(action) {
    case planter::Action::Water:return available && s.pumpEnabled && s.waterAllowed && !s.pumpOn;
    case planter::Action::StopWater:return clientReady && s.wifi && s.pumpEnabled;
    case planter::Action::Light:return available && s.lightEnabled;
    case planter::Action::Print:return available && s.printerEnabled && strcmp(s.printerStatus,"recovery_required");
    default:return available && s.focusKnown;
  }return false;
}
const char *disabledReason(planter::Action action,const State &s,uint32_t now) {
  const auto link=planter_presentation::link(s,device_settings::wifiState(),now,clientReady);
  if(link!=planter_presentation::Link::Ready)
    return planter_presentation::linkText(link,device_settings::getLanguage()==device_settings::Language::English);
  if(action==planter::Action::Print && !strcmp(s.printerStatus,"recovery_required"))
    return tr("请重启打印机和主控","Restart printer + board");
  if(s.uncertain)return tr("请先检查上次操作","Check previous action");
  if(s.commandBlocked)return tr("正在执行上次操作","Previous action busy");
  if(action==planter::Action::Print)return tr("打印机尚未启用","Printer disabled");
  if(action==planter::Action::Light)return tr("灯带尚未启用","Light disabled");
  if(action==planter::Action::Water && s.pumpEnabled && !s.waterAllowed) {
    if(!strcmp(s.waterBlockReason,"tank_uncalibrated"))return tr("请先校准水位","Calibrate tank first");
    if(!strcmp(s.waterBlockReason,"tank_low"))return tr("水位低，请加水","Tank low / refill");
    return tr("请检查水位传感器","Check tank sensor");
  }
  return s.pumpOn?tr("水泵正在运行","Pump is running"):tr("水泵尚未启用","Pump disabled");
}
const char *commandLabel(const State &s) {
  if(s.uncertain)return tr("结果未知 · 请先检查花盆","Unknown / check planter first");
  if(!strcmp(s.commandStatus,"accepted"))return tr("设备已接受 · 等待完成","Accepted / awaiting completion");
  if(!strcmp(s.commandStatus,"completed"))return tr("设备报告软件动作已完成","Software action completed");
  if(!strcmp(s.commandStatus,"rejected"))return tr("设备拒绝了这次操作","Action rejected");
  if(!strcmp(s.commandStatus,"queued"))return tr("指令正在排队","Command queued");
  return s.commandStatus[0]?tr("设备响应待确认","Check device response"):tr("照顾植物，也给自己一点停顿","A small pause for you and your plant.");
}
void confirmPage(const State &s,uint32_t now) {
  auto &g=indicator::display();const bool water=confirmAction==planter::Action::Water;
  title(water?tr("确认浇水","Water plant?"):tr("打印便签","Print a note"),water?tr("浇水前，先看看土壤和接水盘","Check the soil and tray first."):
    confirmReceipt.isDaily?"":
    confirmReceipt.requiresRaster?tr("预览与实际发送文字一致","This text will be sent to the printer."):
    tr("英文便签 · 兼容旧版打印固件","This text will be sent to the printer."));
  if(water) {
    ui_theme::face(g,model.theme(),132,229,76,(now%5300)<160,now);
    g.fillRoundRect(244,145,212,156,12,theme().card);
    icon(Icon::Water,260,161,26,0x4B94);label(298,168,tr("手动浇水","Water pulse"),theme().cardMuted);
    char duration[24];snprintf(duration,sizeof(duration),"%.1f s",PLANTER_WATER_DURATION_MS/1000.0f);
    label(264,210,duration,theme().cardInk,3);
    label(260,270,tr("按时长控制，不估算水量","Timed pulse, not volume"),theme().cardMuted);
    centered(326,tr("确认后发送一次浇水指令","One watering request on confirmation."),theme().ink);
  } else if (confirmReceipt.isDaily) {
    receipt_preview::drawDaily(g,confirmReceipt.daily,dailyPreviewPage,48,110,theme().card,theme().cardInk);
    char page[64];snprintf(page,sizeof(page),tr("滑动 %u/%u","Swipe %u/%u"),dailyPreviewPage+1,receipt_preview::DailyPreviewPages);
    label(318,88,page,theme().muted);
  } else if (confirmReceipt.layout32) {
    receipt_preview::draw(g,confirmReceipt.text,54,142,372,204,theme().card,theme().cardInk);
    centered(352,s.printerAutocut?tr("已启用自动切纸 · 请留意出纸口","Auto-cut enabled. Keep the outlet clear."):
      tr("打印后请沿撕纸口取下","Tear off the receipt after printing."),theme().muted);
  } else {
    g.fillRect(54,148,372,192,theme().card);
    for(int x=54;x<426;x+=12) {g.fillTriangle(x,148,x+6,142,x+11,148,theme().card);g.fillTriangle(x,340,x+6,346,x+11,340,theme().card);}
    char visible[sizeof(confirmReceipt.text)];memcpy(visible,confirmReceipt.text,sizeof(visible));
    char *line=visible;unsigned row=0;
    while(*line && row<6) {
      char *next=strchr(line,'\n');if(next)*next=0;
      ui_text::drawSized(g,76,row?202+(row-1)*25:167,line,theme().cardInk,row?16:24);
      ++row;if(!next)break;line=next+1;
    }
    for(int x=75;x<406;x+=12)g.drawFastHLine(x,199,6,theme().cardMuted);
    centered(352,s.printerAutocut?tr("已启用自动切纸 · 请留意出纸口","Auto-cut enabled. Keep the outlet clear."):
      tr("打印后请沿撕纸口取下","Tear off the receipt after printing."),theme().muted);
  }
  pill(kConfirmCancel,tr("取消","Cancel"),theme().card,theme().cardInk);
  const bool changed=!water&&((confirmReceipt.requiresRaster&&!s.printerRaster)||
    (confirmReceipt.layout32&&!s.printerLayout32)||(confirmReceipt.isDaily&&!s.printerDaily));
  const bool active=enabled(confirmAction,s,now)&&!changed;
  pill(kConfirmGo,active?(water?tr("确认浇水","Water now"):tr("打印这张便签","Print note")):
    changed?tr("请重新打开预览","Reopen preview"):disabledReason(confirmAction,s,now),active?theme().second:theme().surface,active?contrastInk(theme().second):theme().muted);
  statusStrip(s,now);
}
void controlsPage(const State &s,uint32_t now) {
  if(confirmOpen){confirmPage(s,now);return;}
  ui_text::drawSized(indicator::display(),24,76,tr("照顾盆栽","Plant care"),theme().ink,24);pill(kDismiss,tr("收起","Close"),theme().surface,theme().ink);
  label(24,115,tr("一点水，一点光，一点工作间隙","A little water, light and a break."),theme().muted);
  char waterLabel[32];snprintf(waterLabel,sizeof(waterLabel),tr("浇水 %.1f 秒","Water %.1f s"),PLANTER_WATER_DURATION_MS/1000.0);
  const char *labels[]={waterLabel,tr("立即停泵","Stop pump"),s.lightOn?tr("关闭补光","Fill light off"):tr("开启补光","Fill light on"),tr("打印便签","Print note")};
  const Icon symbols[]={Icon::Water,Icon::Water,Icon::Light,Icon::Print};
  auto &g=indicator::display();
  for(uint8_t i=0;i<4;++i) {
    const bool active=enabled(kActions[i],s,now);const Rect &r=kHardware[i];
    const uint16_t fill=active?(i==1?kDanger:i==3?theme().second:theme().accent):theme().card;
    const uint16_t ink=active?contrastInk(fill):theme().cardMuted;
    g.fillRoundRect(r.x,r.y,r.w,r.h,12,fill);
    icon(symbols[i],r.x+14,r.y+15,24,ink);label(r.x+50,r.y+19,labels[i],ink);
    const char *hint=active?(i==1?tr("网络停泵，非物理急停","Network stop only"):i==0||i==3?tr("点击查看确认页","Tap to review first"):tr("白光补光，关后恢复状态","White fill / status when off")):disabledReason(kActions[i],s,now);
    clipped(r.x+14,r.y+55,hint,r.w-28,ink);
  }
  g.fillRoundRect(24,340,432,86,12,theme().surface);
  label(38,352,commandLabel(s),s.uncertain?kWarning:theme().ink);
  if(s.uncertain)pill({24,379,432,44},tr("已现场检查 · 解除操作锁定","Checked on site / unlock actions"),theme().card,theme().cardInk,true);
  else {
    const bool connected=planter_presentation::link(s,device_settings::wifiState(),now,clientReady)==planter_presentation::Link::Ready;
    clipped(38,383,!connected?tr("打开设置中的花盆连接查看原因","Open Settings > Planter connection"):
      s.commandError[0]?tr("操作未完成，请检查设备连接",s.commandError):tr("软件完成不等于已出水或已出纸","Software result, not physical proof."),402,theme().muted);
    if(s.pumpKnown&&s.pumpOn&&planter::fresh(s,now)) {
      // Decorative motion only; no guessed amount, delivery or completion rate.
      for(int i=0;i<7;++i)g.fillRect(40+i*56,412,30,4,((now/120+i)%7)<3?kAqua:theme().muted);
    }
  }
  statusStrip(s,now);
}
void themePage(uint32_t now) {
  ui_text::drawSized(indicator::display(),24,74,tr("为工位换个心情","Choose your desk mood"),theme().ink,24);
  static const char *englishNames[]={"Desk garden","Lilac break","Mint breeze","Warm desk","Night shift","Berry note","Moss study","Pixel arcade"};
  auto &g=indicator::display();
  for(uint8_t i=0;i<ui_theme::kCount;++i) {
    const int x=24+(i%2)*222,y=119+(i/2)*82;const auto &t=ui_theme::get(i);
    g.fillRoundRect(x,y,210,74,10,t.surface);
    if(i==model.theme()){g.drawRoundRect(x,y,210,74,10,theme().accent);g.drawRoundRect(x+1,y+1,208,72,9,theme().accent);}
    const auto &pet=garden_store::model().current();
    garden_art::draw(g,i,static_cast<uint8_t>(garden_store::model().selected()),
      static_cast<uint8_t>(garden_store::model().stage()),x+39,y+38,31,pet.health,pet.mood,pet.weeds,now);
    label(x+82,y+16,tr(t.name,englishNames[i]),t.ink);
    g.fillRect(x+82,y+44,16,7,t.accent);g.fillRect(x+103,y+44,16,7,t.second);g.fillRect(x+124,y+44,16,7,t.card);
    if(i==model.theme())label(x+149,y+41,tr("当前","Active"),t.muted);
  }
}
void draw(const State &s,uint32_t now) {
  ui_theme::background(indicator::display(),model.theme());header(s);
  if(settings_ui::isOpen())settings_ui::draw(now,model.theme());
  else if(garden_ui::isOpen()){garden_ui::draw(now,model.theme());statusStrip(s,now);}
  else if(model.themesOpen())themePage(now);
  else if(controlsOpen)controlsPage(s,now);
  else switch(model.page()) {
    case ui::Page::Face:facePage(s,now);break;
    case ui::Page::Today:todayPage(s,now);break;
    case ui::Page::Info:infoPage(s,now);break;
    case ui::Page::Photos:photosPage(s,now);break;
    case ui::Page::Focus:focusPage(s,now);break;
  }
  if(!indicator::present()) {
    // A timed-out handoff must never let the next loop draw into a buffer
    // whose ownership is uncertain. Keep the last scanout frame intact.
    displayReady=false;
    Serial.println("Indicator frame handoff failed; rendering stopped.");
  }
}
void tickCompanion(uint32_t now) {
  garden_store::service(now);
  const bool running=model.timer().running();
  const auto preset=model.timer().preset();
  model.timer().tick(now);
  if(running && model.timer().done()) {
    if(preset==ui::Preset::Focus25)garden_ui::focusCompleted(now);
    if(focusSound)local_soil::notifyFocusComplete();
  }
}
void handle(ui::Gesture gesture,const State &s,uint32_t now) {
  tickCompanion(now);
  if(gesture==ui::Gesture::None)return;
  if(gesture==ui::Gesture::Tap && tapped(kConnection)) {
    garden_ui::close();model.closeThemes();controlsOpen=false;confirmOpen=false;
    settings_ui::openConnection();return;
  }
  if(gesture==ui::Gesture::Tap && tapped(kSettings)) {
    if(settings_ui::isOpen())settings_ui::close();
    else {garden_ui::close();model.closeThemes();controlsOpen=false;confirmOpen=false;settings_ui::open();}
    return;
  }
  if(garden_ui::isOpen()) {
    if(gesture==ui::Gesture::Tap && tapped(kBack))garden_ui::close();
    else if(gesture==ui::Gesture::Tap && tapped(kTheme)){garden_ui::close();model.openThemes();}
    else garden_ui::handle(gesture,touch,now);
    return;
  }
  if(settings_ui::isOpen()) {
    if(gesture==ui::Gesture::Tap && tapped(kBack))settings_ui::back();
    else if(gesture==ui::Gesture::Tap && tapped(kTheme)){settings_ui::close();model.openThemes();}
    else settings_ui::handle(gesture,touch,now);
    return;
  }
  if(gesture!=ui::Gesture::Tap) {
    if(model.themesOpen())return;
    if(confirmOpen){
      if(confirmReceipt.isDaily&&confirmAction==planter::Action::Print){
        if(gesture==ui::Gesture::SwipeLeft&&dailyPreviewPage+1<receipt_preview::DailyPreviewPages)++dailyPreviewPage;
        if(gesture==ui::Gesture::SwipeRight&&dailyPreviewPage>0)--dailyPreviewPage;
      }else confirmOpen=false;
      return;
    }
    if(controlsOpen){controlsOpen=false;return;}
    model.handleGesture(gesture);return;
  }
  if(tapped(kTheme)) {confirmOpen=false;if(model.themesOpen())model.closeThemes();else {controlsOpen=false;model.openThemes();}return;}
  if(tapped(kBack)) {
    if(model.themesOpen())model.closeThemes();else if(confirmOpen)confirmOpen=false;else if(controlsOpen)controlsOpen=false;else model.previousPage();return;
  }
  if(model.themesOpen()) {
    for(uint8_t i=0;i<ui_theme::kCount;++i)if(tapped({int16_t(24+(i%2)*222),int16_t(119+(i/2)*82),210,74})) {
      if(model.selectTheme(i)&&prefsReady)preferences.putUChar("theme",i);return;
    }return;
  }
  if(controlsOpen) {
    if(confirmOpen) {
      if(tapped(kConfirmCancel))confirmOpen=false;
      else if(tapped(kConfirmGo)&&enabled(confirmAction,s,now)) {
        if(planter::submit(confirmAction,false,confirmAction==planter::Action::Print?&confirmReceipt:nullptr))confirmOpen=false;
      }
      return;
    }
    if(tapped(kDismiss)){controlsOpen=false;return;}
    if(s.uncertain&&tapped({24,379,432,44})){planter::acknowledgeUncertain();return;}
    for(uint8_t i=0;i<4;++i)if(tapped(kHardware[i])&&enabled(kActions[i],s,now)) {
      if(kActions[i]==planter::Action::Water||kActions[i]==planter::Action::Print){
        confirmAction=kActions[i];
        if(confirmAction==planter::Action::Print){
          bool english=device_settings::getLanguage()==device_settings::Language::English;
          confirmReceipt=s.printerDaily?planter_presentation::dailyReceipt(s,english,static_cast<int>(garden_store::model().selected()),[]{return esp_random();}):planter_presentation::receipt(s,english);
          dailyPreviewPage=0;
        }
        confirmOpen=true;
      }
      else planter::submit(kActions[i],!s.lightOn);
      return;
    }
    return;
  }
  switch(model.page()) {
    case ui::Page::Face:
      if(garden_ui::handleHome(gesture,touch,now))return;
      if(tapped({72,138,336,200}))model.tapFace();break;
    case ui::Page::Today:if(tapped(kControls))controlsOpen=true;break;
    case ui::Page::Info:break;
    case ui::Page::Photos:
      if(ui_photos::count()) {
        if(tapped(kPhotoPrevious))photoIndex=(photoIndex+ui_photos::count()-1)%ui_photos::count();
        else if(tapped(kPhotoNext))photoIndex=(photoIndex+1)%ui_photos::count();
      }break;
    case ui::Page::Focus:
      if(tapped(kFocusSound)) {focusSound=!focusSound;if(prefsReady)preferences.putBool("focus-sound",focusSound);return;}
      for(uint8_t i=0;i<3;++i)if(tapped(kTimerPresets[i])) {model.timer().selectPreset(static_cast<ui::Preset>(i));return;}
      if(s.focusKnown) {
        if(tapped(kTimerToggle))planter::submit(model.timer().running()?planter::Action::FocusPause:
          model.timer().phase()==ui::TimerPhase::Paused?planter::Action::FocusResume:planter::Action::FocusStart,
          false,nullptr,model.timer().durationMs()/60000);
        else if(tapped(kTimerReset))planter::submit(planter::Action::FocusReset);
        break;
      }
      if(tapped(kTimerToggle))model.timer().toggle(now);else if(tapped(kTimerReset))model.timer().reset();break;
  }
}
}
void setup() {
  Serial.begin(115200);
  Serial.printf("RoboPlanter Indicator boot: flash=%lu psram=%lu\n",static_cast<unsigned long>(ESP.getFlashChipSize()),static_cast<unsigned long>(ESP.getPsramSize()));
  device_settings::begin();
  indicator::setBrightness(device_settings::getBrightness());
  prefsReady=preferences.begin("rp-ui",false);
  if(prefsReady)model.selectTheme(preferences.getUChar("theme",0)%ui_theme::kCount);
  if(prefsReady)focusSound=preferences.getBool("focus-sound",false);
  const bool gardenReady=garden_store::begin(millis());
  Serial.printf("Indicator soil UART task=%s\n",local_soil::begin()?"ready-or-disabled":"failed");
  displayReady=indicator::begin();
  if(!displayReady){Serial.println("Indicator LCD init failed: check OPI PSRAM / original ST7701 panel.");return;}
  clientReady=planter::begin();
  Serial.printf("Indicator init: display=%s touch=%s client_task=%s preferences=%s\n",displayReady?"ready":"failed",indicator::touchReady()?"ready":"not_found",clientReady?"ready":"failed",prefsReady?"ready":"unavailable");
  Serial.println("Indicator renderer: two framebuffers -> VSYNC swap; no full-frame copy.");
  Serial.println("Indicator UI: Worker Smart Planter v3 / growing plant spirit / zh-en settings.");
  Serial.printf("Indicator garden: storage=%s species=%u stage=%u\n",gardenReady?"ready":"unavailable",
    static_cast<unsigned>(garden_store::model().selected()),static_cast<unsigned>(garden_store::model().stage()));
  Serial.printf("Indicator settings: language=%s brightness=%u%% storage=%s\n",
    device_settings::getLanguage()==device_settings::Language::English?"en":"zh",
    indicator::brightness(),device_settings::wifiState().persistenceAvailable?"ready":"unavailable");
  draw(planter::snapshot(),millis());
#if defined(ARDUINO) && defined(RP_LCD_FLASH_STRESS)
  if(displayReady && !lcd_diagnostics::runFlashStress())displayReady=false;
#endif
}
void loop() {
  if(!displayReady){delay(100);return;}
  const uint32_t now=millis();tickCompanion(now);
  int16_t x=0,y=0;const auto input=indicator::readTouchStatus(x,y);
  const ui::TouchInput mapped=input==indicator::TouchStatus::Down?ui::TouchInput::Down:input==indicator::TouchStatus::Up?ui::TouchInput::Up:ui::TouchInput::Invalid;
  const ui::Gesture gesture=touch.update(mapped,x,y,now);
  static uint32_t lastDraw=0;static bool first=true;const State state=planter::snapshot();
  static bool focusSynced=false;static uint32_t focusRevision=0,focusUptime=0;
  if(state.focusKnown && planter::fresh(state,now)) {
    if(!focusSynced || state.focusRevision!=focusRevision || state.uptimeMs<focusUptime) {
      uint32_t remaining=state.focusRemaining;
      if(state.focusPhase==1){uint32_t elapsed=now-state.receivedMs;remaining=elapsed>=remaining?0:remaining-elapsed;}
      const bool justFinished=model.timer().running() && state.focusPhase==3;
      if(state.focusPhase==1 && !settings_ui::isOpen() && !controlsOpen && !garden_ui::isOpen())model.showFocus();
      model.timer().synchronize(state.focusDuration,remaining,state.focusPhase,now);
      if(justFinished && focusSound)local_soil::notifyFocusComplete();
      focusSynced=true;focusRevision=state.focusRevision;
    }
    focusUptime=state.uptimeMs;
  }
  if(gesture!=ui::Gesture::None)handle(gesture,state,now);
  const bool animated=!model.themesOpen() && !settings_ui::isOpen() &&
      (garden_ui::isOpen() || (!controlsOpen && (model.page()==ui::Page::Face || model.page()==ui::Page::Focus)) ||
       (controlsOpen && (confirmOpen || (state.pumpKnown && state.pumpOn && planter::fresh(state,now)))));
  const uint32_t interval=animated?100:1000;
  if(first||gesture!=ui::Gesture::None||now-lastDraw>=interval){draw(state,now);lastDraw=millis();first=false;}
  delay(15);
}
