peterpanstechland/RoboPlanter/firmware/indicator/src/planter_client.cpp

#include "planter_client.h"
#include "../../xiao/include/daily_json.h"
#include "../../xiao/include/auto_light_json.h"
#include "config.h"
#include "device_settings.h"
#include "network_setup.h"
#include "local_soil.h"
#include <ArduinoJson.h>
#include <HTTPClient.h>
#include <WiFi.h>
#include <esp_system.h>
#include <freertos/FreeRTOS.h>
#include <freertos/queue.h>
#include <freertos/semphr.h>
#include <freertos/task.h>
#include <math.h>

namespace {
using namespace planter;
struct Command { Action action; bool on; char id[33]; uint32_t networkRevision; PrintReceipt receipt; uint16_t focusMinutes;
  bool calibrationWrite = false; robo::CalibrationEdit calibration;
  bool lightSettingsWrite=false; robo::AutoLightSettings autoLight; };
State shared;
bool refreshRequested = false, checking = false;
robo::CalibrationEdit lastCalibrationEdit;
uint32_t calibrationNetwork = 0;
robo::AutoLightSettings lastAutoLight;
uint32_t autoLightNetwork=0;
SemaphoreHandle_t lock = nullptr;
QueueHandle_t commands = nullptr, stops = nullptr;
uint32_t bootNonce = 0, sequence = 0;

template<size_t N> void copy(char (&dst)[N], const char *src) {
  strlcpy(dst, src ? src : "", N);
}
bool terminal(const char *status) {
  return !strcmp(status, "completed") || !strcmp(status, "failed") ||
         !strcmp(status, "rejected") || !strcmp(status, "cancelled") ||
         !strcmp(status, "stopped");
}
bool calibrationBusy(CalibrationWrite state) {
  return state == CalibrationWrite::Queued || state == CalibrationWrite::Saving;
}
void calibrationResult(CalibrationWrite state, const char* error = "") {
  xSemaphoreTake(lock, portMAX_DELAY);
  shared.calibrationWrite = state; copy(shared.calibrationError, error);
  xSemaphoreGive(lock);
}
void autoLightResult(CalibrationWrite state, const char* error="") {
  xSemaphoreTake(lock,portMAX_DELAY);
  shared.autoLightWrite=state; copy(shared.autoLightError,error);
  xSemaphoreGive(lock);
}
void networkError(const char *message, NetworkFailure failure = NetworkFailure::Http, int status = 0) {
  xSemaphoreTake(lock, portMAX_DELAY);
  const bool changed = strcmp(shared.networkError, message) || shared.httpStatus != status;
  copy(shared.networkError, message);
  shared.networkFailure = failure;
  shared.httpStatus = static_cast<int16_t>(status);
  shared.wifi = device_settings::planterNetworkReady();
  xSemaphoreGive(lock);
  if (changed) Serial.printf("Indicator network: %s\n", message);
}
void commandResult(const char *id, const char *status, const char *error,
                   bool blocked, bool uncertain = false) {
  xSemaphoreTake(lock, portMAX_DELAY);
  // STOP can supersede an in-flight request while HTTP is waiting.
  if (!strcmp(shared.requestId, id)) {
    copy(shared.commandStatus, status);
    copy(shared.commandError, error);
    shared.commandBlocked = blocked;
    shared.uncertain = uncertain;
  }
  xSemaphoreGive(lock);
}
bool numeric(JsonVariantConst value) {
  return !value.isNull() && (value.is<float>() || value.is<int>() || value.is<unsigned>()) &&
         isfinite(value.as<float>());
}
Reading reading(JsonVariantConst object, const char *field) {
  Reading out;
  out.valid = object["valid"].is<bool>() && object["valid"].as<bool>() && numeric(object[field]);
  if (out.valid) out.value = object[field].as<float>();
  return out;
}
bool configureHttp(HTTPClient &http, WiFiClient &client, const char *path) {
  // A user-selected office/cafe network may have an unrelated 192.168.4.1.
  // Never disclose the planter token there merely because Wi-Fi is connected.
  if (!device_settings::planterNetworkReady()) return false;
  http.setConnectTimeout(kHttpTimeoutMs);
  http.setTimeout(kHttpTimeoutMs);
  http.setReuse(false);
  http.setFollowRedirects(HTTPC_DISABLE_FOLLOW_REDIRECTS);
  const auto endpoint=device_settings::planterEndpoint();
  if (!http.begin(client, String(endpoint.address) + path)) return false;
  http.addHeader("X-Device-Token", PLANTER_DEVICE_TOKEN);
  return true;
}

void uploadSoil() {
  if(!PLANTER_ENABLE_LOCAL_SOIL)return;
  const auto sample=local_soil::snapshot();
  if(!sample.valid)return;
  WiFiClient client;HTTPClient http;
  if(!configureHttp(http,client,"/api/v1/sensors/soil"))return;
  http.addHeader("Content-Type","application/json");
  StaticJsonDocument<256> doc;
  doc["v"]=1;doc["source_boot"]=sample.boot;doc["seq"]=sample.sequence;
  doc["raw"]=sample.raw;doc["age_ms"]=static_cast<uint32_t>(millis()-sample.receivedMs);
  String body;serializeJson(doc,body);
  const int code=http.POST(body);http.end();
  static unsigned accepted=0;
  if(code==200 && ++accepted%10==1)Serial.printf("Indicator soil relay: HTTP 200 raw=%d\n",sample.raw);
}

void pollState() {
  const uint32_t requestNetwork = device_settings::networkRevision();
  WiFiClient client;
  HTTPClient http;
  if (!configureHttp(http, client, "/api/v1/state")) {
    networkError("Invalid HTTP configuration", NetworkFailure::Configuration); return;
  }
  const int code = http.GET();
  if (code != 200) {
    char message[80];
    snprintf(message, sizeof(message), "State HTTP %d%s", code,
             code == 401 || code == 403 ? " - check token" : "");
    networkError(message, code == 401 || code == 403 ? NetworkFailure::Authentication : NetworkFailure::Http, code); http.end(); return;
  }
  const int length = http.getSize();
  if (length < 0 || length > 4096) {
    networkError("Unexpected state body length", NetworkFailure::InvalidState); http.end(); return;
  }
  const String body = http.getString();
  http.end();
  if (requestNetwork != device_settings::networkRevision()) return;
  StaticJsonDocument<4096> doc;
  const auto error = deserializeJson(doc, body);
  if (error || !doc["schema_version"].is<int>() || doc["schema_version"].as<int>() != 1 ||
      !doc["device_id"].is<const char *>()) {
    networkError("Invalid or unsupported state schema", NetworkFailure::InvalidState); return;
  }
  State next;
  next.received = next.wifi = true;
  next.httpStatus = 200;
  next.receivedMs = millis();
  next.networkRevision = requestNetwork;
  copy(next.deviceId, doc["device_id"]);
  next.ageKnown = doc["sample_age_ms"].is<uint32_t>();
  if (next.ageKnown) next.sampleAgeMs = doc["sample_age_ms"].as<uint32_t>();
  next.soilRaw = reading(doc["soil"], "raw");
  next.soilAgeKnown = doc["soil"]["sample_age_ms"].is<uint32_t>() && !doc["soil"]["sample_age_ms"].is<bool>();
  if (next.soilAgeKnown) next.soilAgeMs = doc["soil"]["sample_age_ms"];
  else if (doc["soil"]["source"].isNull()) { next.soilAgeKnown = next.ageKnown; next.soilAgeMs = next.sampleAgeMs; }
  next.soilCalibrationKnown = doc["soil"]["calibrated"].is<bool>();
  next.soilCalibrated = next.soilCalibrationKnown && doc["soil"]["calibrated"].as<bool>();
  next.soilPercent = reading(doc["soil"], "percent");
  next.soilPercent.valid = next.soilPercent.valid && next.soilCalibrated &&
                           next.soilPercent.value >= 0 && next.soilPercent.value <= 100;
  auto cal = doc["calibration"];
  next.calibrationKnown = cal["schema"].is<unsigned>() && cal["schema"].as<unsigned>() == 1 &&
    cal["revision"].is<uint32_t>() && !cal["revision"].is<bool>() && cal["writable"].is<bool>();
  const char* calKeys[] = {"dry", "wet", "full_mm", "empty_mm", "stop_mm"};
  int* calValues[] = {&next.calibration.dry, &next.calibration.wet, &next.calibration.tank.fullMm,
                     &next.calibration.tank.emptyMm, &next.calibration.tank.stopMm};
  for (unsigned i = 0; i < 5; ++i) {
    if (!cal[calKeys[i]].is<int>() || cal[calKeys[i]].is<bool>()) next.calibrationKnown = false;
    else *calValues[i] = cal[calKeys[i]].as<int>();
  }
  robo::SensorCalibration verified;
  next.calibrationKnown = next.calibrationKnown && robo::decodeCalibration(robo::encodeCalibration(next.calibration), verified);
  if (next.calibrationKnown) {
    next.calibration.revision = cal["revision"]; next.calibrationWritable = cal["writable"];
  }
  next.airRaw = reading(doc["air"], "raw");
  next.yoyoEnabled=doc["yoyo"]["enabled"]==true;
  next.yoyoPaired=doc["yoyo"]["paired"]==true;
  next.yoyoConnected=doc["yoyo"]["connected"]==true;
  next.yoyoPairing=doc["yoyo"]["pairing"]==true;
  next.yoyoLinkConnected=doc["yoyo"]["link_connected"]==true;
  next.yoyoRepairSupported=doc["yoyo"]["repair_supported"]==true;
  next.yoyoRepairing=doc["yoyo"]["repairing"]==true;
  next.yoyoReconnectSupported=doc["yoyo"]["reconnect_supported"]==true;
  next.yoyoReconnecting=doc["yoyo"]["reconnecting"]==true;
  next.yoyoNotifications=doc["yoyo"]["notifications"]==true;
  next.yoyoToolSeen=doc["yoyo"]["tool_seen"]==true;
  next.yoyoToolAgeMs=doc["yoyo"]["last_tool_age_ms"] | 0U;
  next.yoyoToolCount=doc["yoyo"]["tool_count"] | 0U;
  next.yoyoWindowMs=doc["yoyo"]["window_remaining_ms"] | 0U;
  next.yoyoFailure=doc["yoyo"]["failure_reason"].is<int16_t>()?doc["yoyo"]["failure_reason"].as<int16_t>():-1;
  if(next.yoyoWindowMs>120000)next.yoyoWindowMs=0;
  snprintf(next.yoyoStage,sizeof(next.yoyoStage),"%s",doc["yoyo"]["stage"]|"");
  next.yoyoPin=doc["yoyo"]["pin"] | 0U;
  next.autoPrintKnown=doc["auto_print"].is<bool>();next.autoPrint=doc["auto_print"] | true;
  auto focus=doc["focus"];
  next.uptimeMs=doc["uptime_ms"] | 0U;
  next.focusKnown=focus["enabled"]==true && focus["phase"].is<unsigned>() && focus["phase"].as<unsigned>()<=3 &&
    focus["duration_ms"].is<uint32_t>() && focus["remaining_ms"].is<uint32_t>() && focus["revision"].is<uint32_t>();
  if(next.focusKnown) {
    next.focusPhase=focus["phase"];next.focusDuration=focus["duration_ms"];next.focusRemaining=focus["remaining_ms"];next.focusRevision=focus["revision"];
    next.focusKnown=next.focusDuration>=60000 && next.focusDuration<=7200000 && next.focusRemaining<=next.focusDuration;
  }
  next.sen54Enabled = doc["sen54"]["enabled"] == true;
  if (next.sen54Enabled) {
    next.pm25 = reading(doc["sen54"], "pm25_ug_m3");
    next.vocIndex = reading(doc["sen54"], "voc_index");
    next.pm25.valid = next.pm25.valid && next.pm25.value >= 0 && next.pm25.value <= 1000;
    next.vocIndex.valid = next.vocIndex.valid && next.vocIndex.value >= 1 && next.vocIndex.value <= 500;
  }
  next.tankEnabled = doc["water_tank"]["enabled"] == true;
  next.tankCalibrated = doc["water_tank"]["calibrated"] == true;
  copy(next.tankError,doc["water_tank"]["error"]|"");
  next.tankGpio=doc["water_tank"]["signal_gpio"].is<uint8_t>()?doc["water_tank"]["signal_gpio"].as<uint8_t>():0;
  if (next.tankEnabled) {
    next.tankDistance = reading(doc["water_tank"], "distance_mm");
    next.tankDistance.valid = next.tankDistance.valid && next.tankDistance.value >= 20 && next.tankDistance.value <= 3500;
    next.tankLevel = reading(doc["water_tank"], "level_pct");
    next.tankLevel.valid = next.tankLevel.valid && next.tankCalibrated && next.tankDistance.valid && next.tankLevel.value >= 0 && next.tankLevel.value <= 100;
  }
  next.uvRaw = reading(doc["uv"], "raw");
  next.ambientLightEnabled = doc["ambient_light"]["enabled"].is<bool>() &&
                            doc["ambient_light"]["enabled"].as<bool>();
  if (next.ambientLightEnabled)
    next.ambientLightRaw = reading(doc["ambient_light"], "raw");
  next.ambientLightRaw.valid = next.ambientLightRaw.valid &&
                              next.ambientLightRaw.value >= 0 && next.ambientLightRaw.value <= 4095;
  next.temperature = reading(doc["environment"], "temperature_c");
  next.humidity = reading(doc["environment"], "humidity_pct");
  next.humidity.valid = next.humidity.valid && next.humidity.value >= 0 && next.humidity.value <= 100;
  const auto pump = doc["pump"];
  next.pumpKnown = pump["enabled"].is<bool>() && pump["on"].is<bool>();
  next.pumpEnabled = next.pumpKnown && pump["enabled"].as<bool>();
  next.waterAllowed = next.pumpEnabled && pump["water_allowed"] == true;
  copy(next.waterBlockReason, pump["water_block_reason"] | "");
  next.pumpOn = next.pumpKnown && pump["on"].as<bool>();
  next.remainingKnown = pump["remaining_ms"].is<uint32_t>();
  if (next.remainingKnown) next.remainingMs = pump["remaining_ms"].as<uint32_t>();
  const auto light = doc["light"];
  next.lightKnown = light["enabled"].is<bool>() && light["on"].is<bool>();
  next.lightEnabled = next.lightKnown && light["enabled"].as<bool>();
  next.lightOn = next.lightKnown && light["on"].as<bool>();
  const auto automatic=doc["auto_light"];
  next.autoLightKnown=automatic["schema"].is<unsigned>() && automatic["schema"].as<unsigned>()==1 &&
    automatic["available"].is<bool>() && automatic["writable"].is<bool>() && automatic["paused"].is<bool>() && automatic["sensor_stale"].is<bool>();
  // Reuse the strict request parser on the four settings fields only.
  StaticJsonDocument<256> lightSettings;
  for(const char* key:{"enabled","revision","on_below","off_above"})lightSettings[key]=automatic[key];
  next.autoLightKnown=next.autoLightKnown && robo::parseAutoLight(lightSettings.as<JsonVariantConst>(),next.autoLight);
  if(next.autoLightKnown) {
    next.autoLightAvailable=automatic["available"];next.autoLightWritable=automatic["writable"];
    next.autoLightPaused=automatic["paused"];next.autoLightStale=automatic["sensor_stale"];
  }
  const auto printer = doc["printer"];
  next.printerKnown = printer["enabled"].is<bool>() && printer["status"].is<const char *>();
  next.printerEnabled = next.printerKnown && printer["enabled"].as<bool>();
  if (next.printerKnown) copy(next.printerStatus, printer["status"]);
  next.printerRaster = next.printerKnown && !strcmp(printer["text_format"] | "", "utf8-raster");
  next.printerDaily = next.printerRaster && !strcmp(printer["daily_layout"] | "", "garden-daily-v2");
  next.printerLayout32 = next.printerRaster && !strcmp(printer["layout"] | "", "receipt32-v2");
  next.printerAutocut = next.printerKnown && printer["autocut"].is<bool>() && printer["autocut"].as<bool>();

  xSemaphoreTake(lock, portMAX_DELAY);
  copy(next.requestId, shared.requestId);
  next.autoLightWrite=shared.autoLightWrite;copy(next.autoLightError,shared.autoLightError);
  if(next.autoLightWrite==CalibrationWrite::Unknown && next.autoLightKnown && requestNetwork==autoLightNetwork &&
     robo::sameAutoLight(next.autoLight,lastAutoLight)) { next.autoLightWrite=CalibrationWrite::Saved;next.autoLightError[0]=0; }
  next.calibrationWrite = shared.calibrationWrite;
  copy(next.calibrationError, shared.calibrationError);
  if (next.calibrationWrite == CalibrationWrite::Unknown && next.calibrationKnown && requestNetwork == calibrationNetwork &&
      next.calibration.revision == lastCalibrationEdit.revision + 1) {
    const auto &edit = lastCalibrationEdit;
    const auto &saved = next.calibration;
    const bool matches = edit.kind == robo::CalibrationKind::Soil ?
      saved.dry == (edit.reset ? -1 : edit.a) && saved.wet == (edit.reset ? -1 : edit.b) :
      saved.tank.fullMm == (edit.reset ? -1 : edit.a) && saved.tank.emptyMm == (edit.reset ? -1 : edit.b) && saved.tank.stopMm == (edit.reset ? -1 : edit.c);
    if (matches) { next.calibrationWrite = CalibrationWrite::Saved; next.calibrationError[0] = 0; }
  }
  copy(next.commandStatus, shared.commandStatus);
  copy(next.commandError, shared.commandError);
  next.commandBlocked = shared.commandBlocked;
  next.commandStartedMs = shared.commandStartedMs;
  next.uncertain = shared.uncertain;
  const char *lastId = doc["last_command"]["request_id"] | "";
  const char *lastStatus = doc["last_command"]["status"] | "";
  if (next.requestId[0] && !strcmp(lastId, next.requestId) && lastStatus[0]) {
    copy(next.commandStatus, lastStatus);
    copy(next.commandError, doc["last_command"]["error"] | "");
    next.commandBlocked = !terminal(lastStatus);
    next.uncertain = false;
  }
  // A timeout is not evidence that an actuator did nothing. Keep other actions
  // blocked until its result is observed or a person acknowledges uncertainty.
  if (next.commandBlocked && millis() - next.commandStartedMs > kCommandResolveMs &&
      !terminal(next.commandStatus)) {
    next.uncertain = true;
    copy(next.commandStatus, "unknown");
    copy(next.commandError, "No final result; inspect planter");
  }
  shared = next;
  xSemaphoreGive(lock);
}

void pollCommandResult() {
  const State pending = planter::snapshot();
  // A newly queued touch can arrive while pollState() is waiting. Do not query
  // a command until its POST has finished, or a normal cache miss could be
  // mistaken for a lost result before the command was ever transmitted.
  if (!pending.requestId[0] || !pending.commandBlocked ||
      terminal(pending.commandStatus) || !strcmp(pending.commandStatus, "queued") ||
      !strcmp(pending.commandStatus, "sending")) return;
  if (uxQueueMessagesWaiting(stops) != 0 || WiFi.status() != WL_CONNECTED) return;

  // IDs generated by this client contain only URL-safe letters/digits/hyphens.
  char path[80];
  snprintf(path, sizeof(path), "/api/v1/result?request_id=%s", pending.requestId);
  WiFiClient client;
  HTTPClient http;
  if (!configureHttp(http, client, path)) return;
  const int code = http.GET();
  if (code != 200 && code != 404) {
    http.end();
    // A failed read is not an actuator failure. Keep the accepted/unknown
    // state and let the next poll retry this read-only result lookup.
    return;
  }
  if (http.getSize() < 0 || http.getSize() > 2048) {
    http.end(); return;
  }
  const String response = http.getString();
  http.end();
  StaticJsonDocument<1024> result;
  if (deserializeJson(result, response) || !result["ok"].is<bool>() ||
      strcmp(result["request_id"] | "", pending.requestId)) return;

  if (code == 404) {
    // Cache eviction or a controller restart can erase an already executed
    // request. A missing result must never cause an automatic POST retry.
    if (!strcmp(result["error"] | "", "request_not_found"))
      commandResult(pending.requestId, "unknown",
                    "Result missing; inspect planter / restart?", true, true);
    return;
  }
  const char *status = result["status"] | "";
  if (!status[0]) return;
  const bool complete = terminal(status);
  const bool expired = millis() - pending.commandStartedMs > kCommandResolveMs;
  if (!complete && expired) {
    commandResult(pending.requestId, "unknown", "Still no final result; inspect planter", true, true);
  } else {
    // An execution failure is still a confirmed final result. HTTP 200 means
    // the record was found; its status, not `ok`, determines completion.
    commandResult(pending.requestId, status, result["error"] | "", !complete);
  }
  // commandResult() checks the current ID under the mutex: an old GET cannot
  // overwrite a newer STOP request or a manual uncertainty acknowledgement.
}

void sendCalibration(const Command& command) {
  const auto state = planter::snapshot();
  if (!planter::fresh(state, millis()) || !state.calibrationWritable || !state.calibrationKnown ||
      state.networkRevision != command.networkRevision || command.networkRevision != device_settings::networkRevision() ||
      state.pumpOn || !state.pumpKnown) { calibrationResult(CalibrationWrite::Failed, "not_sent"); return; }
  robo::SensorCalibration candidate;
  const char* error = robo::applyCalibration(state.calibration, command.calibration, candidate);
  if (*error) { calibrationResult(CalibrationWrite::Failed, error); return; }
  const auto &edit = command.calibration;
  StaticJsonDocument<256> input;
  input["kind"] = edit.kind == robo::CalibrationKind::Soil ? "soil" : "tank";
  input["revision"] = edit.revision; input["reset"] = edit.reset;
  if (!edit.reset) {
    if (edit.kind == robo::CalibrationKind::Soil) { input["dry"] = edit.a; input["wet"] = edit.b; }
    else { input["full_mm"] = edit.a; input["empty_mm"] = edit.b; input["stop_mm"] = edit.c; }
  }
  WiFiClient client; HTTPClient http;
  if (!configureHttp(http, client, "/api/v1/calibration")) { calibrationResult(CalibrationWrite::Failed, "not_sent"); return; }
  http.addHeader("Content-Type", "application/json");
  String body; serializeJson(input, body);
  calibrationResult(CalibrationWrite::Saving);
  const int code = http.POST(body);
  if (code <= 0 || http.getSize() < 0 || http.getSize() > 1024) {
    http.end(); calibrationResult(CalibrationWrite::Unknown, "response_lost"); return;
  }
  const String response = http.getString(); http.end();
  StaticJsonDocument<512> result;
  if (deserializeJson(result, response) || !result["ok"].is<bool>()) {
    calibrationResult(CalibrationWrite::Unknown, "unverified_response"); return;
  }
  if (code == 200 && result["ok"].as<bool>() && result["revision"].is<uint32_t>() &&
      !result["revision"].is<bool>() && result["revision"].as<uint32_t>() == candidate.revision) {
    calibrationResult(CalibrationWrite::Saved);
  } else if (code >= 400 && code < 600 && !result["ok"].as<bool>()) {
    calibrationResult(CalibrationWrite::Failed, result["error"] | "save_failed");
  } else calibrationResult(CalibrationWrite::Unknown, "unverified_response");
}

void sendAutoLight(const Command& command) {
  const auto state=planter::snapshot();
  if(!planter::fresh(state,millis()) || !state.autoLightKnown || !state.autoLightAvailable || !state.autoLightWritable ||
    !state.pumpKnown || state.pumpOn || command.networkRevision!=state.networkRevision || command.networkRevision!=device_settings::networkRevision()) {
    autoLightResult(CalibrationWrite::Failed,"not_sent"); return;
  }
  const auto &settings=command.autoLight;
  if(settings.revision!=state.autoLight.revision || settings.revision==UINT32_MAX || !settings.valid()) {
    autoLightResult(CalibrationWrite::Failed,"settings_conflict");return;
  }
  WiFiClient client;HTTPClient http;
  if(!configureHttp(http,client,"/api/v1/auto-light")) { autoLightResult(CalibrationWrite::Failed,"not_sent");return; }
  StaticJsonDocument<256> input;
  input["enabled"]=settings.enabled;input["revision"]=settings.revision;
  input["on_below"]=settings.onBelow;input["off_above"]=settings.offAbove;
  String body;serializeJson(input,body);http.addHeader("Content-Type","application/json");
  autoLightResult(CalibrationWrite::Saving);
  const int code=http.POST(body);
  if(code<=0 || http.getSize()<0 || http.getSize()>1024) { http.end();autoLightResult(CalibrationWrite::Unknown,"response_lost");return; }
  const String response=http.getString();http.end();StaticJsonDocument<512> result;
  if(deserializeJson(result,response) || !result["ok"].is<bool>()) { autoLightResult(CalibrationWrite::Unknown,"unverified_response");return; }
  if(code==200 && result["ok"].as<bool>() && result["revision"].is<uint32_t>() && !result["revision"].is<bool>() && result["revision"].as<uint32_t>()==settings.revision+1)autoLightResult(CalibrationWrite::Saved);
  else if(code>=400 && code<600 && !result["ok"].as<bool>())autoLightResult(CalibrationWrite::Failed,result["error"]|"save_failed");
  else autoLightResult(CalibrationWrite::Unknown,"unverified_response");
}

void sendCommand(const Command &command) {
  if(command.lightSettingsWrite) { sendAutoLight(command); return; }
  if (command.calibrationWrite) { sendCalibration(command); return; }
  if (WiFi.status() != WL_CONNECTED || !device_settings::planterNetworkReady() ||
      command.networkRevision != device_settings::networkRevision()) {
    commandResult(command.id, "not_sent", "Planter network unavailable or changed; no retry", false); return;
  }
  // Recheck capability and freshness just before transmission.
  const State state = planter::snapshot();
  if (strcmp(state.requestId, command.id)) return; // superseded by STOP
  const bool stop = command.action == Action::StopWater;
  const bool enabled = isPairing(command.action) ? state.yoyoEnabled : command.action==Action::AutoPrint ? state.autoPrintKnown : isFocus(command.action) ? state.focusKnown : (command.action == Action::Water || stop) ? state.pumpEnabled :
                       command.action == Action::Light ? state.lightEnabled : state.printerEnabled;
  if (!enabled || (command.action == Action::Water && !state.waterAllowed) || (!stop && !planter::fresh(state, millis()))) {
    commandResult(command.id, "not_sent", "Unavailable or stale device state", false); return;
  }
  if(command.action==Action::RepairYoyo && (!state.yoyoRepairSupported || !state.yoyoPaired || state.yoyoLinkConnected || state.yoyoRepairing)) {
    commandResult(command.id,"not_sent","Disconnect phone before repairing pairing",false);return;
  }
  if(command.action==Action::ReconnectYoyo && (!state.yoyoReconnectSupported || !state.yoyoPaired || state.yoyoRepairing || state.yoyoReconnecting)) {
    commandResult(command.id,"not_sent","Phone reconnect unavailable",false);return;
  }
  if (command.action == Action::Print && (!strcmp(state.printerStatus, "recovery_required") ||
      (command.receipt.requiresRaster && !state.printerRaster) ||
      (command.receipt.layout32 && !state.printerLayout32) ||
      (command.receipt.isDaily && !state.printerDaily))) {
    commandResult(command.id, "not_sent", "Printer needs recovery or a new preview", false); return;
  }
  StaticJsonDocument<1024> doc;
  doc["request_id"] = command.id;
  switch (command.action) {
    case Action::PairYoyo:doc["action"]="pair_yoyo";break;
    case Action::RepairYoyo:doc["action"]="repair_yoyo";break;
    case Action::ReconnectYoyo:doc["action"]="reconnect_yoyo";break;
    case Action::AutoPrint:doc["action"]="auto_print";doc["on"]=command.on;break;
    case Action::FocusStart:doc["action"]="focus_start";doc["duration_ms"]=uint32_t(command.focusMinutes)*60000;break;
    case Action::FocusPause:doc["action"]="focus_pause";break;
    case Action::FocusResume:doc["action"]="focus_resume";break;
    case Action::FocusReset:doc["action"]="focus_reset";break;
    case Action::Water:
      doc["action"] = "water";
      doc["duration_ms"] = PLANTER_WATER_DURATION_MS;
      break;
    case Action::StopWater: doc["action"] = "stop_water"; break;
    case Action::Light: doc["action"] = "light"; doc["on"] = command.on; break;
    case Action::Print:
      if(command.receipt.isDaily){doc["action"]="print_daily";robo::writeDaily(doc.createNestedObject("daily"),command.receipt.daily);}
      else {doc["action"] = "print";doc["text"] = command.receipt.text;}
      break;
  }
  String body;
  serializeJson(doc, body);
  WiFiClient client;
  HTTPClient http;
  if (!configureHttp(http, client, "/api/v1/command")) {
    commandResult(command.id, "not_sent", "Invalid HTTP configuration", false); return;
  }
  http.addHeader("Content-Type", "application/json");
  commandResult(command.id, "sending", "", true);
  const int code = http.POST(body);
  // Never retry an ambiguous POST, including transport failures or redirects.
  if (code <= 0 || http.getSize() < 0 || http.getSize() > 2048) {
    http.end();
    commandResult(command.id, "unknown", "Response lost; no automatic retry", true, true);
    return;
  }
  const String response = http.getString();
  http.end();
  StaticJsonDocument<1024> result;
  if (deserializeJson(result, response) || !result["ok"].is<bool>() ||
      strcmp(result["request_id"] | "", command.id)) {
    commandResult(command.id, "unknown", "Unverified response; check planter", true, true);
    return;
  }
  const bool ok = result["ok"].as<bool>() && code >= 200 && code < 300;
  const char *status = result["status"] | (ok ? "accepted" : "rejected");
  commandResult(command.id, ok ? status : "rejected", result["error"] | "",
                ok && !terminal(status));
}

void networkTask(void *) {
  uint32_t nextPoll = 0;
  for (;;) {
    Command command;
    // STOP has its own one-element queue and is serviced before other work.
    if (xQueueReceive(stops, &command, 0) == pdTRUE) {
      xQueueReset(commands);
      if (planter::snapshot().calibrationWrite == CalibrationWrite::Queued) calibrationResult(CalibrationWrite::Failed, "cancelled");
      if(planter::snapshot().autoLightWrite==CalibrationWrite::Queued)autoLightResult(CalibrationWrite::Failed,"cancelled");
      sendCommand(command);
      // Keep settings from invalidating this STOP between enqueue and POST.
      // Release on every result, including not_sent/unknown; never replay it.
      device_settings::releaseNetworkAfterStop();
      nextPoll = 0;
    }
    // Settings service owns the Wi-Fi API. Scanning, switching and connection
    // timeout/retry handling never run in the display/touch task.
    device_settings::service();
    network_setup::service();
    // Transition-only diagnostics; never log SSID, password, IP or token.
    const auto wifiStatus = device_settings::wifiState();
    const unsigned statusBits = unsigned(wifiStatus.phase) | (unsigned(wifiStatus.error) << 4) |
                                (unsigned(wifiStatus.saved) << 12) | (unsigned(wifiStatus.planterNetwork) << 13);
    static unsigned lastStatusBits = ~0U;
    if (statusBits != lastStatusBits) {
      lastStatusBits = statusBits;
      Serial.printf("Indicator Wi-Fi: phase=%u error=%u saved=%u storage=%u trusted=%u\n",
                    unsigned(wifiStatus.phase), unsigned(wifiStatus.error), unsigned(wifiStatus.saved),
                    unsigned(wifiStatus.persistenceAvailable), unsigned(wifiStatus.planterNetwork));
    }
    const uint32_t currentNetwork = device_settings::networkRevision();
    const bool planterNetwork = device_settings::planterNetworkReady();
    {
      xSemaphoreTake(lock, portMAX_DELAY);
      if (shared.networkRevision != currentNetwork) {
        shared.networkRevision = currentNetwork;
        shared.ageKnown = false;
        shared.pumpKnown = shared.pumpEnabled = false;
        shared.lightKnown = shared.lightEnabled = false;
        shared.printerKnown = shared.printerEnabled = false;
        if (shared.commandBlocked && !terminal(shared.commandStatus) &&
            strcmp(shared.commandStatus, "queued") && strcmp(shared.commandStatus, "sending")) {
          shared.uncertain = true;
          copy(shared.commandStatus, "unknown");
          copy(shared.commandError, "Wi-Fi changed; inspect planter; no retry");
        }
        nextPoll = 0;
      }
      shared.wifi = planterNetwork;
      if (refreshRequested) { nextPoll = 0; refreshRequested = false; }
      xSemaphoreGive(lock);
    }
    if (xQueueReceive(commands, &command, 0) == pdTRUE) {
      sendCommand(command);
      nextPoll = 0;
    }
    const uint32_t now = millis();
    if (planterNetwork && WiFi.status() == WL_CONNECTED) {
      if (!nextPoll || static_cast<int32_t>(now - nextPoll) >= 0) {
        { xSemaphoreTake(lock, portMAX_DELAY); checking=true; xSemaphoreGive(lock); }
        uploadSoil();
        pollState();
        pollCommandResult();
        { xSemaphoreTake(lock, portMAX_DELAY); checking=false; xSemaphoreGive(lock); }
        // Keep the period anchored to the start of this cycle. Adding another
        // full second after three HTTP operations made relayed soil expire
        // between otherwise successful uploads. Slow/failed transfers still
        // expire normally; do not lengthen the sensor freshness limit.
        nextPoll = now + kPollIntervalMs;
      }
    } else {
      const auto wifi = device_settings::wifiState();
      networkError(wifi.phase == device_settings::WifiPhase::Connected ?
                   "Wi-Fi connected; configured planter network not selected" :
                   "Planter Wi-Fi offline; open Wi-Fi settings");
    }
    vTaskDelay(pdMS_TO_TICKS(25));
  }
}
}

namespace planter {
bool begin() {
  if (!device_settings::begin()) return false;
  if(!network_setup::begin()){device_settings::workerStartupFailed();return false;}
  lock = xSemaphoreCreateMutex();
  commands = xQueueCreate(1, sizeof(Command));
  stops = xQueueCreate(1, sizeof(Command));
  bootNonce = esp_random();
  if (lock && commands && stops &&
      xTaskCreatePinnedToCore(networkTask, "planter-http", 16384, nullptr, 1, nullptr, 0) == pdPASS) return true;
  // No worker exists, so requests must not remain accepted/Connecting forever.
  if (stops) vQueueDelete(stops);
  if (commands) vQueueDelete(commands);
  if (lock) vSemaphoreDelete(lock);
  stops = commands = nullptr; lock = nullptr;
  device_settings::workerStartupFailed();
  return false;
}
State snapshot() {
  State out;
  if (!lock) return out;
  xSemaphoreTake(lock, portMAX_DELAY);
  out = shared;
  out.checking = checking || refreshRequested;
  xSemaphoreGive(lock);
  // A Wi-Fi selection may be queued while the worker is awaiting HTTP. Disable
  // controls immediately; do not reuse the previous network's capabilities.
  if (out.networkRevision != device_settings::networkRevision() || !device_settings::planterNetworkReady()) {
    out.wifi = false;
    out.pumpEnabled = out.lightEnabled = out.printerEnabled = false;
  }
  return out;
}
bool fresh(const State &state, uint32_t now) {
  return state.received && state.wifi && state.ageKnown && state.networkFailure == NetworkFailure::None &&
         state.networkRevision == device_settings::networkRevision() && device_settings::planterNetworkReady() &&
         static_cast<uint64_t>(now - state.receivedMs) + state.sampleAgeMs <= kStaleMs;
}
bool requestRefresh() {
  if (!lock || !device_settings::planterNetworkReady()) return false;
  xSemaphoreTake(lock, portMAX_DELAY);
  const bool accepted = !refreshRequested && !checking;
  if (accepted) refreshRequested = true;
  xSemaphoreGive(lock);
  return accepted;
}
bool submit(Action action, bool lightOn, const PrintReceipt *receipt, uint16_t focusMinutes) {
  if(isFocus(action) && (focusMinutes<1 || focusMinutes>120))return false;
  if (!lock || !commands || !stops) return false;
  if (action == Action::Print && (!receipt || (receipt->isDaily ? !robo::validDaily(receipt->daily) : (!receipt->text[0] || !memchr(receipt->text, 0, sizeof(receipt->text)))))) return false;
  xSemaphoreTake(lock, portMAX_DELAY);
  const bool stop = action == Action::StopWater;
  const bool enabled = isPairing(action) ? shared.yoyoEnabled : action==Action::AutoPrint ? shared.autoPrintKnown : isFocus(action) ? shared.focusKnown : (action == Action::Water || stop) ? shared.pumpEnabled :
                       action == Action::Light ? shared.lightEnabled : shared.printerEnabled;
  if (!enabled || (action==Action::ReconnectYoyo && (!shared.yoyoReconnectSupported || !shared.yoyoPaired || shared.yoyoRepairing || shared.yoyoReconnecting)) || (action==Action::RepairYoyo && (!shared.yoyoRepairSupported || !shared.yoyoPaired || shared.yoyoLinkConnected || shared.yoyoRepairing)) || !shared.wifi || shared.networkRevision != device_settings::networkRevision() ||
      (action == Action::Water && !shared.waterAllowed) ||
      !device_settings::planterNetworkReady() || (!stop && (!fresh(shared, millis()) || shared.commandBlocked || calibrationBusy(shared.calibrationWrite) || calibrationBusy(shared.autoLightWrite))) ||
      (action == Action::Print && (!strcmp(shared.printerStatus, "recovery_required") ||
       (receipt->requiresRaster && !shared.printerRaster) ||
       (receipt->layout32 && !shared.printerLayout32) ||
       (receipt->isDaily && (!shared.printerDaily || !robo::validDaily(receipt->daily)))))) {
    xSemaphoreGive(lock); return false;
  }
  Command command{};
  command.action = action; command.on = lightOn; command.networkRevision = device_settings::networkRevision();
  command.focusMinutes=focusMinutes;
  if (action == Action::Print) command.receipt = *receipt;
  // Acquire under the settings lock after the checks above: a concurrent UI
  // network change either wins first (STOP rejected) or waits for this STOP.
  // Client -> settings is the only nested lock order. Duplicate pending STOPs
  // are rejected so one reservation always belongs to exactly one queue item.
  if (stop && !device_settings::reserveNetworkForStop(command.networkRevision)) {
    xSemaphoreGive(lock); return false;
  }
  snprintf(command.id, sizeof(command.id), "screen-%08lx-%08lx",
           static_cast<unsigned long>(bootNonce), static_cast<unsigned long>(++sequence));
  const BaseType_t queued = stop ? xQueueOverwrite(stops, &command) : xQueueSend(commands, &command, 0);
  if (queued == pdTRUE) {
    copy(shared.requestId, command.id);
    copy(shared.commandStatus, "queued");
    copy(shared.commandError, "");
    shared.commandBlocked = true;
    shared.uncertain = false;
    shared.commandStartedMs = millis();
  }
  else if (stop) device_settings::releaseNetworkAfterStop();
  xSemaphoreGive(lock);
  return queued == pdTRUE;
}
bool submitCalibration(const robo::CalibrationEdit& edit) {
  if (!lock || !commands) return false;
  xSemaphoreTake(lock, portMAX_DELAY);
  robo::SensorCalibration candidate;
  const bool allowed = fresh(shared, millis()) && shared.calibrationKnown && shared.calibrationWritable &&
    shared.pumpKnown && !shared.pumpOn && !shared.commandBlocked && !calibrationBusy(shared.calibrationWrite) && !calibrationBusy(shared.autoLightWrite) &&
    !*robo::applyCalibration(shared.calibration, edit, candidate);
  Command command{};
  command.calibrationWrite = true; command.calibration = edit; command.networkRevision = shared.networkRevision;
  const bool queued = allowed && xQueueSend(commands, &command, 0) == pdTRUE;
  if (queued) {
    shared.calibrationWrite = CalibrationWrite::Queued; shared.calibrationError[0] = 0;
    lastCalibrationEdit = edit; calibrationNetwork = shared.networkRevision;
  }
  xSemaphoreGive(lock); return queued;
}
bool submitAutoLight(const robo::AutoLightSettings& settings) {
  if(!lock || !commands || !settings.valid() || settings.revision==UINT32_MAX)return false;
  xSemaphoreTake(lock,portMAX_DELAY);
  const bool allowed=fresh(shared,millis()) && shared.autoLightKnown && shared.autoLightAvailable && shared.autoLightWritable &&
    shared.pumpKnown && !shared.pumpOn && !shared.commandBlocked && !calibrationBusy(shared.autoLightWrite) &&
    !calibrationBusy(shared.calibrationWrite) && settings.revision==shared.autoLight.revision;
  Command command{};command.lightSettingsWrite=true;command.autoLight=settings;command.networkRevision=shared.networkRevision;
  const bool queued=allowed && xQueueSend(commands,&command,0)==pdTRUE;
  if(queued) {
    shared.autoLightWrite=CalibrationWrite::Queued;shared.autoLightError[0]=0;
    lastAutoLight=settings;++lastAutoLight.revision;autoLightNetwork=shared.networkRevision;
  }
  xSemaphoreGive(lock);return queued;
}
void acknowledgeUncertain() {
  if (!lock) return;
  xSemaphoreTake(lock, portMAX_DELAY);
  if (shared.uncertain) {
    shared.commandBlocked = false;
    shared.uncertain = false;
    copy(shared.commandStatus, "acknowledged");
    copy(shared.commandError, "Unknown outcome acknowledged; no retry");
    // Do not let a later nonterminal state re-lock an acknowledged result.
    shared.requestId[0] = 0;
  }
  xSemaphoreGive(lock);
}
}
