peterpanstechland/RoboPlanter/firmware/indicator/include/config.h

#pragma once
#if __has_include("local_config.h") && !defined(RP_HOST_FIXTURE)
#include "local_config.h"
#endif
#ifndef PLANTER_DEVICE_ID
#define PLANTER_DEVICE_ID ""
#endif
#ifndef PLANTER_SETUP_PASSWORD
#define PLANTER_SETUP_PASSWORD ""
#endif
#ifndef PLANTER_WIFI_SSID
#define PLANTER_WIFI_SSID "RoboPlanter-XXXX"
#endif
#ifndef PLANTER_ENABLE_LOCAL_SOIL
#define PLANTER_ENABLE_LOCAL_SOIL 0
#endif
#ifndef PLANTER_WIFI_PASSWORD
#define PLANTER_WIFI_PASSWORD "planter-demo"
#endif
#ifndef PLANTER_BASE_URL
#define PLANTER_BASE_URL "http://192.168.4.1"
#endif
#ifndef PLANTER_DEVICE_TOKEN
#define PLANTER_DEVICE_TOKEN "change-me-before-use"
#endif
#ifndef PLANTER_WATER_DURATION_MS
#define PLANTER_WATER_DURATION_MS 2000
#endif
constexpr unsigned kHttpTimeoutMs = 1500;
constexpr unsigned kPollIntervalMs = 1000;
constexpr unsigned kStaleMs = 5000;
// 32px receipts can take about 20 seconds at 9600 baud, plus device margin.
constexpr unsigned kCommandResolveMs = 100000;
static_assert(PLANTER_WATER_DURATION_MS > 0 && PLANTER_WATER_DURATION_MS <= 10000,
              "Manual watering pulse must be 1..10000 ms");
