peterpanstechland/RoboPlanter/(commit log)

2026-10-23 Add RoboPlanter firmware, YOYO MCP integration, and companion UI
    [partitions.csv]
2026-10-24 Fix Indicator display flicker with offscreen frame composition
    [main.cpp]
2026-10-24 Redesign Indicator as an animated pixel desk companion
    [indicator_render.cpp, main.cpp]
2026-10-24 Swap Indicator frames at VSYNC without copying active scanout
    [indicator_render.cpp, main.cpp]
2026-10-24 Use a thin outline settings gear on Indicator
2026-10-25 Add competition experience, hardware handbook and device onboarding kit
2026-10-25 Add on-demand Tripo all-in-one model to landing page
2026-10-25 Track vendored Three.js runtime for the product viewer
2026-10-25 Record verified Tripo landing deployment
2026-10-25 Add interactive 3D wiring workshop to landing page
2026-10-25 Record verified wiring workshop deployment
2026-10-25 Integrate verified planter hardware links and wiring guidance
2026-10-26 Fix printer boot noise with D8 UART and verify receipt output
    [config.local.example.h, main.cpp, robo_config.h]
2026-10-28 Record verified Chinese printing, autocutter and Indicator hardware upgrade
2026-10-28 Record successful Indicator printing and pending typography feedback
2026-10-28 Record receipt typography firmware upload and restored device link
2026-10-28 Add 78-card garden daily tickets and fix compressed printer raster
    [config.h, controller.h, indicator_render.cpp, main.cpp, planter_client.cpp, planter_client.h]
2026-10-28 Add DHT20 sensing and stabilize Indicator soil relay
    [config.local.example.h, main.cpp, planter_client.cpp, robo_config.h]
2026-10-28 Integrate SEN54 and ultrasonic sensing with guarded relay control
2026-10-29 Add companion scenes, shared focus timer, and bonded BLE pilot
2026-10-29 Clarify BLE pairing code flow and record successful YOYO reads
2026-10-29 Update handbook and wiring for current SEN54 and bonded YOYO setup
2026-10-29 Include current sensor and companion test sources in public kit
2026-10-29 Add persistent soil and tank calibration from Indicator settings
2026-10-29 Record calibration persistence and restored display verification
2026-10-29 Add persistent automatic light settings and document enabled pump
2026-10-31 Refresh landing page with Creeper voxel design and official hardware gallery
2026-11-03 Add validated BLE receipt printing fallback for EM5826H
2026-11-03 Pace BLE receipt writes and improve printer rediscovery
2026-11-03 Add XIAO BLE printer transport alongside bonded YOYO control
2026-11-03 Record successful Indicator to BLE printer acceptance
2026-11-03 Restore bonded security mode after setting pairing PIN
2026-11-03 Use calibrated soil percentage in YOYO skill
2026-11-03 Record calibrated soil skill submission for private review
2026-11-03 Expose ultrasonic echo diagnostics without relaxing tank guard
2026-11-03 Record ultrasonic voltage readings and timeout observations
2026-11-03 Add selectable ranger pin and armed echo edge diagnostics
2026-11-03 Add ultrasonic trigger level readback diagnostics
2026-11-03 Add bare-board GPIO reference and I2C isolation checks
2026-11-03 docs: reconcile delivery snapshot with current hardware and skill status
2026-11-03 fix: complete reproducible source kit and refresh wiring snapshot
2026-11-04 Make device connection recovery visible and preserve phone bonds
2026-11-04 Add device Wi-Fi setup and restore ultrasonic sensing on D7
2026-11-04 Return calibrated soil percentages to YOYO by default
2026-11-13 Add English project experience, build handbook and Hackster materials
    [Body16.3mf, Body8.3mf, Body9.3mf]
2026-11-13 Rewrite Chinese project story and clarify current interaction status
